tommyrohmann/Microgravity-Press-Washing-Machine/Code/ESP Pinout.jpg

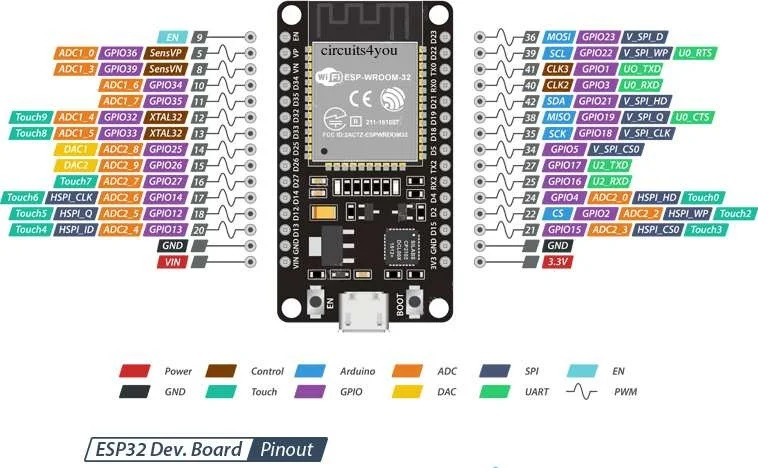
Code/ESP Pinout.jpg
