tommyrohmann/Microgravity-Press-Washing-Machine/Code/Dev/fb3f23a709487965b63c21f0c4c082e6.png

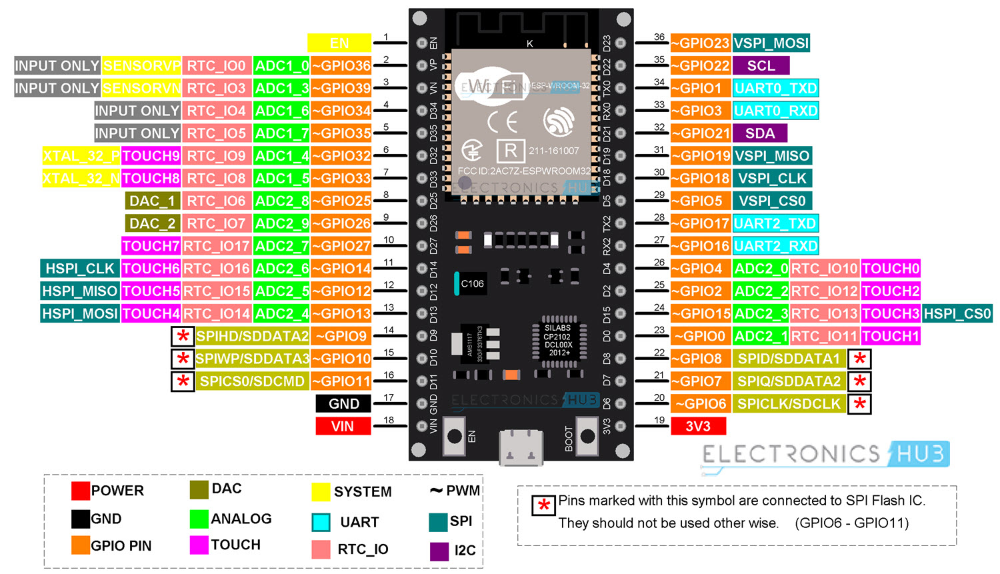
Code/Dev/fb3f23a709487965b63c21f0c4c082e6.png
