tommyrohmann/Microgravity-Press-Washing-Machine/ESP32 Pinout.pptx

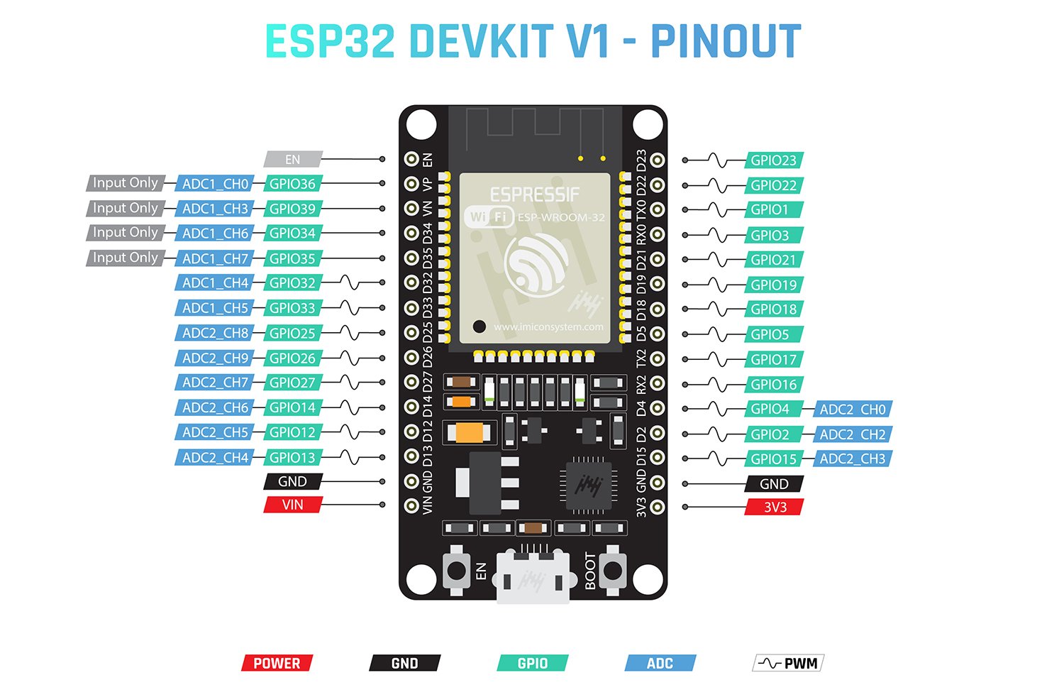
[picture p3: figure]
Esp32 Devkit V1 Pinout And Specification 58 Off/esp32 Analog Pinout
