tommyrohmann/Microgravity-Press-Washing-Machine/CAD Design Work/Electronics/Model Sources.docx

https://grabcad.com/library/raspberry-pi-4-model-b-1
