tommyrohmann/Microgravity-Press-Washing-Machine/Other/Showcase Files/06-12-24/Scope Of Design 2023.docx

Scope of Design for Microgravity Press Washing Machine 2023

Previous iterations of the Microgravity Press Washing Machine have all been to prove various aspects of the design without accounting for select criteria that were not determined to be critical to the working principle or concept.

The current iteration of this design is designed to fulfill all initial criteria for the Microgravity Washing Machine problem while successfully carrying out the full wash cycle in a controlled, automated, and repeatable manner.

Though the prototype built in this stage of development will not have certain hardware functions identified to be advantageous to the design, the core function of the washing machine will be fully realized, and will serve as a fundamental base-line for this project. This baseline will inform which hardware improvements must be made to the design to further improve on the concept in later versions.

In summation, this prototype will serve as a baseline for the fundamental functions of the design, and allow for ease of experimentation and pertinent data collection. This design will be made to be iterated on in various directions depending on the results of the given experiments.
