tommyrohmann/Microgravity-Press-Washing-Machine/Documentation Files.docx

Washing machine documentation:

Definitions

- Dead volume etc

Working Principles

- Wash process
- Fluid separation and avoiding free surface effects
- Compression force vs fluid pressure

PV=nRT

P_1 V_1 =P_2 V_2

V=C-S

P_1 (C_1 -S)=P_2 (C_2 -S)

P_1 C_1 -P_1 S=P_2 C_2 -P_2 S

P_2 S-P_1 S=P_2 C_2 -P_1 C_1

S=(P_2 C_2 -P_1 C_1)/(P_2 -P_1)

Procedure:

Pre-wash leak check: pull vacuum on chamber, wait preset time, if vacuum maintained continue, if not throw error.

At beginning piston position, internal volume is known. Measure pressure (ambient)

Compress piston by known amount, leaving a known chamber volume. Measure pressure.

Calculate true volume.

Compress clothing item to maximum compression. Known piston location, yields compressed volume

If compressed volume is not large compared to true volume, compression not sufficient and throw error.

Compressed volume-true volume=dead volume

Add known machine dead volume in pipes.

For the target cleanliness (say deep clean is 95%, standard 80%, economy 60%, roughing wash 40% etc.), find required water for given load size.

Run wash cycle with given water allowance

P_2

P_1

C_2

C_1

V_T =Unknown volume of clothing itme

VT: True Volume,
VC: Compressed Volume
VD: Dead Volume,
VH: Heap Volume

The floating piston washing machine washes clothing by means of slow speed fluid displacement and compression. Moving fluids allows for control over how different fluids are moved through the machine to support the wash process. During a wash process, the clothing item has water introduced, is agitated, and then has water removed to accomplish the goal of cleaning soiled clothing.

Displacement and compression are accomplished by the wash pump, which pumps water to either side of the wash piston. When compressing the clothing item, water is pumped into the reservoir under high pressure, which compresses the clothing item.

P&ID Diagram

Electrical diagram

Control Loop

The washing machine follows wash instructions as a simple state machine. An individual step of the wash process includes instructions as to output values that control which valves should be open, or which pump should be running, and a specified sensor and value which corresponds with the end of the current step. Once the end condition of a given step in the wash cycle, the next set of instructions is read and carried out until the wash cycle is complete.

For various clothing items and desired cleanliness, multiple wash cycles and variations of a given wash cycle could be desired by the user. To accommodate this, the automation of the washing machine is accomplished by reading an instruction file, which is human readable and editable in excel or software capable of reading .xsml files.

When the washing machine reads and executes the wash process, it is accomplished in a set of steps

Load selected human wash instruction file as pandas data frame

Select first line of instructions

Preprocessing of the selected wash step and interpret instructions

Package instruction set and send to microcontroller

Telemetry loop

When end state is detected, select next set of wash instructions to be interpreted

Sample wash process:

List of end effectors

Valves

3-way valve air vent/vacuum

Downstream 3-way wash pump reversing valve

Upstream 3-way wash pump reversing valve

Wash chamber valve

Clean/inlet valve

Soiled/outlet valve

Reservoir-space vale

Compensations-pace Valve

Wash pump

Vacuum pump

Detergent pump

Not included

Water heater

Hatch lock solenoid

Retention tank valve

Sensors

Wash chamber pressure transducer

Reservoir pressure transducer

Estop

Not included

Flow meter

Piston positional sensor

Interseal leak transducer

UI control screen

Manual mode – run everything by pressing toggle buttons on raspberry pi

Wash cycle select

settings

Run process

Telemetry screen

Pause process

Stop process

Wash Process Functions

Determination of dead volume

Water budget

Target cleanliness
