tommyrohmann/Microgravity-Press-Washing-Machine/NASA Meeting 05-19-2023/Project Update Slideshow.pptx

## Microgravity Washing Machine Project Update

## Personal Background

2019-2020 NASA HUNCH Design Competition Semi-Finalist from Glenelg High School
Currently studying for B.E. Naval Architecture with USCG Unlimited Engine License at SUNY Maritime College, going into senior year

## Progress Since NASA HUNCH 2019-2020

1st Prototype: More to demonstrate design features groupmates did not believe would work. Initially getting
2nd Prototype: Prototype designed to test design efficacy disregarding project constraints
Prototype Design Testing: Determine

## What Has Changed Since Starting the Project?

Project Requirements
- 1000 mL of water allowance for washing 1 clothing
- Detergents for space became a possibility
Washing Machine Design
- Compression found to be instrumental to agitation
- Orientation of washing machine components

## Design Process for Prototype

Multiple parts of the design can be built independently from other design aspects, these include:
1. Frame and structural assembly
2. Drive system for the pistons
3. Electronic control system
4. System piping

## Design Frame and Structure

From loading requirements:
1. Given EXPRESS Locker dimensions, design frame maximizing space in vertical direction of piston travel
2. Use frame dimensions to determine piston travel and get maximized dimensions for wash chamber

## What is Needed for This Project to Move Forward

- Time
- Consultation on Design Features and Prototype Creation
