tommyrohmann/Microgravity-Press-Washing-Machine/Other/Sort/iLogic.docx

ILogic

04 AUTODESK INVENTOR ilogic Tutorial ( Variables ) (youtube.com) (https://www.youtube.com/watch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)

Tutorial Inventor - 151 iLogic for Assemblies (youtube.com) (https://www.youtube.com/watch?v=YDInUcrTcwk&ab_channel=ConstantinStancescu)

Inventor Animations

Inventor 2014 Help: Studio - Animations (autodesk.com) (https://help.autodesk.com/view/INVNTOR/2014/ENU/?guid=GUID-D4E8F0DD-F622-43EA-BD6F-A0DBB6025F49)

Modal Stress Analysis

Inventor 2014 Help: Part Modal and Stress Analysis (autodesk.com) (https://help.autodesk.com/view/INVNTOR/2014/ENU/?guid=GUID-ADEAAB90-A0B9-4663-A066-2C124827DB8D)

Sheet Metal

Inventor 101: Sheet Metal Basics | Autodesk Virtual Academy (youtube.com) (https://www.youtube.com/watch?v=wMrZ-nHitSo&ab_channel=KETIVTechnologies)

Tube and Pipe

Using Tube & Pipe in Inventor Professional 2021 | Autodesk Virtual Academy (youtube.com) (https://www.youtube.com/watch?v=IEURRpiXw0A&ab_channel=KETIVTechnologies)
