tommyrohmann/Microgravity-Press-Washing-Machine/Other/Sort/Temp.docx

https://ntrs.nasa.gov/api/citations/20220006013/downloads/Clothes%20Cleaning%20for%20Space%20Research%20ICES%202022%20-%20Final.pdf

Tide Infinity was also designed to use 15 liters of water per load or less to wash roughly 4.5-5.0 kg (10-11 lbs.) of clothing twice a week for a crew of 4.
