tommyrohmann/Microgravity-Press-Washing-Machine/Wash Cycle Papers/Drying Cycle Capabilities.docx

# Drying Cycle Capabilities

Tommy Rohmann 2026

Flash Drying

For each clothing item, there is a maximum amount of water that can be removed by compression. From this point the clothing item can be taken out to dry.

Alternatively, a drying cycle could be utilized to remove more water. This can be done utilizing the existing vacuum pump used to evacuate air.

The piston can be retracted, drawing in a small amount of air to prevent water from coalescing into droplets. A vacuum can be drawn using the vacuum pump. At this lower pressure, the boiling point of the water is decreased. Under vacuum, the temperature of saturated steam can be as low as 54 degrees F. More realistically, a maintained vacuum of 28 hg can be maintained, making the boiling point of water between 70 F and 100 F. Although using a heating element would use a significant amount of power

Vacuum can again be drawn on the wash chamber

If the water is heated
