tommyrohmann/Microgravity-Press-Washing-Machine/Pinout.xlsx

D/A/PWM/internal | I/O | Pin Assignment | Instruction Label | Use | Notes
pwm | O | 32 | oVA | Air/Vacuum Selector V/v | 3-Way
pwm | O | 33 | oVR1 | Wash Pump Reversal V/v #1 | 3-Way
pwm | O | 25 | oVR2 | Wash Pump Reversal V/v #2 | 3-Way
pwm | O | 26 | oVWC | Wash Chamber V/v | 2-Way
pwm | O | 27 | oVCW | Clean wtr In V/v | 2-Way
pwm | O | 14 | oVSW | Soil wtr out V/v | 2-Way
pwm | O | 12 | oVRT | Reservoir Tk V/v | 2-Way
pwm | O | 13 | oVCT | Compression Tk V/v | 2-Way
D | O | 21 | oPW | Wash Pump
D | O | 22 | oPV | Vacuum Pump
D | O | 19 | oPD | Detergent Pump
D | O | 23 | oVB | V/V Adj Bus Relay | Normally Open, Unused in Wash Instructions, controlled by microcontroller
D | I | 35 | iES | E-Stop detect
- | - | 34 | - | Sensor unused
A | I | 39 | iPT1 | Wash Chamber Press Transducer | VN input only pin
A | I | 36 | iPT2 | Tank Press Transducer | VP input only pin
internal | - | - | iT | Time
internal | - | - | idT | Change in Time | Internally Found
internal | - | - | iTS | Start Time of Instruction Execution
