tommyrohmann/Microgravity-Press-Washing-Machine/System Design and Documentation/Electronic Control Systems/mgpws_working_code/Dev Aid Files/MachineConfig/Config Layout.xlsx

Sheet: Software_Config
Constants | Global Base Folder File Path | NA
 | Data Storage Location | NA
 | Wash Process Instructions Location | NA
 | PreProcess Instructions Location | NA | Set of Instruction checks done every time a wash is initiated
Variables | Machine_Run_Hours | 0
 | Machine_Idle_Hours | 0
 | Wash_Counter | 0
 | Default_Wash_Cycle_Name | Default_Wash

Sheet: Sensor_Value_Return_Format
Index | Sensor_Name | Variable_Name | Var_Type | Units | Sensor State
1 | Wash_Phase_Status | WPS | int | NA
2 | Reservoir Pressure | P_Res | float | PSI
3 | Wash Chamber Pressure | P_Wash | float | PSI
4 | Load Cell 1 | LC_Wash_1 | int | lbf
5 | Load Cell 2 | LC_Wash_2 | int | lbf
6 | Load Cell 3 | LC_Res_1 | int | lbf
7 | Load Cell 4 | LC_Res_2 | int | lbf
8 | Net Force Wash Piston | NF_W | int | lbf | Derived - Absolute value of Net Force
9 | Net Force Reservoir Piston | NF_R | int | lbf | Derived- Absolute value of Net Force
10 | Delta Force Wash Piston | DR_W | int | lbf | Derived- Absolute value of Delta Force
11 | Delta Force Reservoir Piston | DF_R | int | lbf | Derived- Absolute value of Delta Force
12 | Valve Actuator Current Sensor | CS_VV | float | amps
13 | Washing Machine Current Sensor | CS_WS | float | amps
14 | Wash Rotary Encoder | RE_Wash | int | in
15 | Reservoir Rotary Encoder | RE_Res | int | in
16 | Reservoir Full Retract Limit Switch | LS_RFR | int | bool | Digital High, Depresses Switch Opens Circuit
17 | Piston Travel Conflict Limit Switch | LS_PTC | int | bool | Digital High, Depresses Switch Opens Circuit
18 | Wash Full Extend Limit Switch | LS_WFE | int | bool | Digital High, Depresses Switch Opens Circuit
19 | Emergency Stop | E_Stop | int | bool | Digital Low, Depressed Switch Control Closes Circuit
20 | Wash Chamber Limit Switch | Wash_Chamber_LmSw | int | bool | Digital High, Depresses Switch Opens Circuit
21 | Wash Phase Elapsed Time | ET | int | ms | T=0 at Start of Sub-Phase
22 | Total Elapsed Time | TET | int | ms | T=0 at Start of Process

Sheet: RPI_Phys_Conn_Config
Function | Connection Type
Touch Screen | Ribbon Cable
Serial Bus 1 TX | USB
Serial Bus 1 RX | USB
Stop Signal Send | W
Reset Signal | W | High, Low Resets
Power | PWR
Ground | GND

Sheet: Wash_Instruct_File_Format
Function | Collumn_Index | Actuator_Name | Variable_Name | Data_Type | Data_Mode
Metadata/Display | 1 | Wash State Name | WSN | str | [Name of Wash State in Cycle]
Metadata/Display | 2 | Sub State Name | SSN | str | [Substate of Wash State]
ESP Instructions | 3 | Washwater Inlet Valve | VA_WWI | int | [OPEN/CLOSED]
ESP Instructions | 4 | Washwater Outlet Valve | VA_WWO | int | [OPEN/CLOSED]
ESP Instructions | 5 | Cross-over Valve | VA_XO | int | [OPEN/CLOSED]
ESP Instructions | 6 | Air Valve | VA_A | int | [OPEN/CLOSED]
ESP Instructions | 7 | Valve Bus | VB | int | [ON/OFF]
ESP Instructions | 8 | Wash Piston Drive Motor | DM_Wash | arr | ([FWD/REV/OFF],[Speed])
ESP Instructions | 9 | Reservoir Piston Drive Motor | DM_Res | arr | ([FWD/REV/OFF],[Speed])
ESP Instructions | 10 | DetergentDosingPump | P_DD | int | [ON/OFF]
ESP Instructions | 11 | Next State Trigger | NST1 | arr | (([Sensor Index],[<,>],[Value]),…)
ESP Instructions | 12 | Next State Trigger | NST2 | arr | (([Sensor Index],[<,>],[Value]),…)
ESP Instructions | 13 | State Specific Safety Trigger | S3T | arr | (([Sensor Index],[<,>],[Value]),…)
