tommyrohmann/Microgravity-Press-Washing-Machine/Code/Dev/Software Layout Explainer.docx

## Config Directory

Functional Files required for washing machine operation

### BootData

This section saves data to be transferred between boots. These include:

- Washing Machine Idle Time
- Washing Machine Run Time
- Current Wash Process Number
- Wash Process Default Path
- Wash Modifier Path

### SensorList

### InstructOutputList

List of instruction format to be entered to

Wash Instructions and packaging Pipeline

1) Wash Instructions
  a. Human readable and easily editable in excel
2) Instructions Package
  a. Converts human readable wash instructions to succinct data packages to be sent to microcontroller.
  b. Display aids (Such as wash state name) that are not used by microcontroller is stripped from message
  c. Instruction type added to beginning of data package
  d. Instruction Variables referenced from wash modifier and set for package
  e. Output Labels converted to Package Labels
  f. Labels and Instructions formatted to be sent
    i. “;” item delimiter
    ii. “:” key/definition delimiter
    iii. “,” list item delimiter
