tommyrohmann/Microgravity-Press-Washing-Machine/Other/Showcase Files/FEM.docx

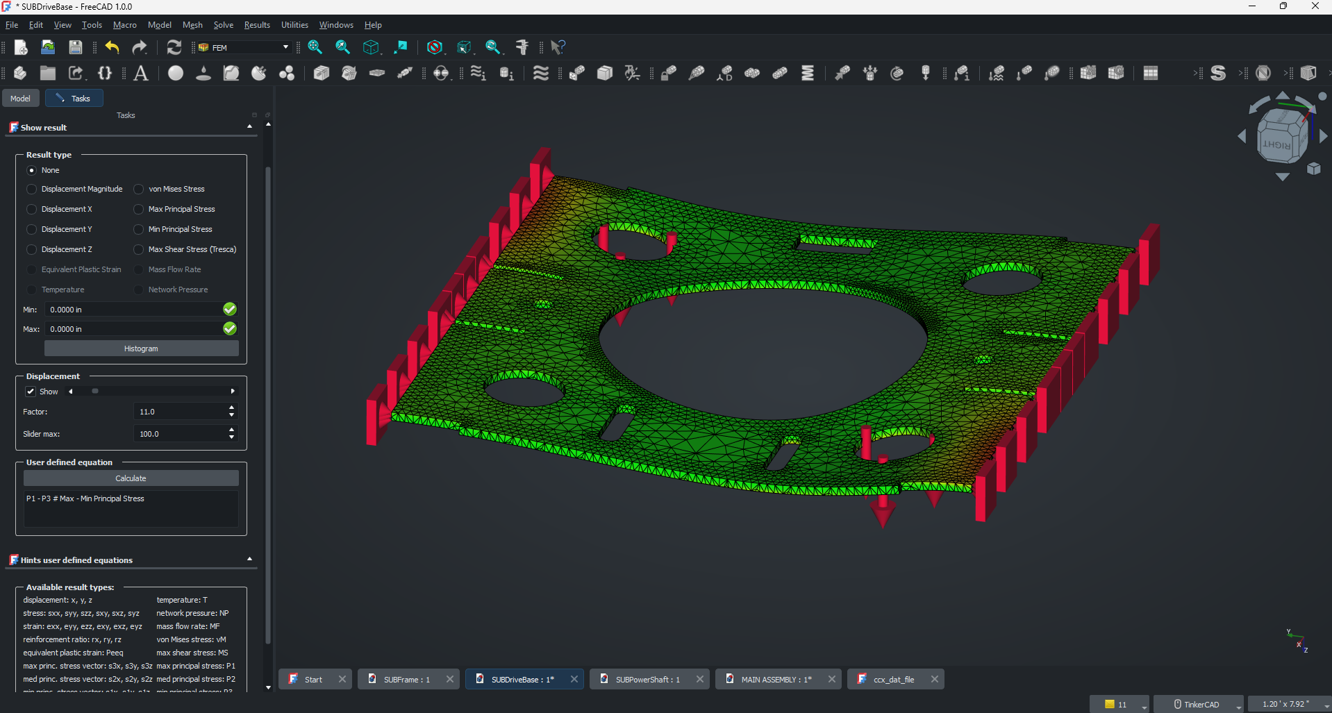
[picture p15: figure]
