tommyrohmann/Microgravity-Press-Washing-Machine/Other/Resources and External Links/Wash Method Research.docx

Preliminary Research, subject matter uncovered though the use of ChatGPT to expedite research process, and for the most part, this documentation is copied from these inquiries on the website.

There are several methods employed to wash clothing, ranging from mechanical agitation to various chemical and disinfection processes. These methods can be found in both household washing machines and industrial laundry services. Here are some examples:

1. **Mechanical Agitation:**

- **Agitator Washing Machines:** These machines use a central agitator to create mechanical agitation by rotating and moving clothes around in a mix of water and detergent. This method helps to dislodge dirt and stains from fabrics.

- **Impeller Washing Machines:** Similar to agitator machines, these use a rotating impeller at the bottom of the drum to create turbulence and move clothes around.

2. **Tumble Action:**

- **Front-Load Washing Machines:** These machines have a drum that rotates on a horizontal axis. The tumbling action of the drum helps to clean clothes more gently compared to agitator-based machines.

3. **High-Efficiency (HE) Washing:**

- **Low Water Usage:** HE washing machines use less water and are designed to be more efficient in cleaning clothes. They rely on increased mechanical action and specialized detergents to remove stains.

4. **Steam Cleaning:**

- **Steam Washers:** These machines use high-temperature steam to clean and sanitize clothes. The steam helps to loosen dirt, stains, and odors from fabrics.

5. **Ultrasonic Cleaning:**

- **Ultrasonic Washing Machines:** Ultrasonic waves create high-frequency vibrations in the water, generating tiny bubbles that implode and release energy. This energy helps dislodge dirt and stains from clothing fibers.

6. **Ozone Disinfection:**

- **Ozone Laundry Systems:** Ozone (O3) is used as a powerful disinfectant and stain remover. It's added to the wash cycle, and its oxidative properties help break down organic matter and kill bacteria, viruses, and other pathogens.

7. **Enzyme-based Cleaning:**

- **Enzymatic Detergents:** Enzymes in these detergents break down protein, starch, and fat-based stains, making them effective for removing food, blood, and grass stains.

8. **Biological Laundry Detergents:**

- **Biological Detergents:** These contain enzymes produced by microorganisms to break down stains. They can be effective at lower temperatures, saving energy.

9. **Bleach and Oxidation:**

- **Chlorine Bleach:** Used to whiten and disinfect clothes. It's effective against mold, mildew, and certain stains, but can be harsh on fabrics.

- **Hydrogen Peroxide:** A milder alternative to chlorine bleach, it can brighten colors and remove stains.

10. **pH Adjustment:**

- **Alkaline Washes:** Some industrial processes use high pH solutions to help remove oily and greasy stains.

11. **Solvent-based Cleaning:**

- **Dry Cleaning:** Uses solvents like perchloroethylene to remove stains without using water. Common for delicate fabrics.

12. **Ionization and Electrolysis:**

- **Electrolyzed Water:** Electrolysis is used to create cleaning solutions with positively and negatively charged particles, which can help break down dirt and stains.

These methods can vary in effectiveness, environmental impact, and suitability for different types of fabrics and stains. Industrial washing machines and laundry services often employ a combination of these methods to achieve thorough and efficient cleaning results.
