tommyrohmann/Microgravity-Press-Washing-Machine/Code/DC Wire Gage Chart.pdf

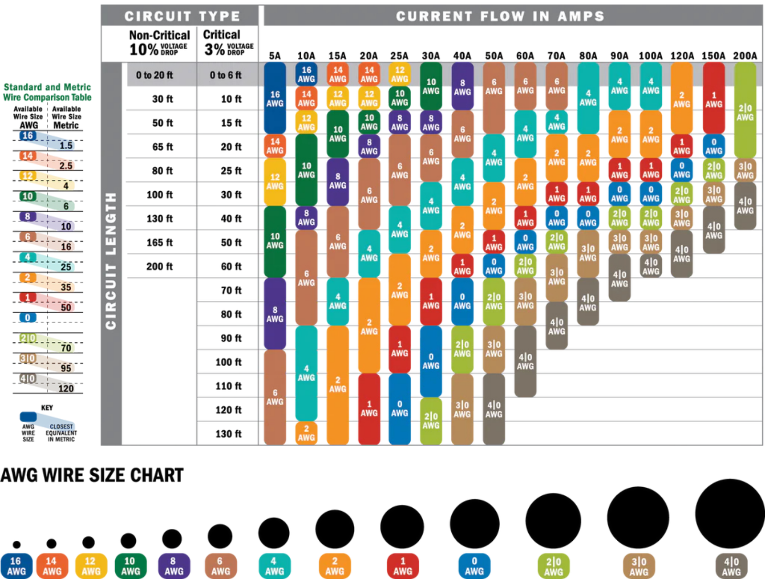
[picture p18: page 1]
