tommyrohmann/Microgravity-Press-Washing-Machine/Chain Drive - OLD/V2/V2 Overview.docx

# Microgravity Press Washing Machine

The previous version was complicated, had many failure points, and had to be heavy due to high structural loads

- Piston Shaft Volume Problem
- Piston Travel Equation
- High weight due to

Good Parts

- Flexible Load Characteristics and Sizes
- Fluid Separation during process

To greatly reduce components, weight, and complexity, the drive system can be removed. In its place, wash water will be the working medium to generate the compression forces required for the wash process. The piston is now free floating since force no longer needs to be transmitted from an outside source.

## Leak Mitigation

Pressurizing water does add inherent risks to this system. A failure can result in the contents being released into the spacecraft environment directly. Large volumes associated with an unattended wash process could potentially damage other equipment if not found in a timely manner.

In actuality, while high pressure could increase risk of spraying from a leak, high displacement of volume poses a greater risk to

Procedural mitigation – pre-process testing

Before every wash process is run, the various chambers can be charged with an air at an elevated pressure. If the wash chamber holds pressure, then there is no leak. Water charged into the upper chamber must pass through both the piston, and hatch seal before escaping in this test

Water Leak-off fail system

If water leaks off, a secondary set of seals must be breached before water can escape to the environment. By putting a leak-off port after the primary seals, water leaking by will flow through the leak-off port, where it can be detected. This can trigger an alarm and stop to the process before
