tommyrohmann/Microgravity-Press-Washing-Machine/BOM/Bill of Materials 5-18-2025.pdf

Total Cost 2244.5
or units of mass or length$/kg
Purchase or Fabrication? Electronic? System | Part of Assmbly | Part Name | # Parts Req Link | Price/Pkg Parts/Pkg Pkgs to OrderCost of PartsNotes | Date Updated
$ | E | P | ActuatedBallValve | Servos for Ball Valves | 4 https://www.amazon.com/gp/product/B07NQJ1VZ2/ref=ppx_yo_dt_b_search_asin_title?ie=UTF8&th=1 16.99 | 4 | 1 | 16.99 Torque of 14 Nm | 5/18/2025
$ | P | ActuatedBallValve | Servo Horns | 4 https://www.amazon.com/gp/product/B07TJ8M238/ref=ppx_yo_dt_b_search_asin_title?ie=UTF8&psc=1 8.69 | 2 | 2 | 17.38 | 12/6/2024
$ | P | ActuatedBallValve | Servo Horn Screws | 4 https://www.amazon.com/gp/product/B012TE12CY/ref=ppx_yo_dt_b_search_asin_title?ie=UTF8&psc=1 5.99 | 60 | 1 | 5.99 | 12/16/2024
P | ActuatedBallValve | Servo Extension Cord Lead Wire Cable Connectors | 4 https://www.amazon.com/gp/product/B08HWMRKRZ/ref=ppx_yo_dt_b_asin_title_o00_s00?ie=UTF8&psc=1 12.99 | 30 | 1 | 12.99 | 12/16/2024
$ | P | ActuatedBallValve | 1/4" Pex Push Ball Valve | 4 https://www.amazon.com/dp/B019U87UQ4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 8.85 | 10 | 1 | 8.85 Turning Resistance X Nm | 12/6/2024
3DP | P | ActuatedBallValve | Valve Actuator Ball Valve Mounts | 4 NA | 0 | 1 | 4 | 0 3D Printed with PLA | 12/6/2024
$ | E | P | Pressure TransducerP/V Transducer, 1/8" NPT | 2 https://www.amazon.com/gp/product/B0CFJ7QNT4/ref=ppx_yo_dt_b_search_asin_title?ie=UTF8&psc=1 22.99 | 1 | 2 | 45.98 | 12/6/2024
$ | P | Piping | 1/4" Pex Push Tee Fitting | 2 https://www.amazon.com/Malida-Connect-Reverse-Osmosis-System/dp/B00YYKB9K2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 6.99 | 10 | 1 | 6.99 All Blue numbers altered slightly due to qty changes 5/17/2025
$ | P | Piping | 1/4" OD PEX Pipe | 1 https://www.amazon.com/gp/product/B08FCQKH2F/ref=sw_img_1?smid=A240VLH05F6IET&th=1 9.99 | 300 | 1 | 9.99 | 5/17/2025
$ | P | Piping | 1/4" Pex Push Elbow 90 | 1 https://www.amazon.com/gp/product/B01NBO4Q9F/ref=ewc_pr_img_2?smid=A1BU77VE99X2YG&psc=1 6.99 | 10 | 1 | 6.99 | 12/17/2024
$ | P | Piping | 1/4" PEX to 1/4" Male NPT | 3 https://www.amazon.com/YZM-Connector-fittings-Purifiers-accessories/dp/B01MRWDTZ2 6.99 | 5 | 1 | 6.99 | 2/6/2025
$ | P | Piping | 1/4" FNPT Coupling | 3 https://www.amazon.com/gp/product/B0C9C55H6K/ref=ewc_pr_img_4?smid=A1XIBCJEAGERRU&psc=1 7.99 | 5 | 1 | 7.99 | 12/6/2024
$ | P | Piping | 1/4" PEX to 1/2" Male NPT | 4 https://www.amazon.com/Malida-Connect-Fitting-Reverse-Osmosis/dp/B01M2XEJZA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 7.49 | 10 | 1 | 7.49 | 5/17/2025
$ | P | Piping | 1/4 Inch OD PVC Clear Vinyl Tubing | 2 https://www.amazon.com/dp/B08SPBSCHX?ref=ppx_yo2ov_dt_b_fed_asin_title 7.79 | 20 | 1 | 7.79 | 5/17/2025
$ | P | Piping | 1/4" MNPT to 1/4" Barb Fitting | 2 https://www.amazon.com/gp/product/B087QBPHC6/ref=sw_img_1?smid=A13YYJYWLZVHOX&psc=1 7.99 | 5 | 1 | 7.99 | 5/17/2025
$ | P | Piping | Check Valve | 1 https://www.amazon.com/ESHIONG-Straight-Reverse-Fittings%EF%BC%881-Purifiers%EF%BC%89/dp/B088DDX593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 10.99 | 6 | 1 | 10.99 | 12/17/2024
$ | P | Piping | Pressure Relief Valve | 0 NA | 0 | 1 | 0 | 0 Not Included In Current Design 12/16/2024
$ | P | Pressure Transducer1/4" PEX to 1/8" FNPT | 2 https://www.amazon.com/Female-Connect-Fittings-CEKER-Pneumatic/dp/B07VLLRWY5 9.99 | 5 | 1 | 9.99 | 12/16/2024
$ | E | P | Detergent Dosing | Peristaltic Dosing Pump | 1 https://www.amazon.com/gp/product/B07GWJ78FN/ref=ppx_yo_dt_b_search_asin_title?ie=UTF8&psc=1 9.89 | 1 | 1 | 9.89 | 12/17/2024
$ | P | Detergent Dosing | 1/8 Inch Barb × 1/4 Inch NPT Barb Fitting | 1 https://www.amazon.com/gp/product/B0CLYC9GGB/ref=ppx_yo_dt_b_asin_title_o01_s00?ie=UTF8&th=1 8.99 | 6 | 1 | 8.99 | 12/17/2024
P | Detergent Dosing | Peristaltic Tubing 3mm | 1 https://www.amazon.com/gp/product/B0799FKWQ9/ref=ppx_yo_dt_b_search_asin_title?ie=UTF8&th=1 13.99 | 3 | 1 | 13.99 | 12/16/2024
$ | P | Detergent Dosing | Zip Ties | 1 https://www.amazon.com/gp/product/B08TBM621K/ref=sw_img_1?smid=A31038Z1OTUQXB&psc=1 15.99 | 1 | 1 | 15.99 | 5/17/2025
$ | E | P | Detergent Dosing | 5/32" Barb Fitting Check Valve | 2 https://www.amazon.com/gp/product/B08JG653K3/ref=ppx_yo_dt_b_asin_title_o08_s00?ie=UTF8&th=1 8.99 | 5 | 1 | 8.99 | 12/16/2024
$ | WC | Wash Chamber | 4" SCH 40 PVC Pipe Clear | 1 https://www.amazon.com/gp/product/B07VD4RYXT/ref=ppx_yo_dt_b_search_asin_title?ie=UTF8&th=1 38.6 | 1 | 1 | 38.6 | 12/17/2024
$ | WC | Wash Chamber | Wash Chamber Conduit | 1 https://www.amazon.com/cart/smart-wagon?newItems=24150dec-9475-4f45-8ed1-eff11e066025,1&ref_=sw_refresh 67.99 | 1 | 1 | 67.99 | 1/27/2025
$ | WC | Wash Chamber | Castle Spacer | 1 NA | 0 | 1 | 1 | 0 Segment of Pipe Used Instead12/20/2024
$ | WC | Wash Chamber | Conduit Static Seal O-Ring | 2 https://www.mcmaster.com/9452K407/ 7.69 | 4 | 1 | 7.69 | 3/30/2025
$ | WC | Access Hatch | Access Hatch Plastic Stock | 1 - | 0 | 1 | 1 | 0 | 12/20/2024
$ | WC | Access Hatch | Access Hatch Lower O-Ring | 1 https://www.mcmaster.com/9452K209/ 10.58 | 10 | 1 | 10.58 | 5/17/2025
$ | WC | Access Hatch | Access Hatch Lower O-Ring | 1 https://www.mcmaster.com/9452K99/ 23.53 | 10 | 1 | 23.53 | 2/8/2025
$ | WC | Access Hatch | Mortice Latch 35mm | 1 https://www.amazon.com/dp/B0BM8X97NS?ref=ppx_yo2ov_dt_b_fed_asin_title&th=1 8.35 | 1 | 1 | 8.35 | 2/8/2025
$ | WC | Wash Piston | 1' Polyethylene Round Stock 4" Diameter | 1 https://www.amazon.com/gp/product/B07Y5KY2GT/ref=ppx_yo_dt_b_asin_title_o09_s00?ie=UTF8&psc=1 70.98 | 1 | 1 | 70.98 Used for Lid,,Reservior, and Wash Pistons 5/17/2025
$ | WC | Wash Piston | Wash Piston Dynamic Seals | 2 https://www.mcmaster.com/9505K121/ 13.76 | 1 | 2 | 27.52 | 5/17/2025
$ | WC | Wash Piston | Wash Piston Rod | 11.6 https://www.amazon.com/dp/B0B6FK69N1?ref=ppx_yo2ov_dt_b_fed_asin_title&th=1 27.5 | 12 | 1 | 27.5 | 0.875 5/17/2025
$ | WC | Wash Piston | Wash Piston Stay Pin | 4 https://www.amazon.com/PRECISION-METALS-87143-12-Rod/dp/B0006NAUO2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 5.99 | 12 | 1 | 5.99 .375" Rod, tapped at ends 2/11/2025
$ | WC | Wash Piston | Wash Piston Rod Static Seals | 2 https://www.mcmaster.com/9452K27/ 5.98 | 100 | 1 | 5.98 .875 OD | 5/17/2025
$ | WC | Reservior Piston | Reservior Piston Dynamic Seals | 2 https://www.mcmaster.com/9505K121/ 13.76 | 1 | 2 | 27.52 | 2/11/2025
$ | WC | Reservior Piston | Reservior Piston Rod Dynamic Seals | 2 https://www.mcmaster.com/9505K22/ 5.01 | 1 | 2 | 10.02 .875" ID | 4/12/2025
$ | WC | Reservior Piston | Reservior Piston Shafts | 4 https://www.amazon.com/gp/product/B0DM9Q9PYW?smid=AR88GRBHPCMHU&psc=1 8.73 | 4 | 1 | 8.73 | 5/17/2025
$ | WC | Reservior Piston | Reservior Piston Springs | 4 | 1 | 4 | 0 Experimentation Needed to see what spring constant is needed 5/18/2025
$ | WC | Reservior Piston | 1/2" Shaft Collar | 8 https://www.amazon.com/Yeebyee-Collars-Machinery-Industrial-Silver-1/dp/B0BYJWLKT7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 10.99 | 8 | 1 | 10.99 | 4/12/2025
$ | DA | Drive Nut | Set Screw Set M3-M8 | 1 https://www.amazon.com/dp/B0B2N57KB4?ref=ppx_yo2ov_dt_b_fed_asin_title&th=1 7.99 | 1 | 1 | 7.99 Used for other purposes | 5/17/2025
$ | DA | Drive Nut | Drive Nut 1" Brass Machine Stock | 4 https://www.amazon.com/C360-Brass-Square-Solid-Stock/dp/B08XWC3WBH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 23.99 | 2 | 2 | 47.98 | 5/17/2025
$ | DA | Drive Nut | Grease Fittings | 25 https://www.amazon.com/dp/B07MC8SZQL?ref=ppx_yo2ov_dt_b_fed_asin_title 8.99 | 4 | 7 | 62.93 | 5/17/2025
$ | E | DA | 8mm | Drive Motor | 2 https://www.amazon.com/gp/product/B0DKX73BXJ/ref=ppx_yo_dt_b_search_asin_title?ie=UTF8&th=1 56.3 | 1 | 2 | 112.6 | 5/17/2025
$ | E | DA | 8mm | Motor Controller | 1 https://www.amazon.com/dp/B0D11B8727?ref=ppx_yo2ov_dt_b_fed_asin_title&th=1 24.99 | 2 | 1 | 24.99 | 5/17/2025
$ | DA | 8mm | 8mm Shaft Coupling | 2 https://www.amazon.com/gp/product/B07P5YZKY5/ref=ppx_yo_dt_b_asin_title_o00_s00?ie=UTF8&th=1 8.99 | 2 | 1 | 8.99 | 5/17/2025
$ | DA | 8mm | 8mm Flanged Journal Bearings | 4 https://www.amazon.com/gp/product/B085D8TB8Z/ref=ewc_pr_img_2?smid=A1THAZDOWP300U&th=1 9.99 | 10 | 1 | 9.99 | 12/20/2024
$ | DA | 8mm | 11 Tooth Sprocket, 8mm Bore, for #25 Chain | 2 https://www.amazon.com/gp/product/B0CD1RN4ND/ref=sw_img_1?smid=A30WUG2ZDGM0XM&psc=1 12.29 | 2 | 1 | 12.29 | 1/4/2025
$ | DA | 8mm | 8mm Drive Shaft | 2 https://www.amazon.com/gp/product/B082ZMGJ9B/ref=sw_img_1?smid=A1THAZDOWP300U&psc=1 8.19 | 2 | 1 | 8.19 | 12/20/2024
$ | DA | #25 Chain, 1/4" Pitch | 8 https://www.amazon.com/gp/product/B07NPS78VG/ref=ppx_yo_dt_b_asin_title_o00_s01?ie=UTF8&psc=1 16.91 | 10 | 1 | 16.91 8 ft estimated needed | 12/20/2024
$ | DA | 1/2" | 1/2" Flanged Journal Bearings | 20 https://www.amazon.com/gp/product/B07YDK97WZ/ref=ppx_yo_dt_b_asin_title_o00_s00?ie=UTF8&th=1 12.88 | 10 | 2 | 25.76 | 12/20/2024
$ | DA | 1/2" | 25 Tooth Sprocket, 1/2" Bore, for #25 Chain | 8 https://www.amazon.com/gp/product/B0C7162LBN/ref=ppx_yo_dt_b_asin_title_o01_s00?ie=UTF8&th=1 9.99 | 2 | 4 | 39.96 4 to be machined so they can hold a bearing for idlers 5/18/2025
$ | DA | 1/2" | 1/2" ID Slim Bearings for Idlers | 8 https://www.amazon.com/gp/product/B0BMW3QD9Z/ref=ewc_pr_img_2?smid=A35BFBRDRD3RNK&th=1 12.49 | 10 | 1 | 12.49 To be inserted into Idlers and held in place with detents 1/4/2025
3DP | DA | 1/2" | 1/2" Shaft Spacer | 0 - | 0 | 1 | 0 | 0 | 1/4/2025
$ | DA | 6mm | #25 Tensioner Sprocket, 6mm Bore | 2 https://www.amazon.com/uxcell-Roller-Sprocket-Tensioner-Bearing/dp/B0CCW53KTM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 17.59 | 2 | 1 | 17.59 | 12/20/2024
$ | DA | 6mm | 6mm Shaft | 2 https://www.amazon.com/uxcell-200mm-Stainless-Steel-Solid/dp/B082ZNXYMG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 6.69 | 2 | 1 | 6.69 | 12/20/2024
$ | DA | 6mm | Adjustment Screw For Tensioner | 4 Missing | 0 | 1 | 4 | 0 | 5/18/2025
Fab | DA | 6mm | #25 Tensioner Bracket | 2 NA | 0 | 1 | 2 | 0 | 5/18/2025
3DP | DA | 6mm | 6mm Shaft Spacer | 4 NA | 0 | 1 | 4 | 0 | 12/20/2024
$ | DA | FOut | ACME Threaded Rod 1/2" - 10 (3 ft) | 2 https://www.mcmaster.com/98935A823/ 13.63 | 1 | 2 | 27.26 | 1/4/2025
$ | E | DA | FOut | HX711 Load Cell Amplifier | 4 https://www.amazon.com/gp/product/B07SGPX7ZH/ref=ppx_yo_dt_b_asin_title_o09_s00?ie=UTF8&psc=1 8.29 | 6 | 1 | 8.29 | 12/20/2024
$ | E | DA | FOut | 1000 kg Load Cell | 4 https://www.amazon.com/gp/product/B07VD6QWZL/ref=ppx_yo_dt_b_search_asin_title?ie=UTF8&psc=1 60.97 | 1 | 4 | 243.88 | 12/20/2024
$ | DA | FOut | Load Cell Mounting Screws | 32 https://www.amazon.com/dp/B08MZMK2JW?ref=ppx_yo2ov_dt_b_fed_asin_title&th=1 9.69 | 50 | 1 | 9.69 | 5/17/2025
$ | DA | FOut | M5 Mounting Nuts for Load Cell | 32 https://www.amazon.com/dp/B0D1X2YBLJ?ref=ppx_yo2ov_dt_b_fed_asin_title&th=1 6.99 | 100 | 1 | 6.99 | 5/17/2025
$ | DA | FOut | 1/2" Thrust Bearing | 8 https://www.amazon.com/uxcell-Bearings-Washers-19000rpm-Limiting/dp/B07VXSLNY5 9.99 | 5 | 2 | 19.98 | 12/20/2024
$ | DA | FOut | 1/2" ACME Nut | 8 https://www.mcmaster.com/94815A107/ 3.3 | 1 | 8 | 26.4 | 2/11/2025
$ | E | DA | Sensing | Limit Switches | 1 https://www.amazon.com/gp/product/B09NKYG5YQ/ref=ppx_yo_dt_b_asin_title_o09_s00?ie=UTF8&psc=1 7.99 | 10 | 1 | 7.99 Used for Safety System and 5/17/2025
3DP | DA | Sensing | Limit Switch Mount | 4 N/A | 0 | 4 | 1 | 0 | 5/17/2025
3DP | DA | Sensing | Optical Rotary Encoder Bracket | 2 N/A | 0 | 2 | 1 | 0 | 5/17/2025
$ | DA | Sensing | 8mm to 6mm Flex Coupling for Optical Encoder | 2 https://www.amazon.com/gp/product/B07YDD626R/ref=ewc_pr_img_1?smid=A4EE8R8C5DE8H&psc=1 8.39 | 2 | 1 | 8.39 | 1/4/2025
$ | E | DA | Sensing | Optical Rotary Encoder | 2 https://www.amazon.com/gp/product/B00Y9KDDCY/ref=ppx_yo_dt_b_asin_title_o02_s01?ie=UTF8&th=1 18.99 | 1 | 2 | 37.98 | 5/18/2025
$ | DA | Drive Frame Base | M3 Bearing Holding Screws | 100 https://www.amazon.com/dp/B0C1SF53HW?ref=ppx_yo2ov_dt_b_fed_asin_title&th=1 5.59 | 100 | 1 | 5.59 | 5/17/2025
$ | F | Drive Frame Base | 1/4" - 20 All Threaded Rod | 16 https://www.amazon.com/dp/B0CWG7NSJP?ref=ppx_yo2ov_dt_b_fed_asin_title&th=1 9.99 | 4 | 4 | 39.96 | 5/17/2025
$ | F | Drive Frame Base | 1/4" - 20 Nuts | 16 https://www.amazon.com/Bates-Stainless-Steel-Hardware-Metal/dp/B0CJ9FFH2Y/134-0072472-6555177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 6.85 | 50 | 1 | 6.85 | 5/17/2025
$ | F | Drive Frame Base | 1/4" ID Rod Spacer | 8 https://www.amazon.com/dp/B0CQ9NWZC7?ref=ppx_yo2ov_dt_b_fed_asin_title&th=1 31.18 | 10 | 1 | 31.18 | 5/17/2025
$ | F | Shear Frame | M3.5 Chain Link for Wire Rope | 1 https://www.amazon.com/dp/B0B4N2FXHF?ref=ppx_yo2ov_dt_b_fed_asin_title 6.99 | 8 | 1 | 6.99 | 5/18/2025
$ | F | Shear Frame | M5 Turnbuckle | 4 https://www.amazon.com/dp/B094MQJT3B?ref=ppx_yo2ov_dt_b_fed_asin_title&th=1&psc=1 8.49 | 2 | 2 | 16.98 | 5/17/2025
$ | F | Shear Frame | Wire Rope Fixtures | 1 https://www.amazon.com/dp/B08BFSYNY4?ref=ppx_yo2ov_dt_b_fed_asin_title 13.99 | 1 | 1 | 13.99 | 5/17/2025
$ | F | Shear Frame | Structural Wire Rope | 1 https://www.amazon.com/dp/B0C2KMQ3C2?ref=ppx_yo2ov_dt_b_fed_asin_title&th=1 26.99 | 100 | 1 | 26.99 | 5/17/2025
$ | F | Electrical Mounting | 24"x36" Aluminum Sheet .020" | 1 https://www.amazon.com/dp/B00291F0XA?ref=ppx_yo2ov_dt_b_fed_asin_title&th=1 28.9 | 1 | 1 | 28.9 | 5/17/2025
$ | F | Frame Plate | 1/8" .125" Hot Rolled Steel Sheet Plate 12"X 24" | 1 https://www.amazon.com/dp/B0BQC8QDQL?ref=ppx_yo2ov_dt_b_fed_asin_title 40 | 1 | 1 | 40 | 5/17/2025
$ | F | Frame Plate | A36 Mild Steel, 1/4" x 12" x 24" Hot Rolled Steel | 5 https://www.amazon.com/dp/B08JD7JN39?ref_=ppx_hzod_title_dt_b_fed_asin_title_0_1 22 | 1 | 5 | 110 | 5/17/2025
$ | E | EC | Ammeter INA219 I2C Interface Bidirectional DC Current/Power Monitoring Sensor Module 1 https://www.amazon.com/dp/B08R9MGSWV?psc=1&smid=A2Z10KY0342329&ref_=chk_typ_imgToDp 12.99 | 5 | 1 | 12.99 Not Used In Current Design 5/18/2025
$ | E | EC | E-Stop | 1 https://www.amazon.com/APIELE-Warranty-Momentary-Mushroom-Mouting/dp/B07PKQJZDY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 9.99 | 1 | 1 | 9.99 | 5/18/2025
$ | E | EC | Crimped Wire Connectors | 1 https://www.amazon.com/gp/product/B07V35375X/ref=ppx_yo_dt_b_asin_title_o02_s00?ie=UTF8&th=1 16.99 | 1 | 1 | 16.99 | 5/17/2025
$ | E | EC | WAGO Connectors | 1 https://www.amazon.com/gp/product/B0957T1S9C/ref=ppx_yo_dt_b_search_asin_title?ie=UTF8&psc=1 36.95 | 1 | 1 | 36.95 | 5/18/2025
$ | E | EC | Screw Terminal Block Connector Kit | 1 https://www.amazon.com/dp/B0D29QD1WB?ref=ppx_yo2ov_dt_b_fed_asin_title&th=1 13.99 | 1 | 1 | 13.99 | 5/17/2025
$ | E | EC | Screw Terminal Block Connector 8x | 1 https://www.amazon.com/dp/B0BLHGK43D?ref=ppx_yo2ov_dt_b_fed_asin_title&th=1 7.99 | 1 | 1 | 7.99 | 5/17/2025
$ | E | EC | Screw Terminal Block Connector 12x | 1 https://www.amazon.com/dp/B0BLHDTLLH?ref=ppx_yo2ov_dt_b_fed_asin_title&th=1 9.99 | 1 | 1 | 9.99 | 5/17/2025

$ | E | EC | PCB Male Header Pin Strip | 1 https://www.amazon.com/dp/B07PKKY8BX?ref=ppx_yo2ov_dt_b_fed_asin_title 4.99 | 1 | 1 | 4.99 | 5/17/2025
$ | EC | Standoff Kit | 1 https://www.amazon.com/dp/B0BP6P37QY?ref=ppx_yo2ov_dt_b_fed_asin_title 18.98 | 1 | 1 | 18.98 | 5/18/2025
$ | E | EC | Protoboards | 1 https://www.amazon.com/dp/B072Z7Y19F?ref=ppx_yo2ov_dt_b_fed_asin_title 9.99 | 1 | 1 | 9.99 | 5/17/2025
$ | EC | Self Tapping Mounting Screws | 1 https://www.amazon.com/dp/B07ZH9GJWP?ref=ppx_yo2ov_dt_b_fed_asin_title 9.29 | 1 | 1 | 9.29 | 5/18/2025
$ | E | EC | Arduino Nano | 1 https://www.amazon.com/dp/B0D5LYFRQP?ref=ppx_yo2ov_dt_b_fed_asin_title 15.99 | 1 | 1 | 15.99 | 5/17/2025
$ | E | EC | Motor Control | Reverse Rotation Preventer Diode for Motor | 4 https://www.amazon.com/dp/B079KCWPWQ?ref=ppx_yo2ov_dt_b_fed_asin_title&th=1 6.99 | 20 | 1 | 6.99 | 5/17/2025
$ | E | EC | Motor Control | 3.3V 8 Channel Relay | 1 https://www.amazon.com/gp/product/B0BQDMXC4R/ref=ppx_yo_dt_b_asin_title_o02_s00?ie=UTF8&th=1 18 | 1 | 1 | 18 For Motor Control and E-Stop5/18/2025
$ | E | EC | E Hardware | Step Down Buck Converter | 1 Amazon.com: Acxico 2 pcs 3.3V 5V 6V 9V 12V 24V Mini AC DC to DC Buck Step Down Adjustable Volt Converter : Electronics 8.99 | 1 | 1 | 8.99 | 5/18/2025
$ | E | EC | E Hardware | 24V-3.3V Step Down Buck Converter | 1 https://www.amazon.com/dp/B0D39RQD5G?ref=ppx_yo2ov_dt_b_fed_asin_title&th=1 15.59 | 1 | 1 | 15.59 possible to not be needed 5/17/2025
$ | E | EC | Fuse Block Recepticle | 1 https://www.amazon.com/dp/B079GG3MCN?ref=ppx_yo2ov_dt_b_fed_asin_title&th=1 12.99 | 1 | 1 | 12.99 | 5/17/2025
$ | E | EC | Automotive Fuse Assortment | 1 https://www.amazon.com/dp/B0B18NVT5Z?ref=ppx_yo2ov_dt_b_fed_asin_title 10.99 | 1 | 1 | 10.99 | 5/17/2025
$ | E | EC | ESP32 Breakout Board | 1 https://www.amazon.com/dp/B0BYS6THLF?ref=ppx_yo2ov_dt_b_fed_asin_title 11.99 | 1 | 1 | 11.99 | 5/17/2025
$ | E | EC | UI/Microcontroller | Raspberry Pi 4 Model B | 1 https://www.amazon.com/Raspberry-Model-2019-Quad-Bluetooth/dp/B07TC2BK1X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 70.5 | 1 | 1 | 70.5 | 5/18/2025
$ | E | EC | UI/Microcontroller | Raspberry Pi Heat Sink and Fan | 1 https://www.amazon.com/gp/product/B07PCMTZHF/ref=ppx_yo_dt_b_asin_title_o02_s00?ie=UTF8&psc=1 8.98 | 1 | 1 | 8.98 | 12/17/2024
$ | E | EC | UI/Microcontroller | Touch Screen Display | 1 https://www.amazon.com/OSOYOO-Capacitive-Display-Interface-Raspberry/dp/B0B8R1V19B 33.92 | 1 | 1 | 33.92 4.3 inch IPS LCD Capacitive Touch Screen, DSI Cable Included, 800×480 DSI 12/16/2024
$ | E | EC | UI/Microcontroller | ESP32 Dev Board | 1 https://www.amazon.com/gp/product/B08D5ZD528/ref=ppx_yo_dt_b_asin_title_o06_s03?ie=UTF8&th=1 15.99 | 3 | 1 | 15.99 | 12/17/2024
$ | E | EC | Electrical Mounting | Din Rail Mounts | NA | 0 | 1 | 0 | 0 https://www.printables.com/model/191154-din-rail-mount/files 5/17/2025
$ | E | EC | Electrical Mounting | DIN Rail Slotted Aluminum RoHS 8" Inches Long 35mm Wide 7.5mm High 1 https://www.amazon.com/gp/product/B07NVWD67L/ref=ppx_yo_dt_b_asin_title_o09_s00?ie=UTF8&psc=1 16.99 | 10 | 1 | 16.99 | 5/17/2025
$ | EC | Electrical Mounting | Self Tapping Mounting Screws for Din Rails | 1 https://www.amazon.com/dp/B0BKPTQFFC?ref=ppx_yo2ov_dt_b_fed_asin_title&th=1 5.99 | 1 | 1 | 5.99 | 5/18/2025
$ | E | EC | Electrical Mounting | Screw Terminal DIN Rail Mount | 1 https://www.amazon.com/gp/product/B07BF87FJ5/ref=ppx_yo_dt_b_asin_title_o05_s00?ie=UTF8&psc=1 22.99 | 1 | 1 | 22.99 | 12/17/2024
$ | E | EC | 22 AWG Solid Core Wire | 1 https://www.amazon.com/gp/product/B07TX6BX47/ref=ppx_yo_dt_b_search_asin_title?ie=UTF8&psc=1 15.19 | 1 | 1 | 15.19 | 12/17/2024
$ | E | EC | 22 AWG Stranded Wire | 1 https://www.amazon.com/gp/product/B09TK155BW/ref=ppx_yo_dt_b_asin_title_o05_s01?ie=UTF8&th=1 9.49 | 1 | 1 | 9.49 | 12/17/2024
$ | E | EC | Power Supply | AC Phase Power Cable | 1 https://www.amazon.com/C2G-03130-Universal-Power-Cord/dp/B0000510ZO 3.99 | 1 | 1 | 3.99 AC Power not needed for ISS, but powered by home grid need to make 24V DC 1/6/2025
$ | E | EC | Power Supply | AC Power switch with fuze and plug | 1 https://www.amazon.com/3Dman-Rocker-Switch-Socket-Module/dp/B07RRY5MYZ?th=1 7.99 | 1 | 1 | 7.99 | 1/6/2025
$ | E | EC | Power Supply | 5V, 12V, 24V DC Power Supply | 1 https://www.amazon.com/Arcity-Switching-Adjustable-Machine-Cocktail/dp/B07RT54H9V 23.99 | 1 | 1 | 23.99 | 1/6/2025
$ | C | 3D Printing Fillament (PLA) | 1 https://www.amazon.com/gp/product/B0BM739JRF/ref=ppx_yo_dt_b_asin_title_o05_s00?ie=UTF8&psc=1 13.99 | 1 | 1 | 13.99 | 5/18/2025
$ | C | Solder | 1 | 0 | 1 | 1 | 0 | 5/18/2025
