tommyrohmann/Microgravity-Press-Washing-Machine/Parts List.xlsx

Pressure Gauge | 2 | https://www.amazon.com/CARBO-Instruments-Pressure-Stainless-Connection/dp/B08QDSHXKY/132-0596219-1913055
Pressure Relief Valve
Water Pump |  | https://www.amazon.com/dp/B01KKN0SGM?ref=ppx_yo2ov_dt_b_fed_asin_title
Vacuum Pump
Detergent Pump
Power Supply 12V 10A | 1 | https://www.amazon.com/dp/B0DNXQ1LHN?ref=ppx_yo2ov_dt_b_fed_asin_title&th=1
E-Stop | 1
Raspberry Pi
esp32
Screen
Moisture Sensor
