tommyrohmann/Microgravity-Press-Washing-Machine/CAD Design Work/3D Print Files/IdlerSprocketSpacer.stl

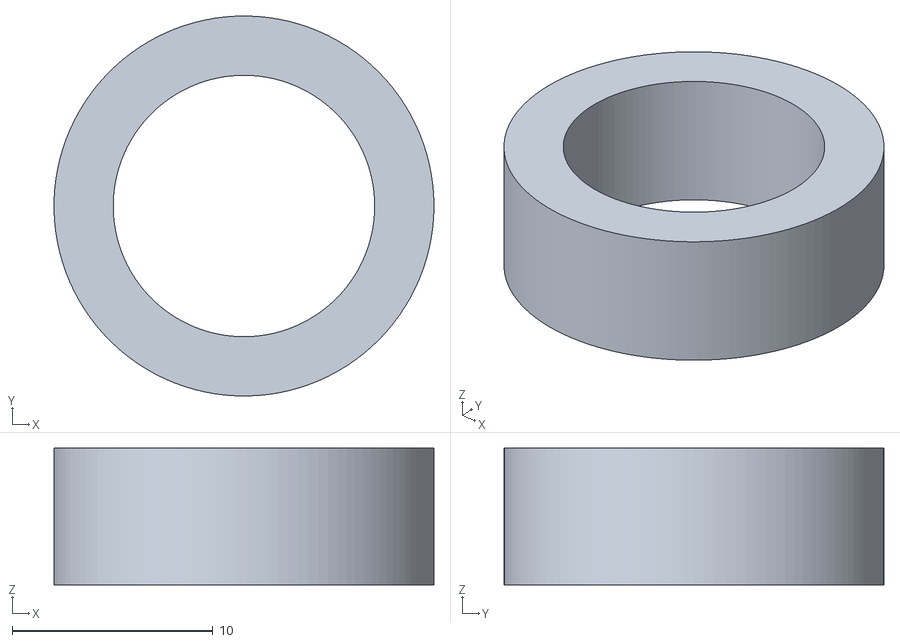
[picture p25: CAD file, 2025-04-04]
CAD Design Work/3D Print Files/IdlerSprocketSpacer.stl
18.9 x 18.9 x 6.81
