tommyrohmann/Microgravity-Press-Washing-Machine/CAD Design Work/FEM Test Objects/SUBLoadCellBase-Body007.step

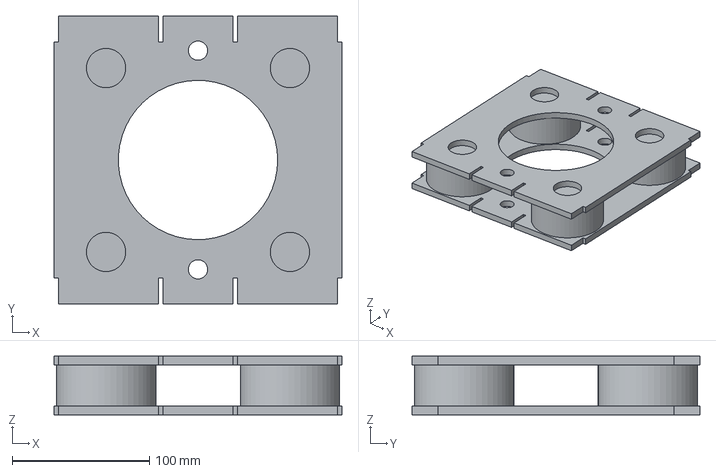
[picture p26: CAD file, 2026-04-21]
CAD Design Work/FEM Test Objects/SUBLoadCellBase-Body007.step
209.6 x 209.5 x 42.9 mm
