tommyrohmann/Microgravity-Press-Washing-Machine/CAD Design Work/Imports/Ball Valve Conversion/BallValveAdapterFixed.FCStd

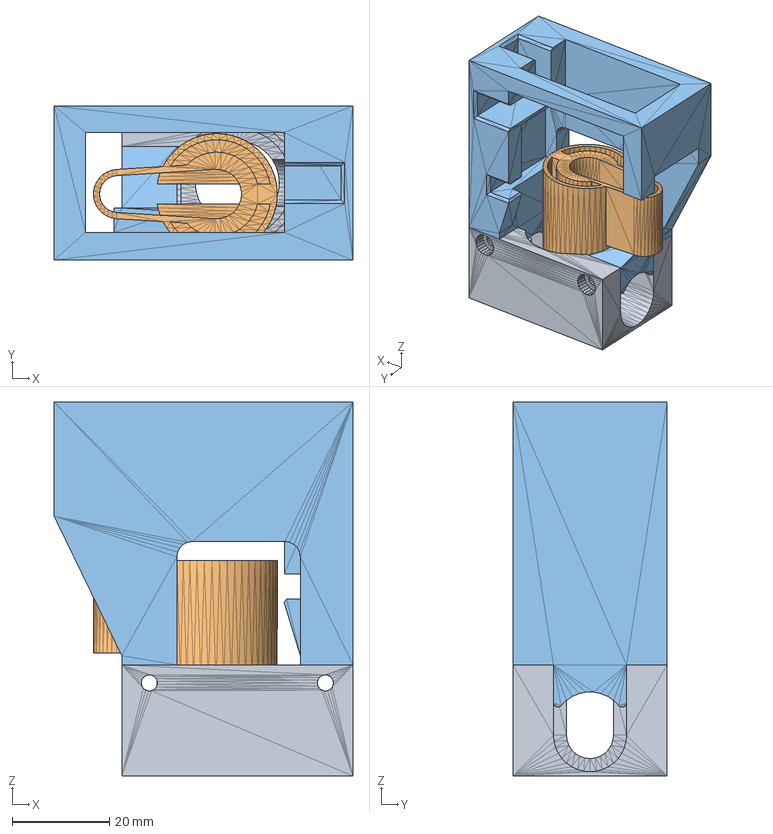
[picture p27: CAD file, 2025-05-27]
CAD Design Work/Imports/Ball Valve Conversion/BallValveAdapterFixed.FCStd
61.5 x 31.7 x 77.0 mm
Bottom
Adapter
Top
