tommyrohmann/Microgravity-Press-Washing-Machine/CAD Design Work/SUBLoadCellBase.FCStd

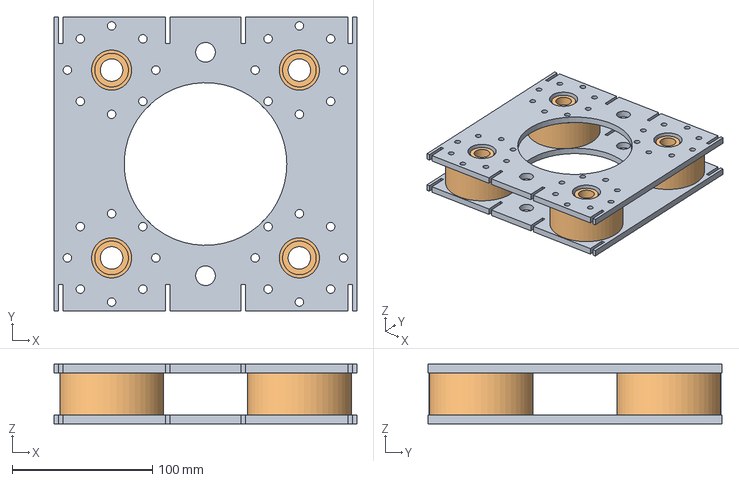
[picture p28: CAD file, 2026-04-21]
CAD Design Work/SUBLoadCellBase.FCStd
215.9 x 209.6 x 42.7 mm
LoadCell x 4
