tommyrohmann/Microgravity-Press-Washing-Machine/CAD/Temp/3 Way vv actuator.step

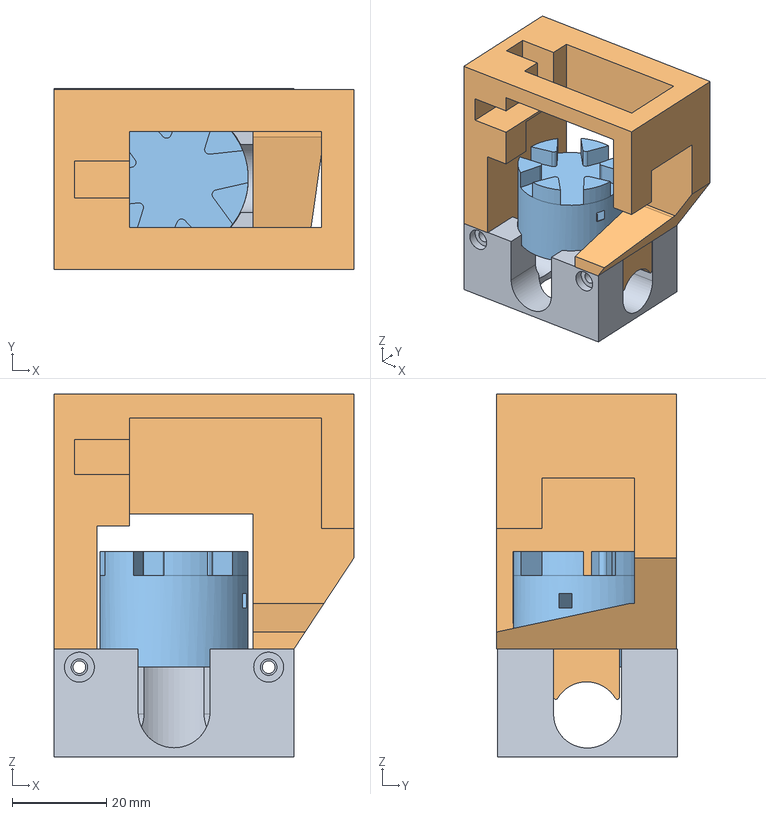
[picture p29: CAD file, 2026-09-12]
CAD/Temp/3 Way vv actuator.step
63.5 x 38.3 x 77.0 mm
Valve Mount
Servo Mount
Adapter
