tommyrohmann/Microgravity-Press-Washing-Machine/Sub-System Design and Documentation/3 Wash Chamber Assembly/Wash Chamber Conduit/Washing Chamber Conduit Manufacture Files/KK_Wash Chamber End Bottom Cast Mold.3mf

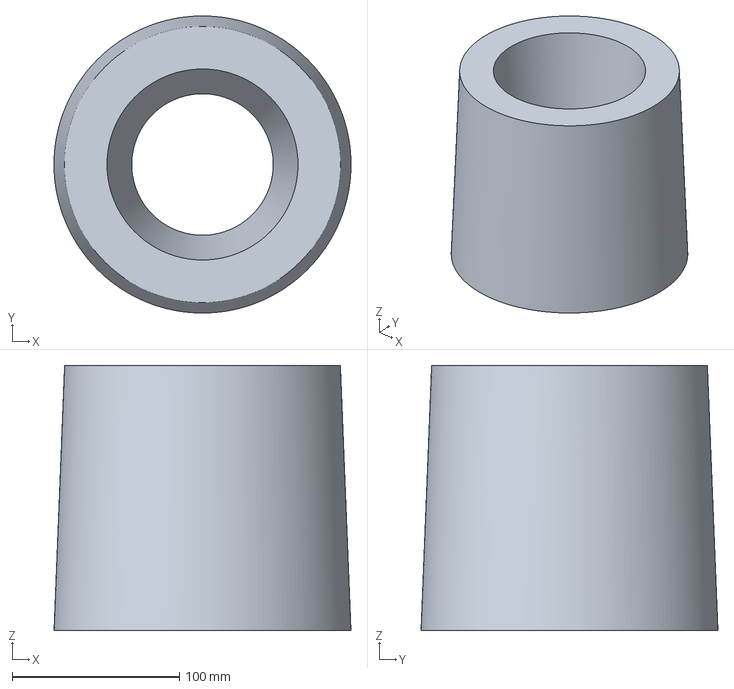
[picture p30: CAD file, 2023-09-06]
Sub-System Design and Documentation/3 Wash Chamber Assembly/Wash Chamber Conduit/Washing Chamber Conduit Manufacture Files/KK_Wash Chamber End Bottom Cast Mold.3mf
177.8 x 177.8 x 158.7 mm
