tommyrohmann/Microgravity-Press-Washing-Machine/System Design and Documentation/CAD Design Work/Washing Machine CAD.FCStd

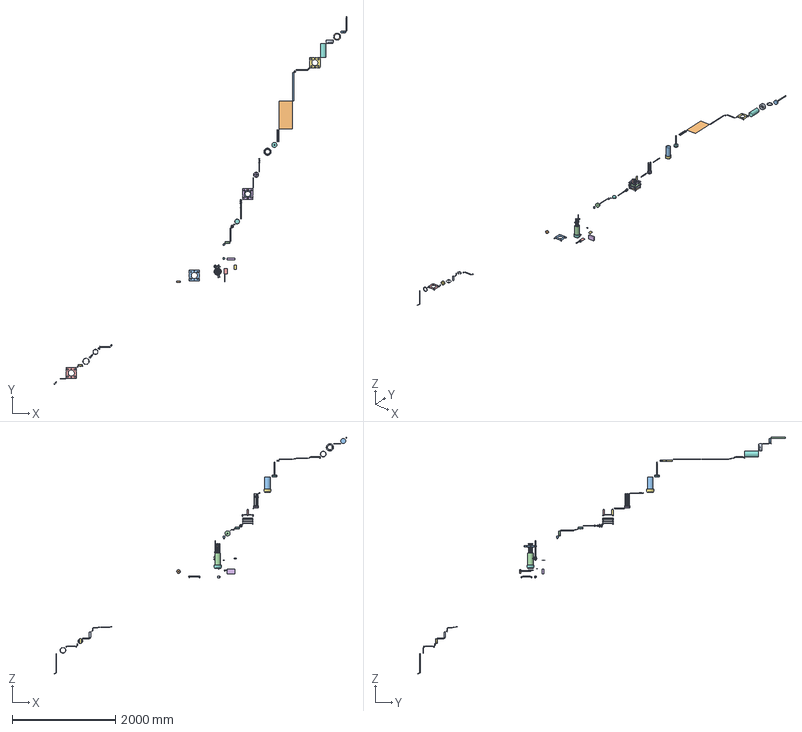
[picture p31: CAD file, 2025-04-14]
System Design and Documentation/CAD Design Work/Washing Machine CAD.FCStd
5665.0 x 7115.5 x 4574.6 mm
ACMEHexNut
ACMEScrew
CastleSpacer
ChainBase
Compression Spring
ConduitHatch
ConduitStaticSeal
DriveMotor
DriveSprocket
DriveTrainBaseSpacer
DynamicPistonSeal
DynamicPistonSeal001
DynamicRodSeal
DynamicRodSeal001
FrameBottomBeam
HalfInchFlangedJournalBearing
LoadCell
LoadCellBase
WashChamber
ConduitStaticSeal001
ConduitStaticSeal002
CastleSpacer001
WashChamberConduit
ServoSimplified
ReserviorPiston
DynamicPistonSeal003
DynamicPistonSeal004
DynamicRodSeal003
DynamicRodSeal004
DynamicPistonSeal006
DynamicPistonSeal007
DynamicRodSeal006
DynamicRodSeal007
Compression Spring001
ReserviorPistonRod
ShaftCollarReserviorPistonRod
ShaftCollarReserviorPistonRod001
Compression Spring002
ReserviorPistonRod001
ShaftCollarReserviorPistonRod002
ShaftCollarReserviorPistonRod003
Compression Spring003
ReserviorPistonRod002
ShaftCollarReserviorPistonRod004
ShaftCollarReserviorPistonRod005
Compression Spring004
ReserviorPistonRod003
ShaftCollarReserviorPistonRod006
ShaftCollarReserviorPistonRod007
5779K109_Push-to-Connect Tube Fitting for Air
5779K109_Push-to-Connect Tube Fitting for Air 001
5779K109_Push-to-Connect Tube Fitting for Air 002
5779K109_Push-to-Connect Tube Fitting for Air 003
5779K109_Push-to-Connect Tube Fitting for Air 004
FrameBottomBeam001
FrameBottomBeam002
WashPiston
DynamicPistonSeal009
DynamicPistonSeal010
DynamicPistonSeal012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
