tommyrohmann/Microgravity-Press-Washing-Machine/CAD Design Work/FEM Test Objects/SUBLoadCellBase-Load Cell Base.step

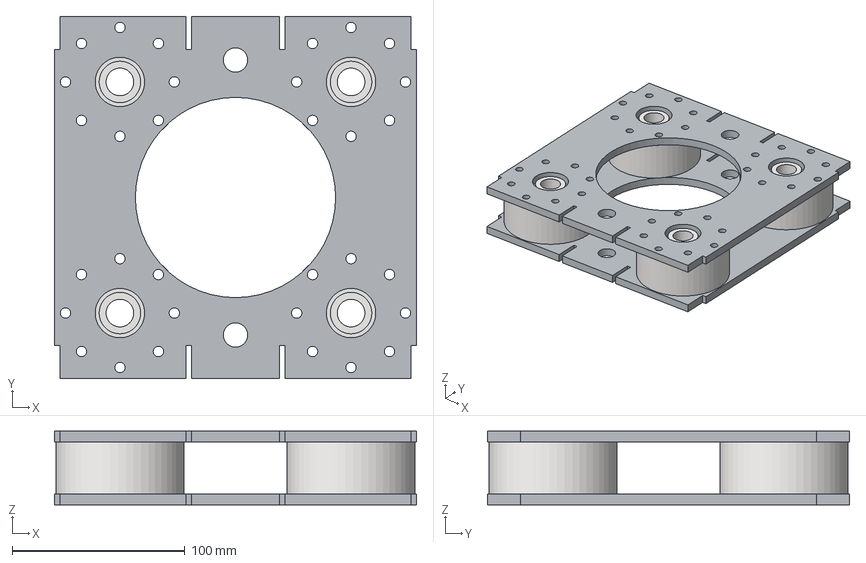
[picture p32: CAD file, 2026-04-21]
CAD Design Work/FEM Test Objects/SUBLoadCellBase-Load Cell Base.step
209.5 x 209.6 x 42.7 mm
LoadCell x 4
