tommyrohmann/Microgravity-Press-Washing-Machine/CAD Design Work/Imports/Ball Valve Conversion/Ball Valve Actuator.step

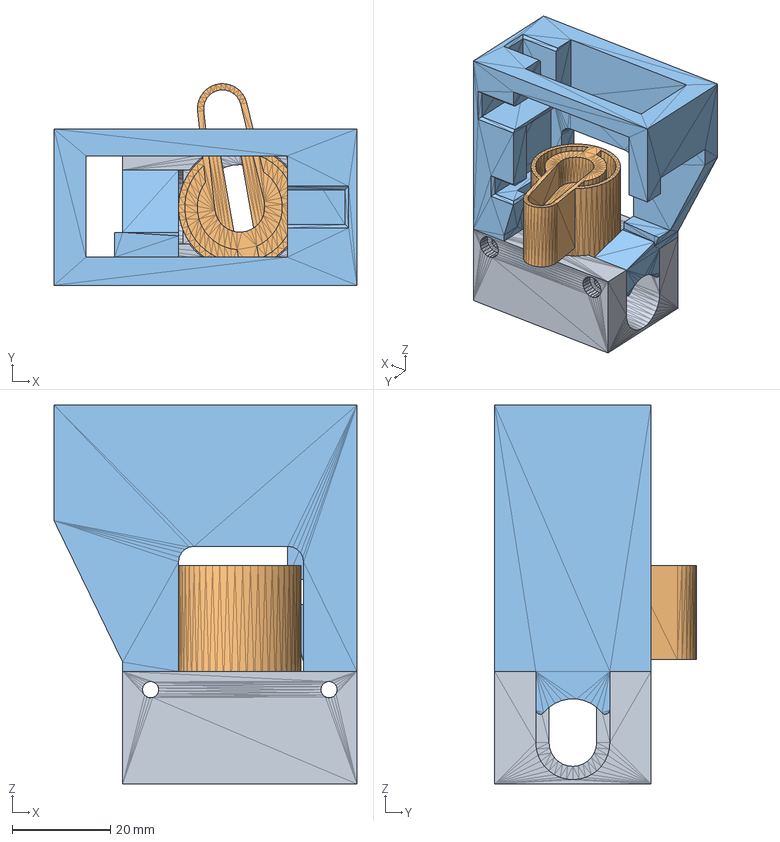
[picture p33: CAD file, 2025-05-27]
CAD Design Work/Imports/Ball Valve Conversion/Ball Valve Actuator.step
61.5 x 41.0 x 77.0 mm
Scale
Scale001
Scale002
