tommyrohmann/Microgravity-Press-Washing-Machine/CAD Design Work/SUBPowerShaft.FCStd

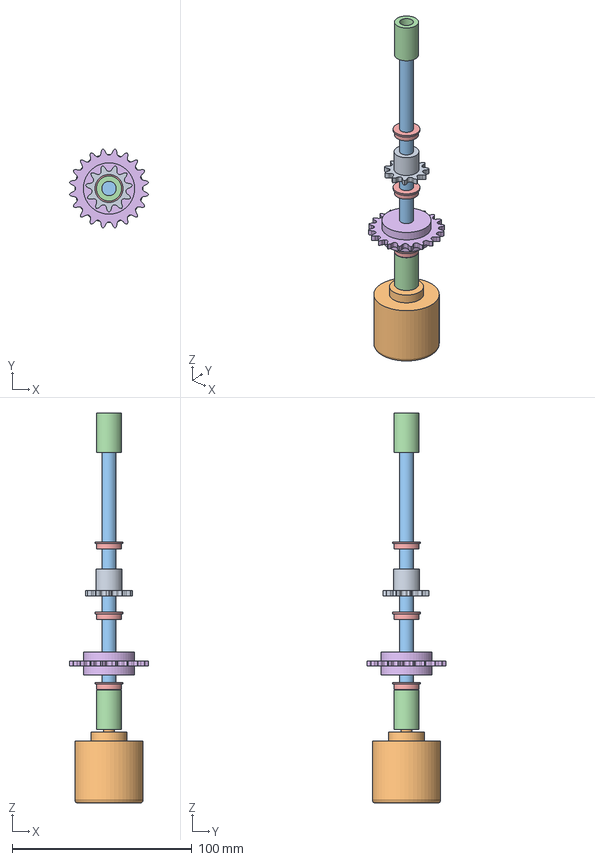
[picture p34: CAD file, 2026-04-21]
CAD Design Work/SUBPowerShaft.FCStd
44.1 x 44.1 x 217.2 mm
Encoder1
