tommyrohmann/Microgravity-Press-Washing-Machine/CAD/Temp/APlaceHolders-Din Rail Mount Base Part.step

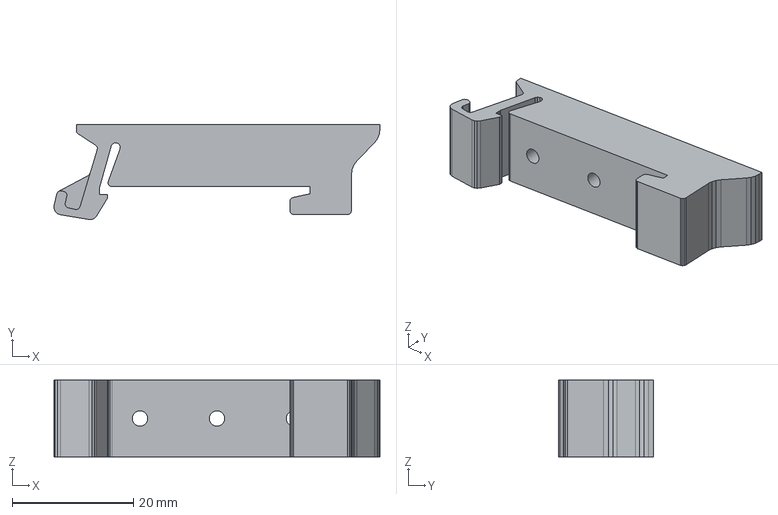
[picture p35: CAD file, 2026-09-12]
CAD/Temp/APlaceHolders-Din Rail Mount Base Part.step
53.8 x 15.7 x 12.7 mm
