tommyrohmann/Microgravity-Press-Washing-Machine/CAD/Wash Piston.FCStd

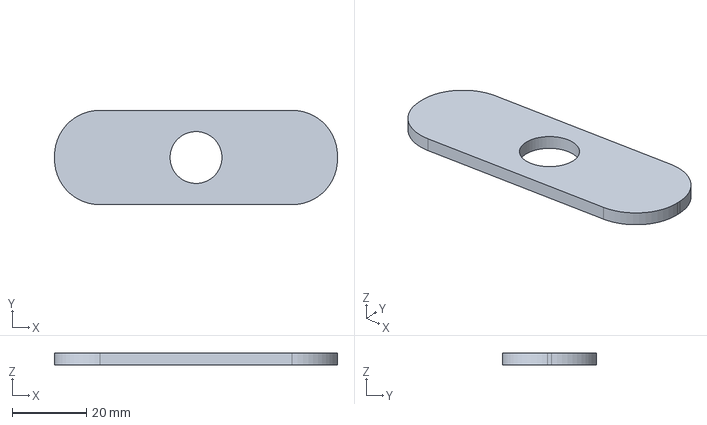
[picture p36: CAD file, 2026-09-12]
CAD/Wash Piston.FCStd
76.2 x 25.4 x 3.17 mm
