tommyrohmann/Microgravity-Press-Washing-Machine/Sub-System Design and Documentation/Piping Systems/Actuated Ball Valves/Servo Actuated Ball Valve Shell Mount.stl

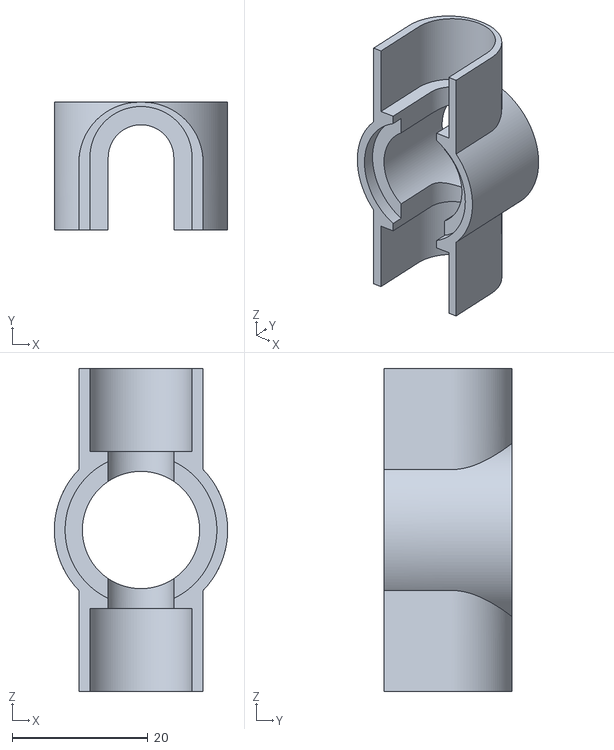
[picture p37: CAD file, 2023-02-27]
Sub-System Design and Documentation/Piping Systems/Actuated Ball Valves/Servo Actuated Ball Valve Shell Mount.stl
25.5 x 18.8 x 47.6
