tommyrohmann/Microgravity-Press-Washing-Machine/CAD Design Work/FEM Test Objects/FEM Study.FCStd

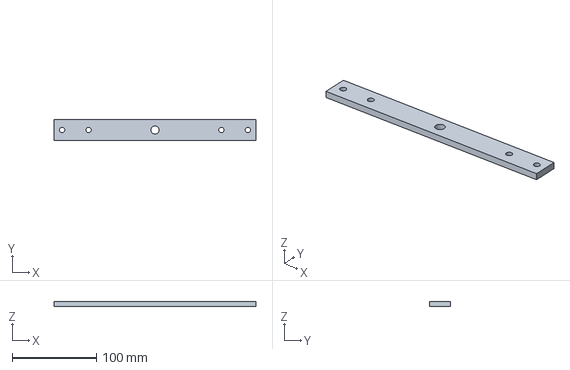
[picture p38: CAD file, 2026-02-04]
CAD Design Work/FEM Test Objects/FEM Study.FCStd
240.0 x 25.4 x 6.35 mm
