tommyrohmann/Microgravity-Press-Washing-Machine/CAD/Frame.FCStd

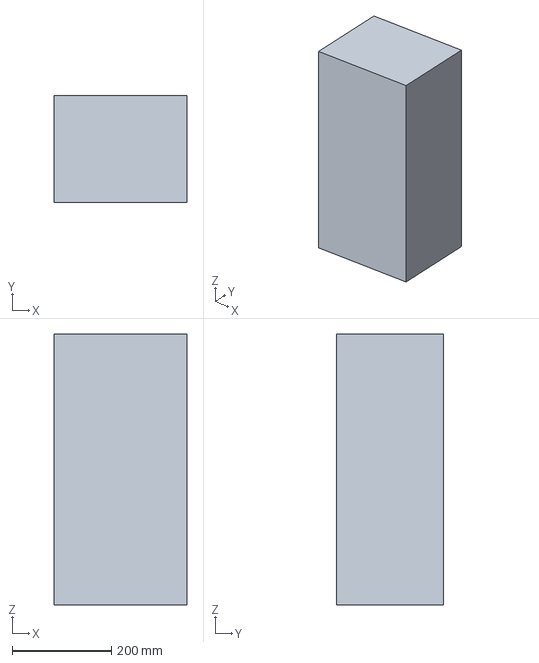
[picture p39: CAD file, 2026-09-12]
CAD/Frame.FCStd
266.7 x 215.9 x 544.8 mm
