tommyrohmann/Microgravity-Press-Washing-Machine/Sub-System Design and Documentation/Piping Systems/Actuated Ball Valves/Load Cell Test Mount to Find Required Torque Application.stl

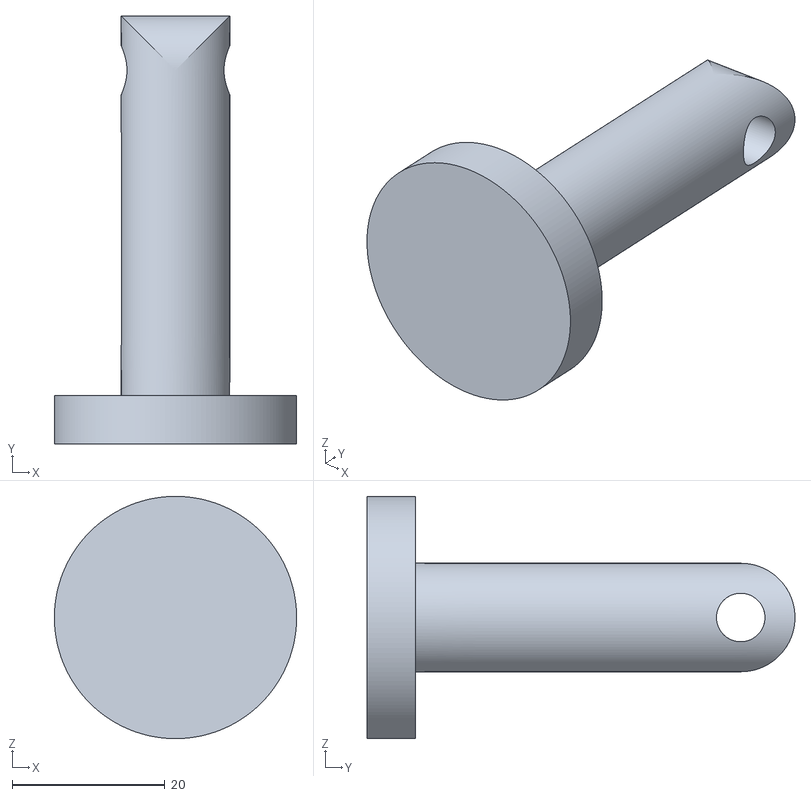
[picture p40: CAD file, 2023-02-20]
Sub-System Design and Documentation/Piping Systems/Actuated Ball Valves/Load Cell Test Mount to Find Required Torque Application.stl
31.8 x 56.1 x 31.8
