tommyrohmann/Microgravity-Press-Washing-Machine/CAD/SUBWashChamber.FCStd

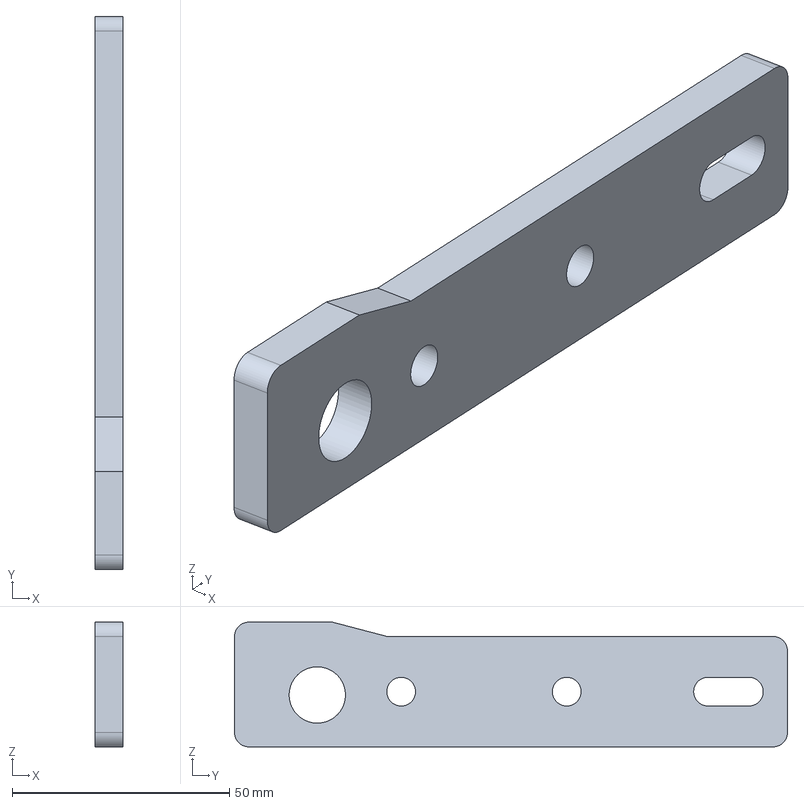
[picture p41: CAD file, 2026-09-12]
CAD/SUBWashChamber.FCStd
6.35 x 127.3 x 28.7 mm
