tommyrohmann/Microgravity-Press-Washing-Machine/Sub-System Design and Documentation/Piping Systems/Actuated Ball Valves/Torque Test Valve Lever.stl

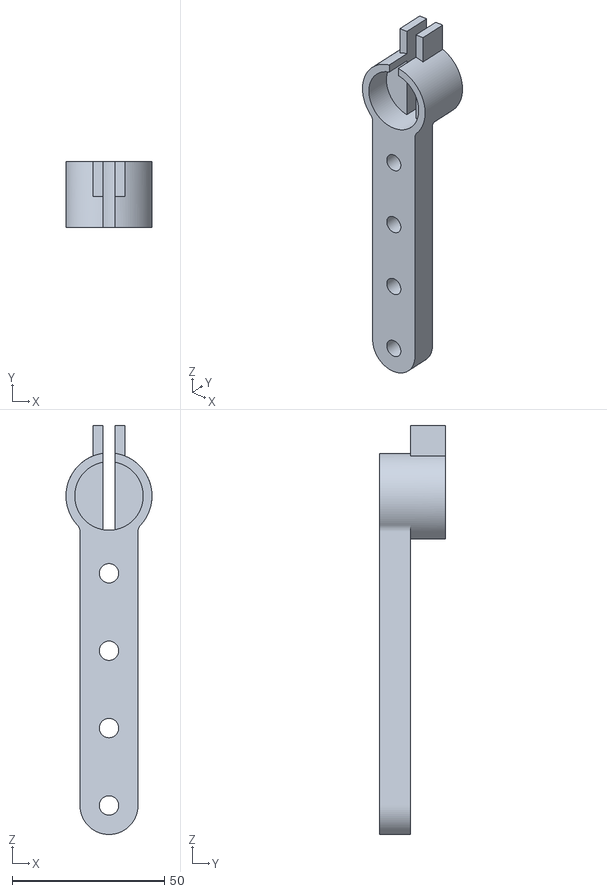
[picture p42: CAD file, 2023-02-20]
Sub-System Design and Documentation/Piping Systems/Actuated Ball Valves/Torque Test Valve Lever.stl
28.2 x 21.6 x 134.2
