tommyrohmann/Microgravity-Press-Washing-Machine/CAD/Lid.FCStd

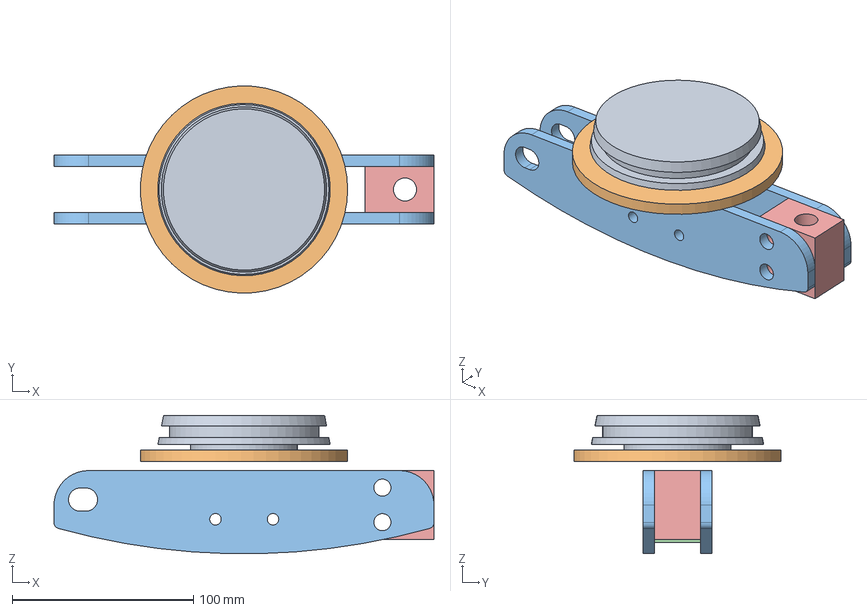
[picture p43: CAD file, 2026-09-12]
CAD/Lid.FCStd
209.6 x 114.2 x 76.2 mm
Plug
Backing
Hatch Beams x 2
Plug Holder
Hand Wheel Holder
