tommyrohmann/Microgravity-Press-Washing-Machine/Sub-System Design and Documentation/Piping Systems/Actuated Ball Valves/Servo Actuated Ball Valve Shell Torque Test Mount.stl

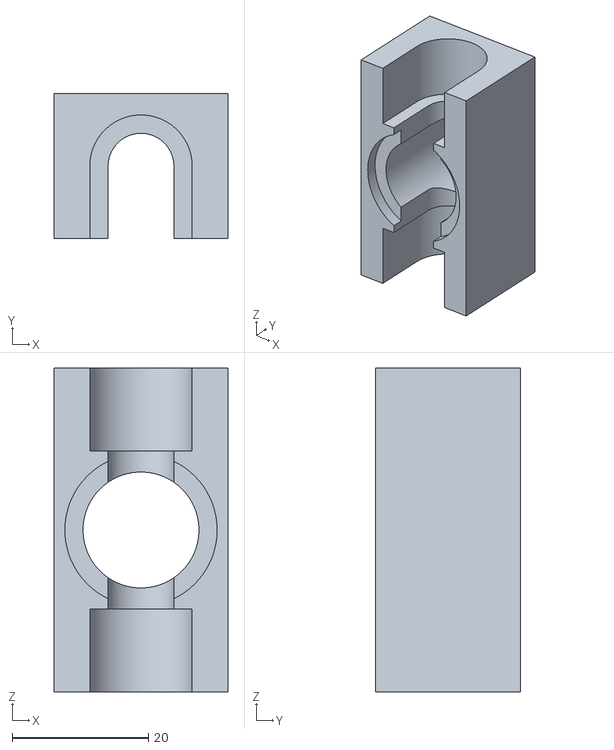
[picture p44: CAD file, 2023-02-20]
Sub-System Design and Documentation/Piping Systems/Actuated Ball Valves/Servo Actuated Ball Valve Shell Torque Test Mount.stl
25.5 x 21.3 x 47.6
