tommyrohmann/Microgravity-Press-Washing-Machine/CAD Design Work/FEM Test Objects/SUBLoadCellBase-Body004.step

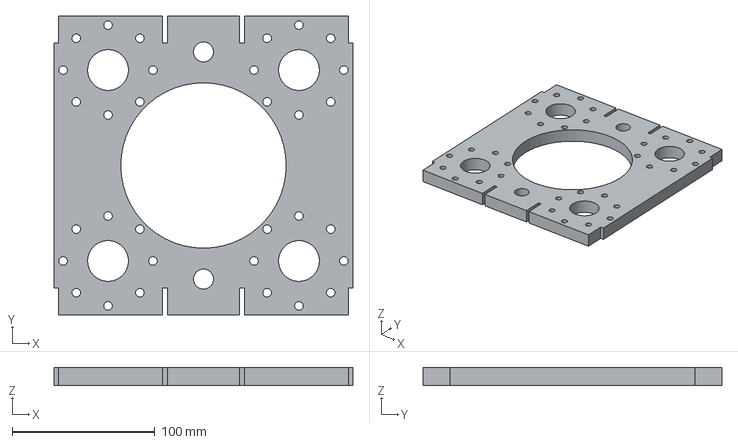
[picture p45: CAD file, 2026-02-04]
CAD Design Work/FEM Test Objects/SUBLoadCellBase-Body004.step
209.5 x 209.5 x 12.7 mm
