tommyrohmann/Microgravity-Press-Washing-Machine/CAD Design Work/Test.FCStd

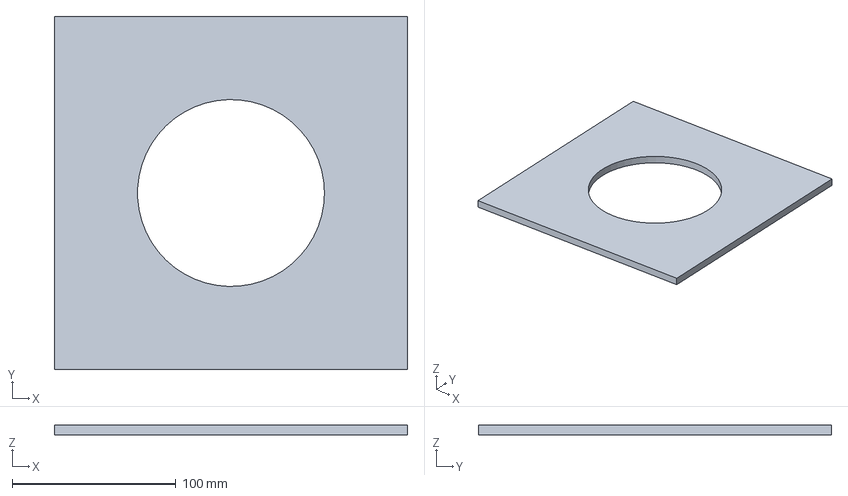
[picture p46: CAD file, 2026-02-04]
CAD Design Work/Test.FCStd
215.9 x 215.9 x 6.35 mm
