tommyrohmann/Microgravity-Press-Washing-Machine/CAD/SUB Access Hatch.FCStd

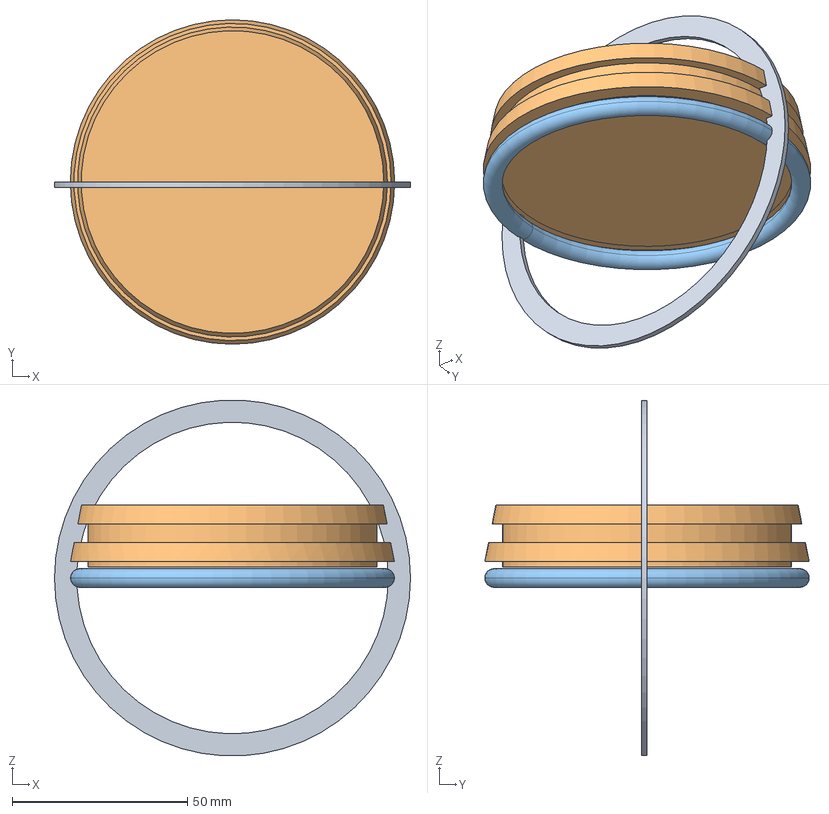
[picture p47: CAD file, 2026-09-12]
CAD/SUB Access Hatch.FCStd
101.6 x 92.6 x 101.4 mm
9452K99_Oil-Resistant Buna-N O-Ring
