tommyrohmann/Microgravity-Press-Washing-Machine/CAD Design Work/SUBChainTensioner.FCStd

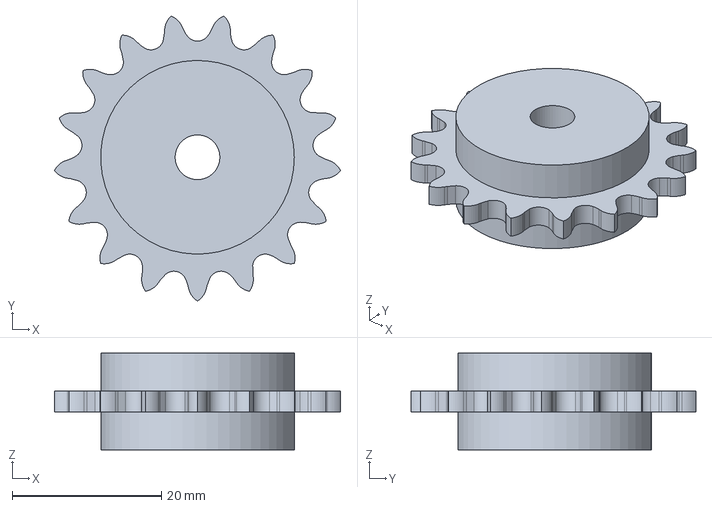
[picture p48: CAD file, 2026-01-04]
CAD Design Work/SUBChainTensioner.FCStd
38.4 x 38.2 x 13.0 mm
