tommyrohmann/Microgravity-Press-Washing-Machine/CAD/Interface Components.FCStd

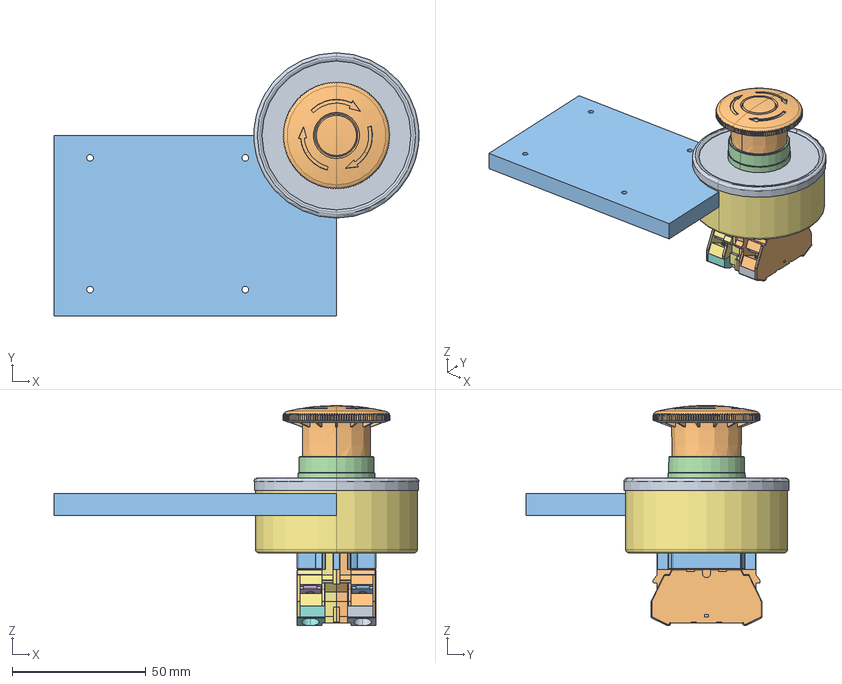
[picture p50: CAD file, 2026-09-12]
CAD/Interface Components.FCStd
136.3 x 98.4 x 82.2 mm
9804T633_Dual Scale Pressure Gauge with ABS Plastic Case
9804T633_Dual Scale Pressure Gauge with ABS Plastic Case001
9804T633_Dual Scale Pressure Gauge with ABS Plastic Case002
9804T633_Dual Scale Pressure Gauge with ABS Plastic Case003
9804T633_Dual Scale Pressure Gauge with ABS Plastic Case004
9804T633_Dual Scale Pressure Gauge with ABS Plastic Case005
9804T633_Dual Scale Pressure Gauge with ABS Plastic Case006
9804T633_Dual Scale Pressure Gauge with ABS Plastic Case007
9804T633_Dual Scale Pressure Gauge with ABS Plastic Case008
7480T122_22 mm Emergency Stop Panel-Mount Switch
7480T122_22 mm Emergency Stop Panel-Mount Switch001
7480T122_22 mm Emergency Stop Panel-Mount Switch002
7480T122_22 mm Emergency Stop Panel-Mount Switch003
7480T122_22 mm Emergency Stop Panel-Mount Switch004
7480T122_22 mm Emergency Stop Panel-Mount Switch005
7480T122_22 mm Emergency Stop Panel-Mount Switch006
7480T122_22 mm Emergency Stop Panel-Mount Switch007
7480T122_22 mm Emergency Stop Panel-Mount Switch008
7480T122_22 mm Emergency Stop Panel-Mount Switch009
7480T122_22 mm Emergency Stop Panel-Mount Switch010
7480T122_22 mm Emergency Stop Panel-Mount Switch011
7480T122_22 mm Emergency Stop Panel-Mount Switch012
7480T122_22 mm Emergency Stop Panel-Mount Switch013
7480T122_22 mm Emergency Stop Panel-Mount Switch014
7480T122_22 mm Emergency Stop Panel-Mount Switch015
7480T122_22 mm Emergency Stop Panel-Mount Switch016
