tommyrohmann/Microgravity-Press-Washing-Machine/CAD Design Work/AuxiliaryElectronicComponents.FCStd

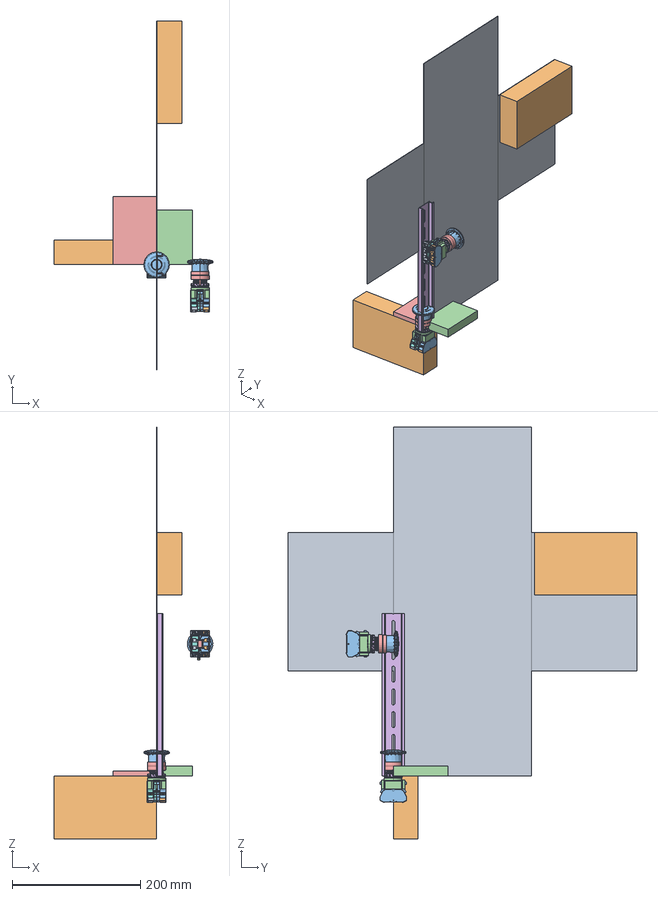
[picture p51: CAD file, 2025-07-30]
CAD Design Work/AuxiliaryElectronicComponents.FCStd
247.9 x 544.8 x 642.9 mm
PowerSupplyFootprint x 2
7480T122_22 mm Emergency Stop Panel-Mount Switch x 2
7480T122_22 mm Emergency Stop Panel-Mount Switch001 x 2
7480T122_22 mm Emergency Stop Panel-Mount Switch002 x 2
7480T122_22 mm Emergency Stop Panel-Mount Switch003 x 2
7480T122_22 mm Emergency Stop Panel-Mount Switch004 x 2
7480T122_22 mm Emergency Stop Panel-Mount Switch005 x 2
7480T122_22 mm Emergency Stop Panel-Mount Switch006 x 2
7480T122_22 mm Emergency Stop Panel-Mount Switch007 x 2
7480T122_22 mm Emergency Stop Panel-Mount Switch008 x 2
7480T122_22 mm Emergency Stop Panel-Mount Switch009 x 2
7480T122_22 mm Emergency Stop Panel-Mount Switch010 x 2
7480T122_22 mm Emergency Stop Panel-Mount Switch011 x 2
7480T122_22 mm Emergency Stop Panel-Mount Switch012 x 2
7480T122_22 mm Emergency Stop Panel-Mount Switch013 x 2
7480T122_22 mm Emergency Stop Panel-Mount Switch014 x 2
7480T122_22 mm Emergency Stop Panel-Mount Switch015 x 2
7480T122_22 mm Emergency Stop Panel-Mount Switch016 x 2
RaspberryPiFootprint
LCDScreenFootprint
