tommyrohmann/Microgravity-Press-Washing-Machine/CAD/Reservoir Piston.FCStd

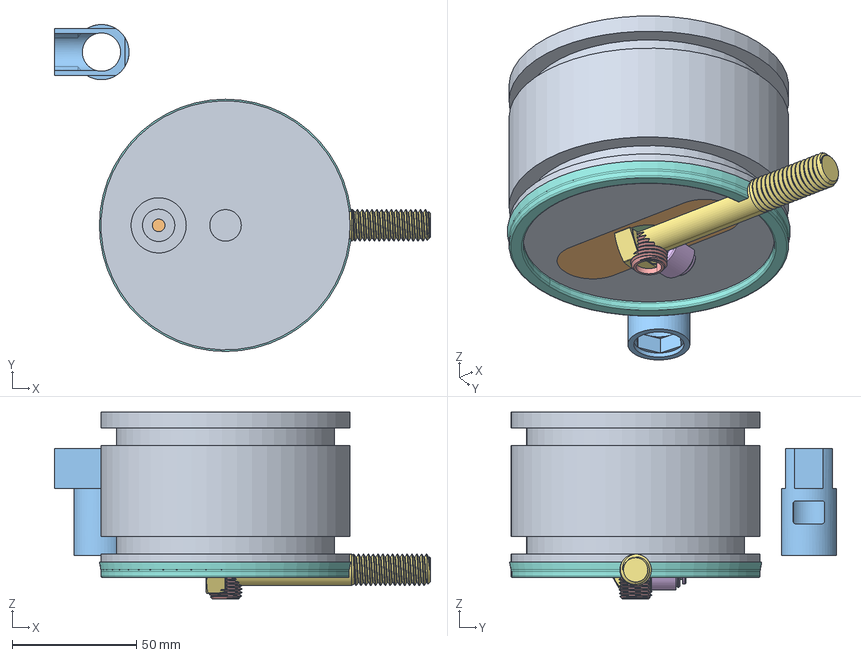
[picture p52: CAD file, 2026-09-12]
CAD/Reservoir Piston.FCStd
151.4 x 131.7 x 75.2 mm
ReservoirPistonHead
ServiceHandle
ThruConnectSupport
Service Handle Retainer Clip
NPTtoPushConnect
ElbowPushConnect
3inHexBolt1/2in
9505K121_O-Ring-Loaded U-Cup Seal
9505K121_O-Ring-Loaded U-Cup Seal001
