tommyrohmann/Microgravity-Press-Washing-Machine/CAD Design Work/SUBTensionerShaft.FCStd

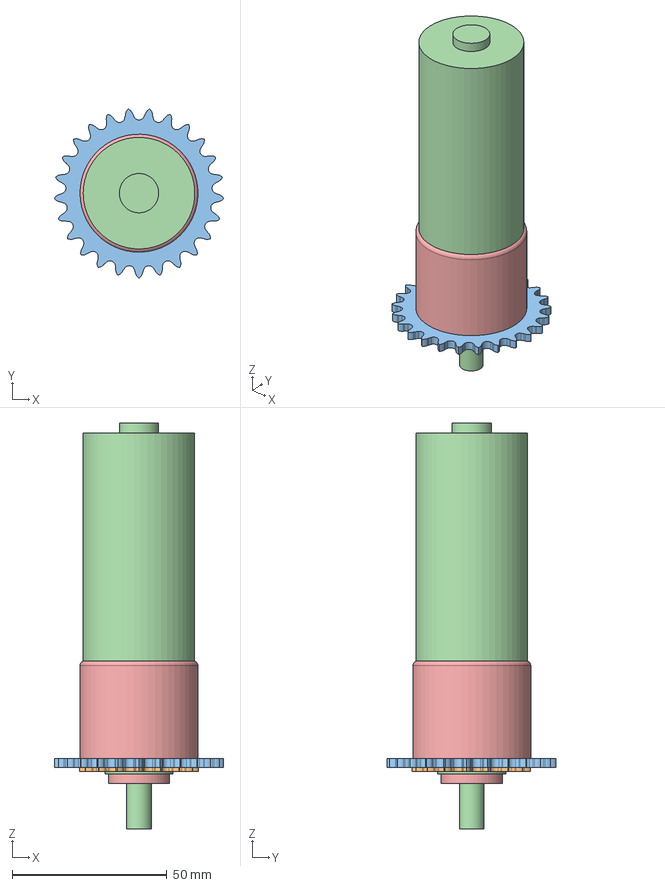
[picture p53: CAD file, 2025-06-06]
CAD Design Work/SUBTensionerShaft.FCStd
54.7 x 54.6 x 131.1 mm
DriveMotor1
Encoder1
