tommyrohmann/Microgravity-Press-Washing-Machine/CAD Design Work/PipeFittings.FCStd

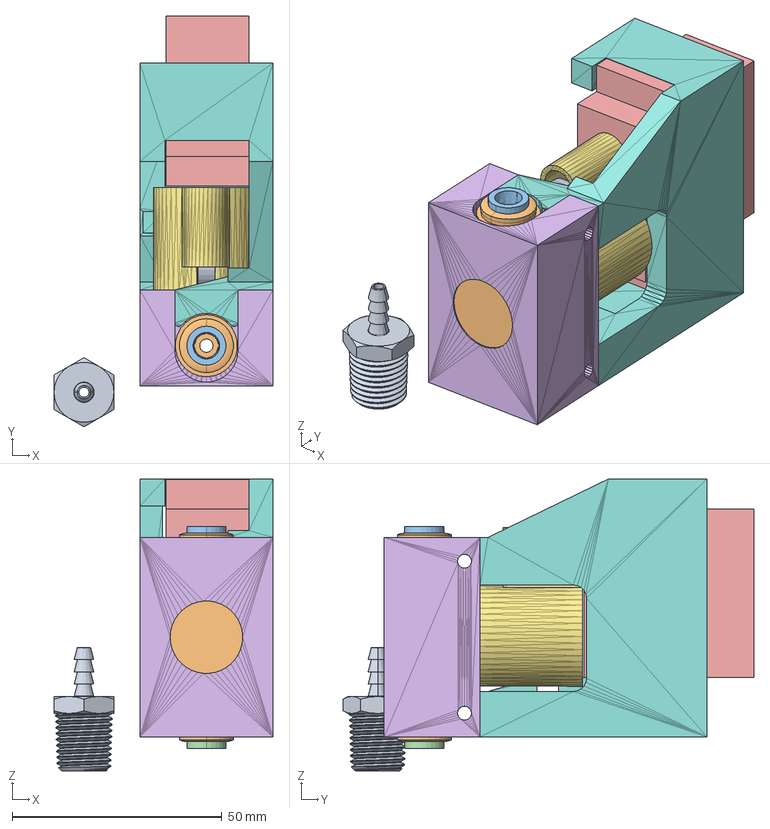
[picture p54: CAD file, 2025-06-03]
CAD Design Work/PipeFittings.FCStd
52.2 x 97.9 x 69.6 mm
4503K23_Polypropylene On Off Valve for Drinking Water
4503K23_Polypropylene On Off Valve for Drinking Water001
4503K23_Polypropylene On Off Valve for Drinking Water002
4503K23_Polypropylene On Off Valve for Drinking Water003
ServoSimplified
Bottom
Adapter
Top
5346K62_Brass Barbed Hose Fitting for Air and Water
