tommyrohmann/Microgravity-Press-Washing-Machine/(list of files, cad)

Other CAD files:
CAD/Main Assembly.FCStd
System Design and Documentation/CAD Design Work/DriveAssembly.FCStd
CAD Design Work/SUBWashChamberLatchAssembly.FCStd
CAD Design Work/Imports/Ball Valve Conversion/PipeFittings.step
CAD Design Work/SUB Top Plate.FCStd
CAD Design Work/FEM Test Objects/FEM Wash Arm.step
CAD Design Work/Imports/OLDEXPORT.FCStd
CAD Design Work/Load Cell Plate FEA.FCStd
CAD Design Work/FEM Test Objects/a.FCStd
CAD Design Work/SUBMachineTopPlate.FCStd
CAD Design Work/MASTER.FCStd
CAD/PipeFittings.FCStd
CAD Design Work/DRAWINGS.FCStd
CAD Design Work/Imports/3861N14_Absolute Pressure Transmitter.STEP
CAD Design Work/Imports/4503K23_Polypropylene On Off Valve for Drinking Water.STEP
CAD Design Work/Imports/5346K62_Brass Barbed Hose Fitting for Air and Water.STEP
CAD Design Work/Imports/Imported and Processed/1095K41_Zinc-Plated Steel Grease Fitting.STEP
CAD Design Work/Imports/Imported and Processed/8961K17_Aluminum DIN 3 Rail.STEP
CAD Design Work/Imports/Imported and Processed/92605A110_Stainless Steel Flat-Tip Set Screw.STEP
CAD Design Work/Imports/Imported and Processed/94815A107_Carbon Steel Acme Hex Nut.STEP
CAD Design Work/Imports/Imported and Processed/9657K96_Compression Spring.STEP
CAD/Temp/3 Way vv actuator.FCStd
Chain Drive - OLD/CAD Design Work/APlaceHolders.FCStd
Chain Drive - OLD/CAD Design Work/DRAWINGS.FCStd
Chain Drive - OLD/CAD Design Work/FEM Test Objects/FEM Wash Arm.step
Chain Drive - OLD/CAD Design Work/FEM Test Objects/a.FCStd
Chain Drive - OLD/CAD Design Work/Imports/3861N14_Absolute Pressure Transmitter.STEP
Chain Drive - OLD/CAD Design Work/Imports/4503K23_Polypropylene On Off Valve for Drinking Water.STEP
Chain Drive - OLD/CAD Design Work/Imports/5346K62_Brass Barbed Hose Fitting for Air and Water.STEP
Chain Drive - OLD/CAD Design Work/Imports/7480T122_22 mm Emergency Stop Panel-Mount Switch.STEP
Chain Drive - OLD/CAD Design Work/Imports/Ball Valve Conversion/PipeFittings.step
Chain Drive - OLD/CAD Design Work/Imports/Imported and Processed/1095K41_Zinc-Plated Steel Grease Fitting.STEP
Chain Drive - OLD/CAD Design Work/Imports/Imported and Processed/8961K17_Aluminum DIN 3 Rail.STEP
Chain Drive - OLD/CAD Design Work/Imports/Imported and Processed/92605A110_Stainless Steel Flat-Tip Set Screw.STEP
Chain Drive - OLD/CAD Design Work/Imports/Imported and Processed/94815A107_Carbon Steel Acme Hex Nut.STEP
Chain Drive - OLD/CAD Design Work/Imports/Imported and Processed/9657K96_Compression Spring.STEP
Chain Drive - OLD/CAD Design Work/Imports/Imported and Processed/98935A823_Carbon Steel Acme Lead Screw.STEP
Chain Drive - OLD/CAD Design Work/Imports/OLDEXPORT.FCStd
Chain Drive - OLD/CAD Design Work/Load Cell Plate FEA.FCStd
Chain Drive - OLD/CAD Design Work/MAIN ASSEMBLY.FCStd
Chain Drive - OLD/CAD Design Work/MASTER.FCStd
Chain Drive - OLD/CAD Design Work/Old/DriveComponentsSave.FCStd
Chain Drive - OLD/CAD Design Work/Old/FreeCADTake1/DriveAssembly.FCStd
Chain Drive - OLD/CAD Design Work/Old/Inventor Design Project/8mmFlangedJournalBearing.ipt
Chain Drive - OLD/CAD Design Work/Old/Inventor Design Project/ACMEHexNut.ipt
Chain Drive - OLD/CAD Design Work/Old/Inventor Design Project/ACMEScrew.ipt
Chain Drive - OLD/CAD Design Work/Old/Inventor Design Project/ACMEThrustNut.ipt
Chain Drive - OLD/CAD Design Work/Old/Inventor Design Project/Actuated Ball Valves/BallValveMount.ipt
Chain Drive - OLD/CAD Design Work/Old/Inventor Design Project/Actuated Ball Valves/BallValveMount.stl
Chain Drive - OLD/CAD Design Work/Old/Inventor Design Project/Actuated Ball Valves/OldVersions/Assembled Valve Actuator.0004.iam
Chain Drive - OLD/CAD Design Work/Old/Inventor Design Project/Actuated Ball Valves/OldVersions/Ball Valve Mount 4.0001.ipt
Chain Drive - OLD/CAD Design Work/Old/Inventor Design Project/Actuated Ball Valves/OldVersions/Ball Valve Mount.0007.ipt
Chain Drive - OLD/CAD Design Work/Old/Inventor Design Project/Actuated Ball Valves/OldVersions/BallValveMount.0002.ipt
Chain Drive - OLD/CAD Design Work/Old/Inventor Design Project/Actuated Ball Valves/OldVersions/Handle Servo Interface.0004.ipt
Chain Drive - OLD/CAD Design Work/Old/Inventor Design Project/Actuated Ball Valves/OldVersions/SUBBallValve.0003.iam
Chain Drive - OLD/CAD Design Work/Old/Inventor Design Project/Actuated Ball Valves/OldVersions/Servo Actuated Ball Valve Shell Mount.0002.ipt
Chain Drive - OLD/CAD Design Work/Old/Inventor Design Project/Actuated Ball Valves/OldVersions/Servo Actuated Ball Valves.0001.ipt
Chain Drive - OLD/CAD Design Work/Old/Inventor Design Project/Actuated Ball Valves/OldVersions/Servo Adapter 4.0003.ipt
Chain Drive - OLD/CAD Design Work/Old/Inventor Design Project/Actuated Ball Valves/OldVersions/Servo Mount V4.0001.ipt
Chain Drive - OLD/CAD Design Work/Old/Inventor Design Project/Actuated Ball Valves/OldVersions/Servo Mount V5.0004.ipt
Chain Drive - OLD/CAD Design Work/Old/Inventor Design Project/Actuated Ball Valves/OldVersions/Servo Mount and Screw Hole Test.0001.ipt
Chain Drive - OLD/CAD Design Work/Old/Inventor Design Project/Actuated Ball Valves/OldVersions/Servo Mount.0007.ipt
Chain Drive - OLD/CAD Design Work/Old/Inventor Design Project/Actuated Ball Valves/OldVersions/Servo Test Mount.0001.ipt
Chain Drive - OLD/CAD Design Work/Old/Inventor Design Project/Actuated Ball Valves/OldVersions/V4.0001.iam
Chain Drive - OLD/CAD Design Work/Old/Inventor Design Project/Actuated Ball Valves/SUBBallValve.iam
Chain Drive - OLD/CAD Design Work/Old/Inventor Design Project/Actuated Ball Valves/ServoAdapter.ipt
Chain Drive - OLD/CAD Design Work/Old/Inventor Design Project/Actuated Ball Valves/ServoAdapter.stl
Chain Drive - OLD/CAD Design Work/Old/Inventor Design Project/Actuated Ball Valves/ServoMount.ipt
Chain Drive - OLD/CAD Design Work/Old/Inventor Design Project/Actuated Ball Valves/ServoMount.stl
Chain Drive - OLD/CAD Design Work/Old/Inventor Design Project/Actuated Ball Valves/ServoSimplified.ipt
Chain Drive - OLD/CAD Design Work/Old/Inventor Design Project/Actuated Ball Valves/V2/Ball Valve Mount 2.ipt
Chain Drive - OLD/CAD Design Work/Old/Inventor Design Project/Actuated Ball Valves/V2/Ball Valve Mount 2.stl
Chain Drive - OLD/CAD Design Work/Old/Inventor Design Project/Actuated Ball Valves/V2/Handle Servo Interface 2.ipt
Chain Drive - OLD/CAD Design Work/Old/Inventor Design Project/Actuated Ball Valves/V2/Handle Servo Interface 2.stl
Chain Drive - OLD/CAD Design Work/Old/Inventor Design Project/Actuated Ball Valves/V2/OldVersions/Ball Valve Mount 2.0003.ipt
Chain Drive - OLD/CAD Design Work/Old/Inventor Design Project/Actuated Ball Valves/V2/OldVersions/Handle Servo Interface 2.0001.ipt
Chain Drive - OLD/CAD Design Work/Old/Inventor Design Project/Actuated Ball Valves/V3/Assembled Valve Actuator.iam
Chain Drive - OLD/CAD Design Work/Old/Inventor Design Project/Actuated Ball Valves/V3/Ball Valve Mount 3.ipt
Chain Drive - OLD/CAD Design Work/Old/Inventor Design Project/Actuated Ball Valves/V3/Ball Valve Mount.ipt
Chain Drive - OLD/CAD Design Work/Old/Inventor Design Project/Actuated Ball Valves/V3/Ball Valve Mount.stl
Chain Drive - OLD/CAD Design Work/Old/Inventor Design Project/Actuated Ball Valves/V3/Handle Servo Interface.ipt
Chain Drive - OLD/CAD Design Work/Old/Inventor Design Project/Actuated Ball Valves/V3/Handle Servo Interface.stl
Chain Drive - OLD/CAD Design Work/Old/Inventor Design Project/Actuated Ball Valves/V3/KK_Servo Mount.3mf
Chain Drive - OLD/CAD Design Work/Old/Inventor Design Project/Actuated Ball Valves/V3/Servo Mount.ipt
Chain Drive - OLD/CAD Design Work/Old/Inventor Design Project/Actuated Ball Valves/V3/Servo Mount.stl
Chain Drive - OLD/CAD Design Work/Old/Inventor Design Project/Actuated Ball Valves/V4/Ball Valve Mount 4.ipt
Chain Drive - OLD/CAD Design Work/Old/Inventor Design Project/Actuated Ball Valves/V4/Ball Valve Mount 4.stl
Chain Drive - OLD/CAD Design Work/Old/Inventor Design Project/Actuated Ball Valves/V4/Servo Adapter 4.ipt
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
