tommyrohmann/Microgravity-Press-Washing-Machine/Sub-System Design and Documentation/4 Structure and Drive Train Assembly/Research Documents.docx

Formulas

Material Properties

Fatigue properties and endurance limits of stainless steels – British Stainless Steel Association (bssa.org.uk) (https://bssa.org.uk/bssa_articles/fatigue-properties-and-endurance-limits-of-stainless-steels/)

austeniticchromium_nickelstainlesssteelsatambienttemperaturesmechanicalandphysicalproperties_2978_.pdf (nickelinstitute.org) (https://nickelinstitute.org/media/1636/austeniticchromium_nickelstainlesssteelsatambienttemperaturesmechanicalandphysicalproperties_2978_.pdf)

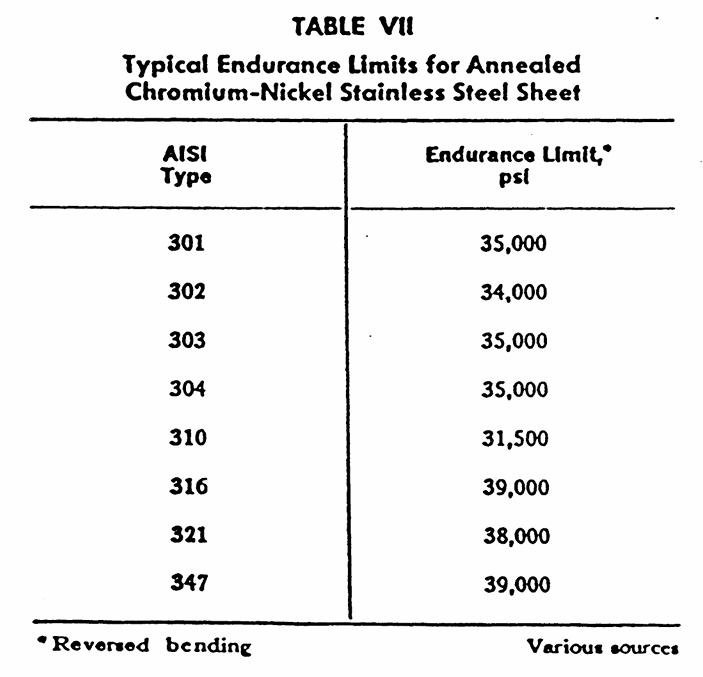
[picture p55: figure]

Drive Chain Efficiency

How Much Does A Dirty Bicycle Chain Slow You Down? (Drive Efficiency Test) - CYCLINGABOUT (https://www.cyclingabout.com/how-much-does-a-dirty-bicycle-chain-slow-you-down/)
