tommyrohmann/Microgravity-Press-Washing-Machine/Sub-System Design and Documentation/4 Structure and Drive Train Assembly/303 SS.pdf

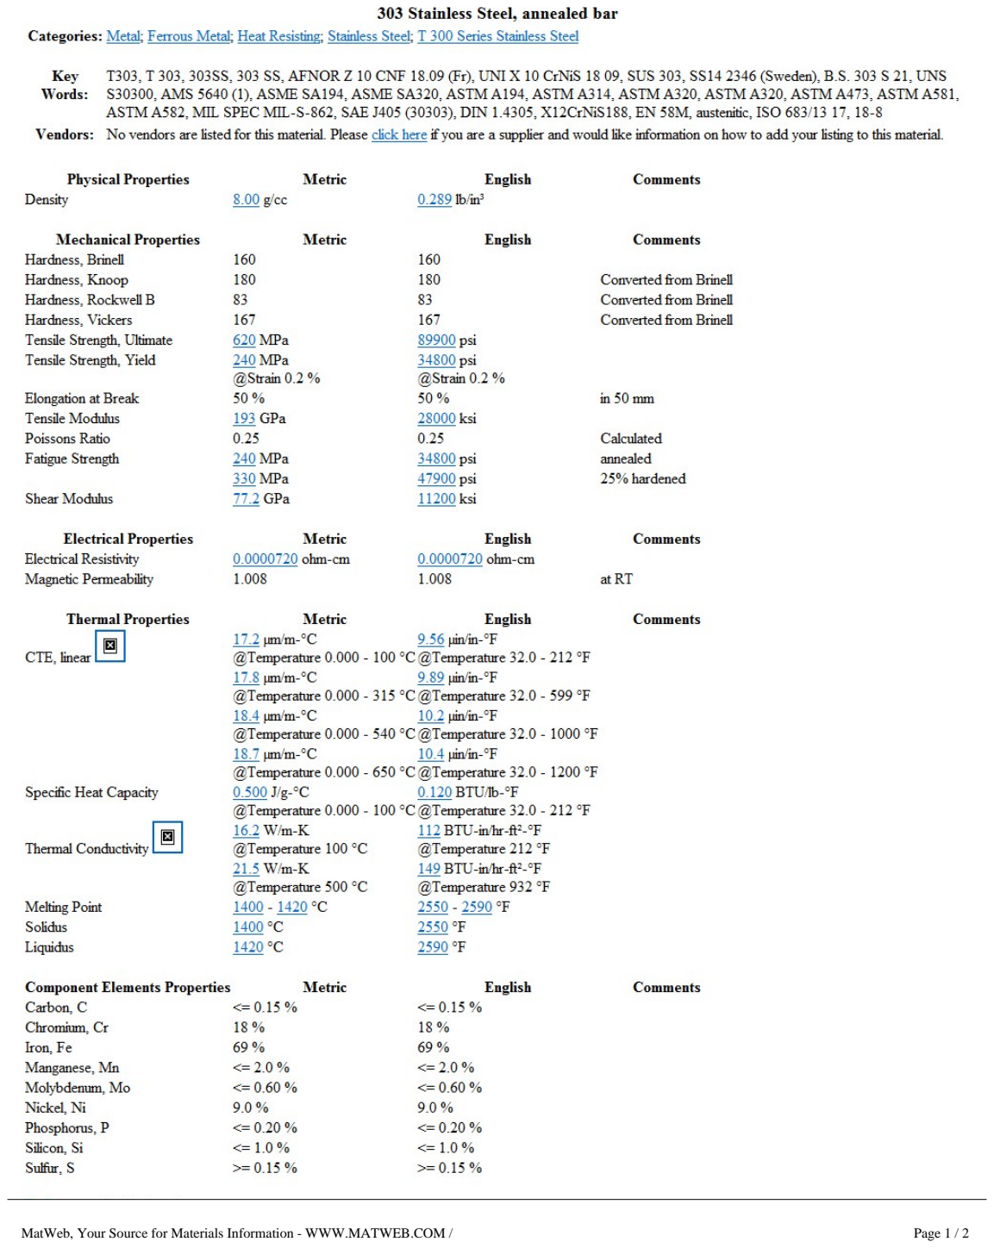
[picture p56: page 1]

MatWeb, Your Source for Materials Information - WWW.MATWEB.COM /

MatWeb, Your Source for Materials Information - WWW.MATWEB.COM /
