tommyrohmann/Microgravity-Press-Washing-Machine/Code/Wash_Instructions/Default_Cycle.xlsx

WSN | SSN | Action_Description | oVCW | oVSW | oVWC | oVA | oVPR1 | oVPR2 | oVRT | oVCT | oPW | oPV | oPD | S1 | S2 | E1 | E2 | S2R | S2V | E1T | E1R | E1V | E2T | E2R | E2V
Hydration |  | Fill Reservoir/Push out air/Compression | O | C | C | A | F | F | O | C | 1 | 0 | 0 | iPT1 | > |  | Compression Press > Max
 |  | Evacuate Air From Clothing | C | C | O | V | F | F | C | C | 0 | 1 | 0 |  |  |  | Wash Chamber Press < Min
 |  | Set Ret Tk Volume/Initial Compression | C | C | O | S | R | R | O | C | 1 | 0 | 0 | iTd | > | VTD | Time Delay > Preset
 | Admit Detergent | Admit Detergent | O | C | O | S | R | R | C | C | 0 | 0 | 1 |  |  |  | Time Delay > Preset
 | Press Up Tk | Tk to Chamber | C | C | O | S | R | R | C | O | 1 | 0 | 0 |  |  |  | Tk Pressure, Below Suct, loss of suct pressure
 |  | Press Up Tk | O | C | C | S | F | F | C | O | 1 | 0 | 0 |  |  |  | Tk Pressure > ~60
Agitation 1 |  | Tk to Chamber | C | C | O | S | R | R | C | O | 1 | 0 | 0 |  |  |  | Chamber Pressure > Max
 |  | Chamber to Tk | C | C | O | S | F | F | C | O | 1 | 0 | 0 |  |  |  | Tk Pressure >Max
Refresh Water 1 |  | Air to Chamber, Soiled Water to Outlet | C | O | C | A | R | R | C | O | 1 | 0 | 0 |  |  |  | Tk Pressure, Below Suct, loss of suct pressure
 |  | Take In New Water | O | C | C | A | F | F | C | O | 1 | 0 | 0
 |  | Evacuate Air From Clothing | C | C | O | V | F | F | C | O | 0 | 1 | 0
 |  | Tk to Chamber | C | C | O | S | R | R | C | O | 1 | 0 | 0 |  |  |  | Tk Pressure, Below Suct, loss of suct pressure
 |  | Press Up Tk | O | C | C | S | F | F | C | O | 1 | 0 | 0 |  |  |  | Tk Pressure > ~60
Agitation 2 |  | Tk to Chamber | C | C | O | S | R | R | C | O | 1 | 0 | 0 |  |  |  | Chamber Pressure > Max
 |  | Chamber to Tk | C | C | O | S | F | F | C | O | 1 | 0 | 0 |  |  |  | Tk Pressure >Max
Refresh Water 1 |  | Air to Chamber, Soiled Water to Outlet | C | O | C | A | R | R | C | O | 1 | 0 | 0 |  |  |  | Tk Pressure, Below Suct, loss of suct pressure
 |  | Take In New Water | O | C | C | A | F | F | C | O | 1 | 0 | 0
 |  | Evacuate Air From Clothing | C | C | O | V | F | F | C | O | 0 | 1 | 0
 |  | Tk to Chamber | C | C | O | S | R | R | C | O | 1 | 0 | 0 |  |  |  | Tk Pressure, Below Suct, loss of suct pressure
 |  | Press Up Tk | O | C | C | S | F | F | C | O | 1 | 0 | 0 |  |  |  | Tk Pressure > ~60
Agitation 2 |  | Tk to Chamber | C | C | O | S | R | R | C | O | 1 | 0 | 0 |  |  |  | Chamber Pressure > Max
 |  | Chamber to Tk | C | C | O | S | F | F | C | O | 1 | 0 | 0 |  |  |  | Tk Pressure >Max
Drying | Water Evacuation | Air to Chamber, Soiled Water to Outlet | C | O | C | A | R | R | C | O | 1 | 0 | 0 |  |  |  | Tk Pressure, Below Suct, loss of suct pressure
 |  | Discharge Retention Tk | C | O | C | A | R | R | O | C | 1 | 0 | 0
