tommyrohmann/Microgravity-Press-Washing-Machine/Code/Dev/Config/InstructOutputFormat.xlsx

Function | Actuator_Name | Variable_Name | Data_Type | Input Range | Corrosponding_Hardware_Response
Metadata/Display | Wash State Name | WSN | str | str | [Name of Wash State in Cycle]
Metadata/Display | Sub State Name | SSN | str | str | [Substate of Wash State]
ESP Instructions | Washwater Inlet Valve | VA_WWI | int | 0 or 1 | 0: Closed, 1: Open
ESP Instructions | Washwater Outlet Valve | VA_WWO | int | 0 or 1 | 0: Closed, 1: Open
ESP Instructions | Cross-over Valve | VA_XO | int | 0 or 1 | 0: Closed, 1: Open
ESP Instructions | Air Valve | VA_A | int | 0 or 1 | 0: Closed, 1: Open
ESP Instructions | Valve Bus | VB | int | 0 or 1 | [ON/OFF]
ESP Instructions | Wash Piston Drive Motor | DM_Wash | arr | [-1,0,1],[0-1000] | ([FWD/REV/OFF],[Speed])
ESP Instructions | Reservoir Piston Drive Motor | DM_Res | arr | [-1,0,1],[0-1000] | ([FWD/REV/OFF],[Speed])
ESP Instructions | DetergentDosingPump | P_DD | int | 0 or 1 | [ON/OFF]
ESP Instructions | Next State Trigger | NST1 | arr | [[int],[-1,0,1],[int]], … | (([Sensor Index],[<,>],[Value]),…)
ESP Instructions | Next State Trigger | NST2 | arr | [[int],[-1,0,1],[int]], … | (([Sensor Index],[<,>],[Value]),…)
ESP Instructions | State Specific Safety Trigger | S3T | arr | [[int],[-1,0,1],[int]], … | (([Sensor Index],[<,>],[Value]),…)
