tommyrohmann/Microgravity-Press-Washing-Machine/Code/Dev/ProcessFiles/WashInstructions/ProcessModifiers/SafetyStopConditions.xlsx

Condition | SensorName | CompareMode | SensorValue
ACCESS_HATCH_OPEN
WASH_NET_FORCE_CEILING | 8,1,800
RES_NET_FORCE_CEILING | 9,1,800
WASH_DELTA_FORCE_CEILING | 10,1,50
WASH_DELTA_FORCE_CEILING | 11,1,50
Current_Limit | 13,1,TBD
