tommyrohmann/Microgravity-Press-Washing-Machine/Code/Dev/ProcessFiles/WashInstructions/WashProcessCreationAids/Initiate_and_Abort_Config.xlsx

WSN | SSN | VA_WWI | VA_WWO | VA_XO | VA_A | VB | DM_Wash | DM_Res | P_DD | NST | S3T
 | Valve Safe State | 0 | 0 | 1 | 1 | 1 | 0,0 | 0,0 | 0 | (
