tommyrohmann/Microgravity-Press-Washing-Machine/Bending Guide Resources.xlsx

https://sendcutsend.com/guidelines/bending/
https://sendcutsend.com/bending-calculator/
https://sendcutsend.com/blog/guide-to-calculating-bend-allowance-and-bend-deduction/
