tommyrohmann/Microgravity-Press-Washing-Machine/Code/Tutorials Used.xlsx

UI in TTK Bootstrap | https://ttkbootstrap.readthedocs.io/en/latest/
Live Telemetry MatplotLib | https://www.youtube.com/watch?v=Ercd-Ip5PfQ&ab_channel=CoreySchafer
