tommyrohmann/Microgravity-Press-Washing-Machine/Code/Dev/ProcessFiles/WashInstructions/Default_Wash_Cycle.xlsx

WSN | SSN | VA_WWI | VA_WWO | VA_XO | VA_A | VB | DM_DIR_WASH | DM_SPD_WASH | DM_DIR_RES | DM_SPD_RES | P_DD | NST1_i | NST1_r | NST1_v | NST2_i | NST2_r | NST2_v
PREWASH | RESERVOIR PISTON RETRACT | 0 | 0 | 1 | 1 | 1 | 2 | 1000 | 0 | 1000 | 0 | 16 | 2 | Depressed
 | WASH PISTON RETRACT | NaN | NaN | NaN | NaN | NaN | 0 | NaN | 2 | NaN | NaN | 17 | 2 | Depressed
HYDRATION | PURGING AIR | 0 | NaN | 1 | 1 | NaN | 1 | NaN | 0 | NaN | NaN | 8 | 1 | Comp | 18 | 2 | Depressed
 | START DETERGENT DOSE | NaN | NaN | 0 | 0 | 0 | 0 | NaN | NaN | NaN | 1 | 21 | 1 | 500
 | END DETERGENT DOSE | NaN | NaN | NaN | NaN | NaN | NaN | NaN | NaN | NaN | 0 | 21 | 1 | 500
 | DRAWING WATER | 1 | NaN | 0 | 1 | 1 | 2 | NaN | NaN | NaN | NaN | 17 | 2 | Depressed
AGITATION | COMPRESSION 1 | 0 | NaN | 1 | 0 | NaN | 1 | NaN | NaN | NaN | NaN | 8 | 1 | Comp | 18 | 2 | Depressed
 | DECOMPRESSION 1 | NaN | NaN | NaN | NaN | NaN | 2 | NaN | NaN | NaN | NaN | 17 | 2 | Depressed
 | COMPRESSION 2 | NaN | NaN | NaN | NaN | NaN | 1 | NaN | NaN | NaN | NaN | 8 | 1 | Comp | 18 | 2 | Depressed
 | DECOMPRESSION 2 | NaN | NaN | NaN | NaN | NaN | 2 | NaN | NaN | NaN | NaN | 17 | 2 | Depressed
 | COMPRESSION 3 | NaN | NaN | NaN | NaN | NaN | 1 | NaN | NaN | NaN | NaN | 8 | 1 | Comp | 18 | 2 | Depressed
 | DECOMPRESSION 3 | NaN | NaN | NaN | NaN | NaN | 2 | NaN | NaN | NaN | NaN | 17 | 2 | Depressed
SOAPY WATER PURGE | PURGING SOAPY WATER | 0 | 1 | 0 | 0 | NaN | 1 | NaN | NaN | NaN | NaN | 8 | 1 | Comp | 18 | 2 | Depressed
 | DRAWING CLEAN WATER | 1 | 0 | NaN | 1 | NaN | 2 | NaN | NaN | NaN | NaN | 17 | 2 | Depressed
RINSE AGITATE | COMPRESSION 1 | 0 | NaN | 1 | 0 | NaN | 1 | NaN | NaN | NaN | NaN | 8 | 1 | Comp | 18 | 2 | Depressed
 | DECOMPRESSION 1 | NaN | NaN | NaN | NaN | NaN | 2 | NaN | NaN | NaN | NaN | 17 | 2 | Depressed
 | COMPRESSION 2 | NaN | NaN | NaN | NaN | NaN | 1 | NaN | NaN | NaN | NaN | 8 | 1 | Comp | 18 | 2 | Depressed
 | DECOMPRESSION 2 | NaN | NaN | NaN | NaN | NaN | 2 | NaN | NaN | NaN | NaN | 17 | 2 | Depressed
 | COMPRESSION 3 | NaN | NaN | NaN | NaN | NaN | 1 | NaN | NaN | NaN | NaN | 8 | 1 | Comp | 18 | 2 | Depressed
 | DECOMPRESSION 3 | NaN | NaN | NaN | NaN | NaN | 2 | NaN | NaN | NaN | NaN | 17 | 2 | Depressed
DRYING | PURGING WATER | 0 | 1 | 0 | 0 | NaN | 1 | NaN | NaN | NaN | NaN | 8 | 1 | Comp | 18 | 2 | Depressed
 | DECOMPRESSING | NaN | 0 | 1 | NaN | NaN | 2 | NaN | NaN | NaN | NaN | 21 | 1 | 2000
 | COMPRESSION DRY | NaN | 1 | 0 | NaN | NaN | 1 | NaN | NaN | NaN | NaN | 8 | 1 | Comp | 18 | 2 | Depressed
POSTWASH | RETRACTING RESERVOIR PISTON | NaN | 0 | 1 | 1 | NaN | 0 | NaN | 2 | NaN | NaN | 16 | 2 | Depressed
 | RETRACTING WASH PISTON | NaN | NaN | NaN | NaN | NaN | 2 | NaN | 0 | NaN | NaN | 17 | 2 | Depressed
