tommyrohmann/Microgravity-Press-Washing-Machine/Code/Dev/ProcessFiles/WashInstructions/ProcessRun/SafeState.xlsx

VA_WWI | VA_WWO | VA_XO | VA_A | VB | DM_DIR_WASH | DM_SPD_WASH | DM_DIR_RES | DM_SPD_RES | P_DD | NST1_i | NST1_r | NST1_v | NST2_i | NST2_r | NST2_v
0 | 0 | 0 | 0 | 1 | 0 | 0 | 0 | 0 | 0 | 0 | 0 | 0 | 0 | 0 | 0
