tommyrohmann/Microgravity-Press-Washing-Machine/Code/Dev/ProcessFiles/WashInstructions/ProcessModifiers/Default_Wash_Modifier.csv

Modifier | Value
Ag_Comp | 400
Max_Comp | 600
