tommyrohmann/Microgravity-Press-Washing-Machine/Code/Dev/ProcessFiles/WashInstructions/ProcessModifiers/HeavyCompression.xlsx

Modifier | Value
Ag_Comp | 400
Max_Comp | 600
