tommyrohmann/Microgravity-Press-Washing-Machine/Code/Dev/ProcessFiles/WashInstructions/WashProcessCreationAids/Sample_Wash_Cycles.xlsx

Sheet: BASIC_WASH
WSN | SSN | VA_WWI | VA_WWO | VA_XO | VA_A | VB | DM_DIR_WASH | DM_SPD_WASH | DM_DIR_RES | DM_SPD_RES | P_DD | NST1_i | NST1_r | NST1_v | NST2_i | NST2_r | NST2_v
PREWASH | RESERVOIR PISTON RETRACT | 0 | 0 | 1 | 1 | 1 | 2 | 1000 | 0 | 1000 | 0 | 16 | 2 | Depressed
 | WASH PISTON RETRACT | 0 | 0 | 1 | 1 | 1 | 0 | 1000 | 2 | 1000 | 0 | 17 | 2 | Depressed
HYDRATION | PURGING AIR | 0 | 0 | 1 | 1 | 1 | 1 | 1000 | 0 | 1000 | 0 | 8 | 1 | Comp | 18 | 2 | Depressed
 | DRAWING WATER | 1 | 0 | 0 | 1 | 1 | 2 | 1000 | 0 | 1000 | 0 | 17 | 2 | Depressed
AGITATION | COMPRESSION 1 | 0 | 0 | 1 | 0 | 1 | 1 | 1000 | 0 | 1000 | 0 | 8 | 1 | Comp | 18 | 2 | Depressed
 | DECOMPRESSION 1 | 0 | 0 | 1 | 0 | 1 | 2 | 1000 | 0 | 1000 | 0 | 17 | 2 | Depressed
 | COMPRESSION 2 | 0 | 0 | 1 | 0 | 1 | 1 | 1000 | 0 | 1000 | 0 | 8 | 1 | Comp | 18 | 2 | Depressed
 | DECOMPRESSION 2 | 0 | 0 | 1 | 0 | 1 | 2 | 1000 | 0 | 1000 | 0 | 17 | 2 | Depressed
 | COMPRESSION 3 | 0 | 0 | 1 | 0 | 1 | 1 | 1000 | 0 | 1000 | 0 | 8 | 1 | Comp | 18 | 2 | Depressed
 | DECOMPRESSION 3 | 0 | 0 | 1 | 0 | 1 | 2 | 1000 | 0 | 1000 | 0 | 17 | 2 | Depressed
DRYING | PURGING WATER | 0 | 1 | 0 | 0 | 1 | 1 | 1000 | 0 | 1000 | 0 | 8 | 1 | Comp | 18 | 2 | Depressed
 | DECOMPRESSING | 0 | 0 | 1 | 0 | 1 | 2 | 1000 | 0 | 1000 | 0 | 21 | 1 | 2000
 | COMPRESSION DRY | 0 | 1 | 0 | 0 | 1 | 1 | 1000 | 0 | 1000 | 0 | 8 | 1 | Comp | 18 | 2 | Depressed
POSTWASH | RETRACTING RESERVOIR PISTON | 0 | 0 | 1 | 1 | 1 | 0 | 1000 | 2 | 1000 | 0 | 16 | 2 | Depressed
 | RETRACTING WASH PISTON | 0 | 0 | 1 | 1 | 1 | 2 | 1000 | 0 | 1000 | 0 | 17 | 2 | Depressed

Sheet: WASH_WITH_DETERGENT
WSN | SSN | VA_WWI | VA_WWO | VA_XO | VA_A | VB | DM_DIR_WASH | DM_SPD_WASH | DM_DIR_RES | DM_SPD_RES | P_DD | NST1_i | NST1_r | NST1_v | NST2_i | NST2_r | NST2_v
PREWASH | RESERVOIR PISTON RETRACT | 0 | 0 | 1 | 1 | 1 | 2 | 1000 | 0 | 1000 | 0 | 16 | 2 | Depressed
 | WASH PISTON RETRACT | 0 | 0 | 1 | 1 | 1 | 0 | 1000 | 2 | 1000 | 0 | 17 | 2 | Depressed
HYDRATION | PURGING AIR | 0 | 0 | 1 | 1 | 1 | 1 | 1000 | 0 | 1000 | 0 | 8 | 1 | Comp | 18 | 2 | Depressed
 | START DETERGENT DOSE | 0 | 0 | 0 | 0 | 0 | 0 | 1000 | 0 | 1000 | 1 | 21 | 1 | 500
 | END DETERGENT DOSE | 0 | 0 | 0 | 0 | 0 | 0 | 1000 | 0 | 1000 | 0 | 21 | 1 | 500
 | DRAWING WATER | 1 | 0 | 0 | 1 | 1 | 2 | 1000 | 0 | 1000 | 0 | 17 | 2 | Depressed
AGITATION | COMPRESSION 1 | 0 | 0 | 1 | 0 | 1 | 1 | 1000 | 0 | 1000 | 0 | 8 | 1 | Comp | 18 | 2 | Depressed
 | DECOMPRESSION 1 | 0 | 0 | 1 | 0 | 1 | 2 | 1000 | 0 | 1000 | 0 | 17 | 2 | Depressed
 | COMPRESSION 2 | 0 | 0 | 1 | 0 | 1 | 1 | 1000 | 0 | 1000 | 0 | 8 | 1 | Comp | 18 | 2 | Depressed
 | DECOMPRESSION 2 | 0 | 0 | 1 | 0 | 1 | 2 | 1000 | 0 | 1000 | 0 | 17 | 2 | Depressed
 | COMPRESSION 3 | 0 | 0 | 1 | 0 | 1 | 1 | 1000 | 0 | 1000 | 0 | 8 | 1 | Comp | 18 | 2 | Depressed
 | DECOMPRESSION 3 | 0 | 0 | 1 | 0 | 1 | 2 | 1000 | 0 | 1000 | 0 | 17 | 2 | Depressed
SOAPY WATER PURGE | PURGING SOAPY WATER | 0 | 1 | 0 | 0 | 1 | 1 | 1000 | 0 | 1000 | 0 | 8 | 1 | Comp | 18 | 2 | Depressed
 | DRAWING CLEAN WATER | 1 | 0 | 0 | 1 | 1 | 2 | 1000 | 0 | 1000 | 0 | 17 | 2 | Depressed
RINSE AGITATE | COMPRESSION 1 | 0 | 0 | 1 | 0 | 1 | 1 | 1000 | 0 | 1000 | 0 | 8 | 1 | Comp | 18 | 2 | Depressed
 | DECOMPRESSION 1 | 0 | 0 | 1 | 0 | 1 | 2 | 1000 | 0 | 1000 | 0 | 17 | 2 | Depressed
 | COMPRESSION 2 | 0 | 0 | 1 | 0 | 1 | 1 | 1000 | 0 | 1000 | 0 | 8 | 1 | Comp | 18 | 2 | Depressed
 | DECOMPRESSION 2 | 0 | 0 | 1 | 0 | 1 | 2 | 1000 | 0 | 1000 | 0 | 17 | 2 | Depressed
 | COMPRESSION 3 | 0 | 0 | 1 | 0 | 1 | 1 | 1000 | 0 | 1000 | 0 | 8 | 1 | Comp | 18 | 2 | Depressed
 | DECOMPRESSION 3 | 0 | 0 | 1 | 0 | 1 | 2 | 1000 | 0 | 1000 | 0 | 17 | 2 | Depressed
DRYING | PURGING WATER | 0 | 1 | 0 | 0 | 1 | 1 | 1000 | 0 | 1000 | 0 | 8 | 1 | Comp | 18 | 2 | Depressed
 | DECOMPRESSING | 0 | 0 | 1 | 0 | 1 | 2 | 1000 | 0 | 1000 | 0 | 21 | 1 | 2000
 | COMPRESSION DRY | 0 | 1 | 0 | 0 | 1 | 1 | 1000 | 0 | 1000 | 0 | 8 | 1 | Comp | 18 | 2 | Depressed
POSTWASH | RETRACTING RESERVOIR PISTON | 0 | 0 | 1 | 1 | 1 | 0 | 1000 | 2 | 1000 | 0 | 16 | 2 | Depressed
 | RETRACTING WASH PISTON | 0 | 0 | 1 | 1 | 1 | 2 | 1000 | 0 | 1000 | 0 | 17 | 2 | Depressed

Sheet: SAFE_STATE
WSN | SSN | VA_WWI | VA_WWO | VA_XO | VA_A | VB | DM_Wash | DM_Res | P_DD | NST1 | NST2 | S3T
 | SAFE_TRANSIENT_STATE |  |  |  |  | 0 | 0,0 | 0,0 | 0 | 21,1,500 |  | 21,1,6000

Sheet: INITIALIZATION
WSN | SSN | VA_WWI | VA_WWO | VA_XO | VA_A | VB | DM_Wash | DM_Res | P_DD | NST1 | NST2 | S3T
INITIALIZATION | INITIALIZATION | 0 | 0 | 0 | 0 | 0 | 0,0 | 0,0 | 0 | 21,1,500 |  | 21,1,6000
HYDRATION_PHASE |  | 0 | 0 | 0 | 0 | 0 | 0,0 | 0,0 | 0 | 21,1,500 |  | 21,1,6000
 | CONFIGURE_VALVES | 0 | 0 | 0 | 0 | 1 | 0,0 | 0,0 | 0
 |  | 1 | 0 | 0 | 1 | 1 | 0,0 | 0,0 | 0

Sheet: COMMON_STOPS
 |  | E-STOP CONDITIONS
NAME | INSTRUCTIONS | NAME | VALUES
TIMEOUT | 21,1,500 | WASH_NET_FORCE_CEILING | 8,1,800
WASH_NET_FORCE_STOP | 8,1,600 | RES_NET_FORCE_CEILING | 9,1,800
RES_NET_FORCE_STOP | 9,1,600 | WASH_DELTA_FORCE_CEILING | 10,1,50
LMT_SW_WASH_EXT |  | WASH_DELTA_FORCE_CEILING | 11,1,50
LMT_SW_RES_RET |  | POWER_DRAW_CEILING | 13,1,TBD
LMT_SW_ |  | ACCESS_HATCH_OPEN | 20,2,0
