tommyrohmann/Microgravity-Press-Washing-Machine/PressureCalibration.xlsx

True Measurement | IPT1 | IPT2
0 | 355 | 379
1 | 843 | 786
2 | 1072 | 1114
3 | 1741 | 1673
4 | 2121
