tommyrohmann/Microgravity-Press-Washing-Machine/Chain Drive - OLD/CAD Design Work/Old/Inventor Design Project/Actuated Ball Valves/Torque Test/Valve Torque Test Results.docx

Maximum force experienced across the valve before movement in wet and dry condition were largely the same.

Force: .5 lbf

Moment Arm: 4 inches

Moment = 2 in*lbf

“= 0.226 N-m

“=2.304 kg*cm
