tommyrohmann/Microgravity-Press-Washing-Machine/Sub-System Design and Documentation/1 Piston Assembly/Piston Seals.pdf

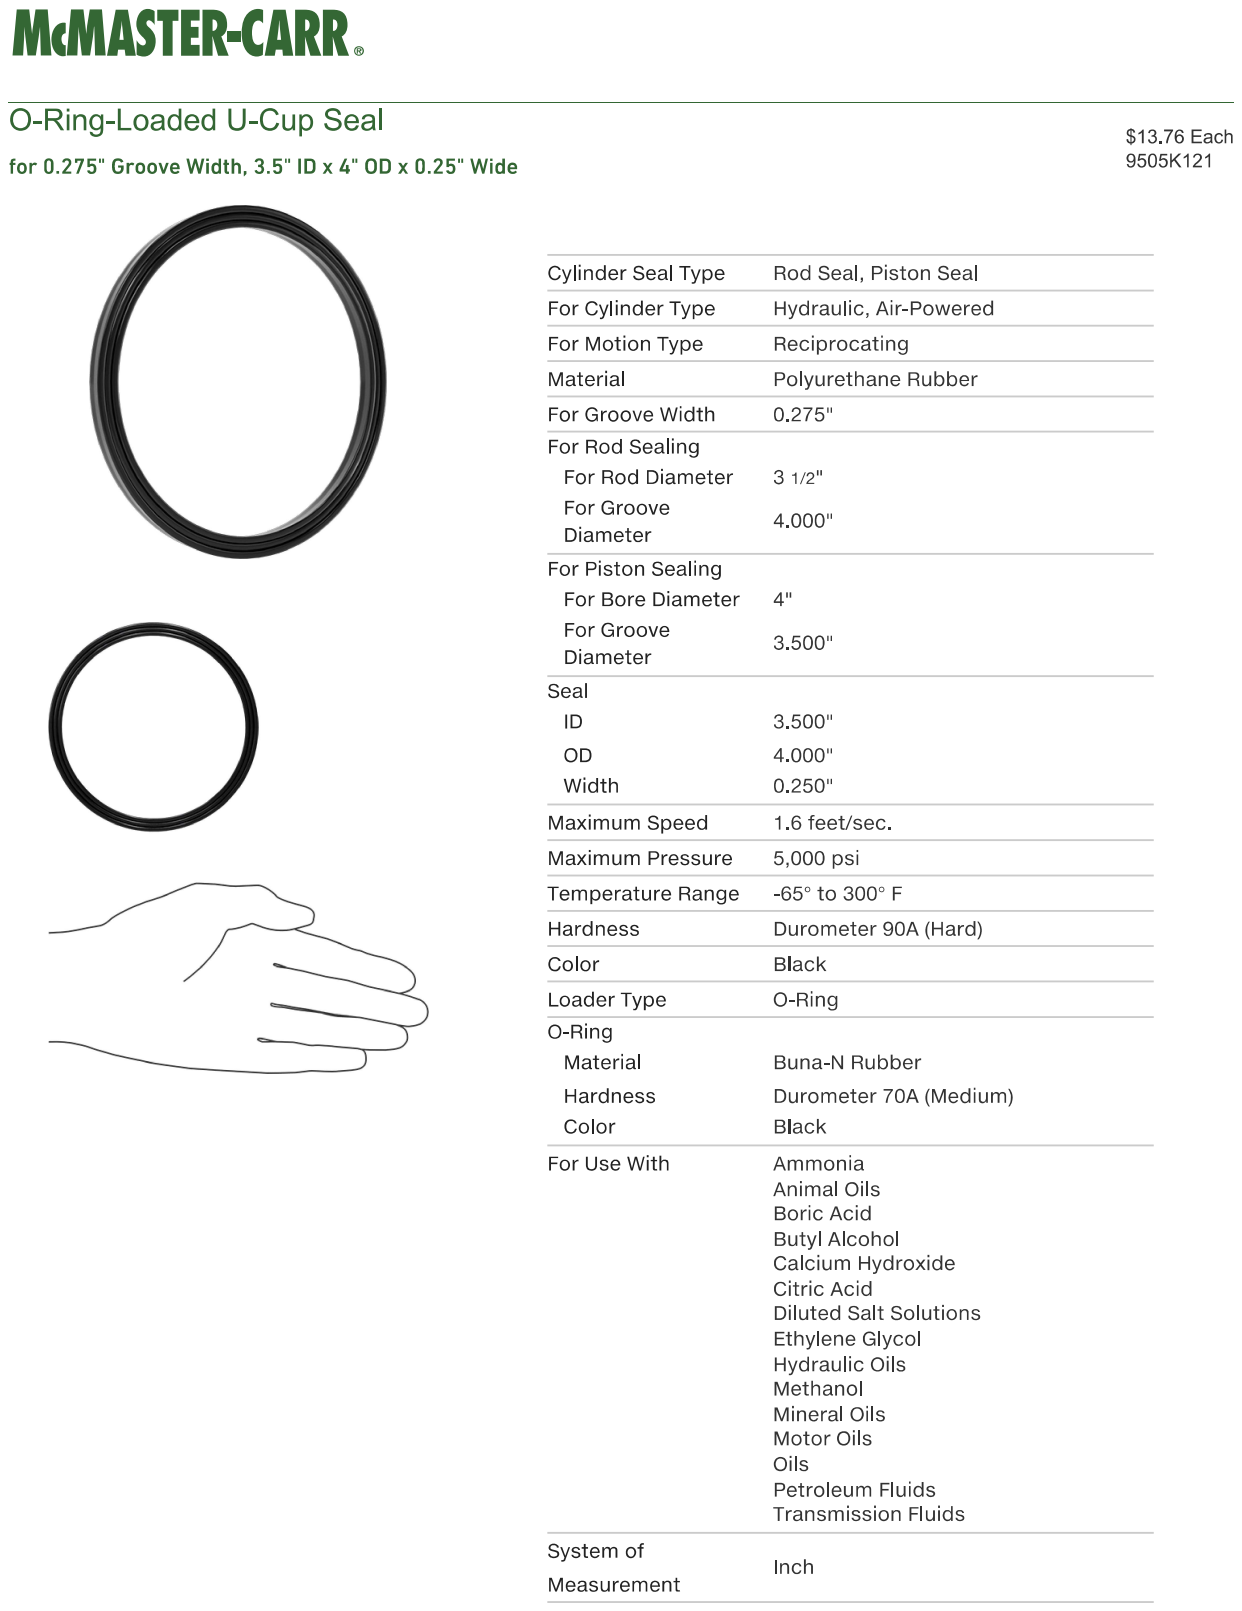
[picture p65: page 1]

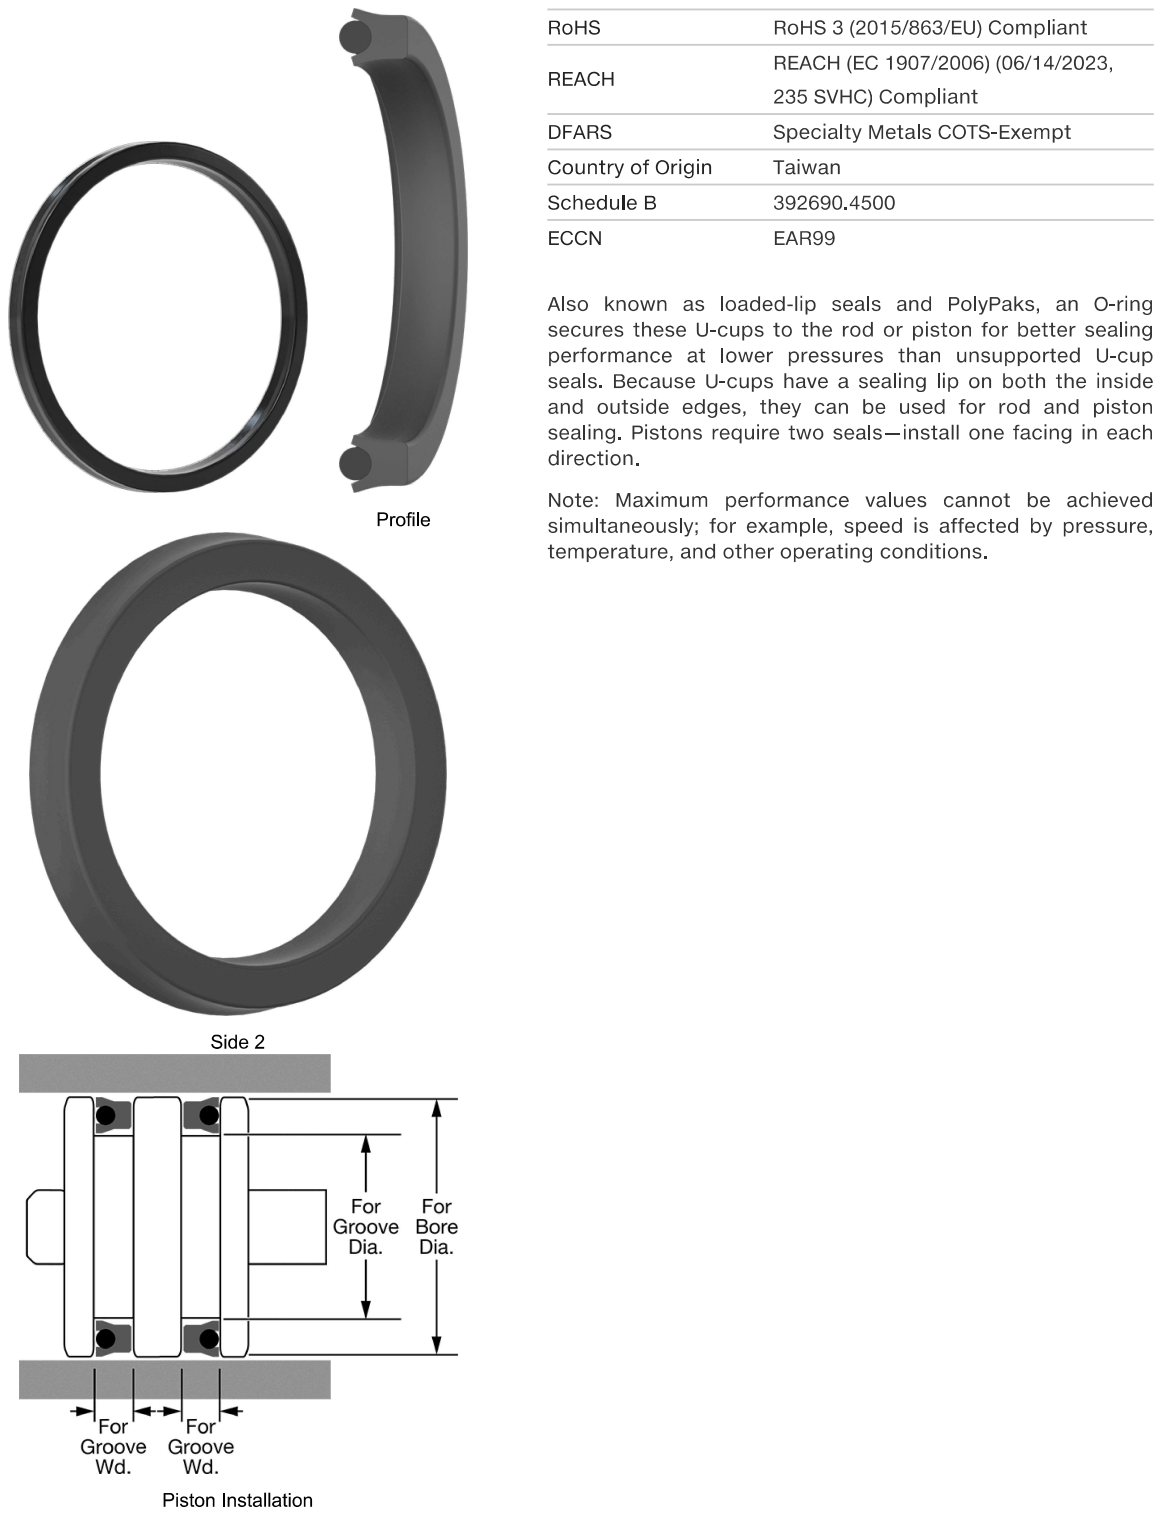
[picture p66: page 2]

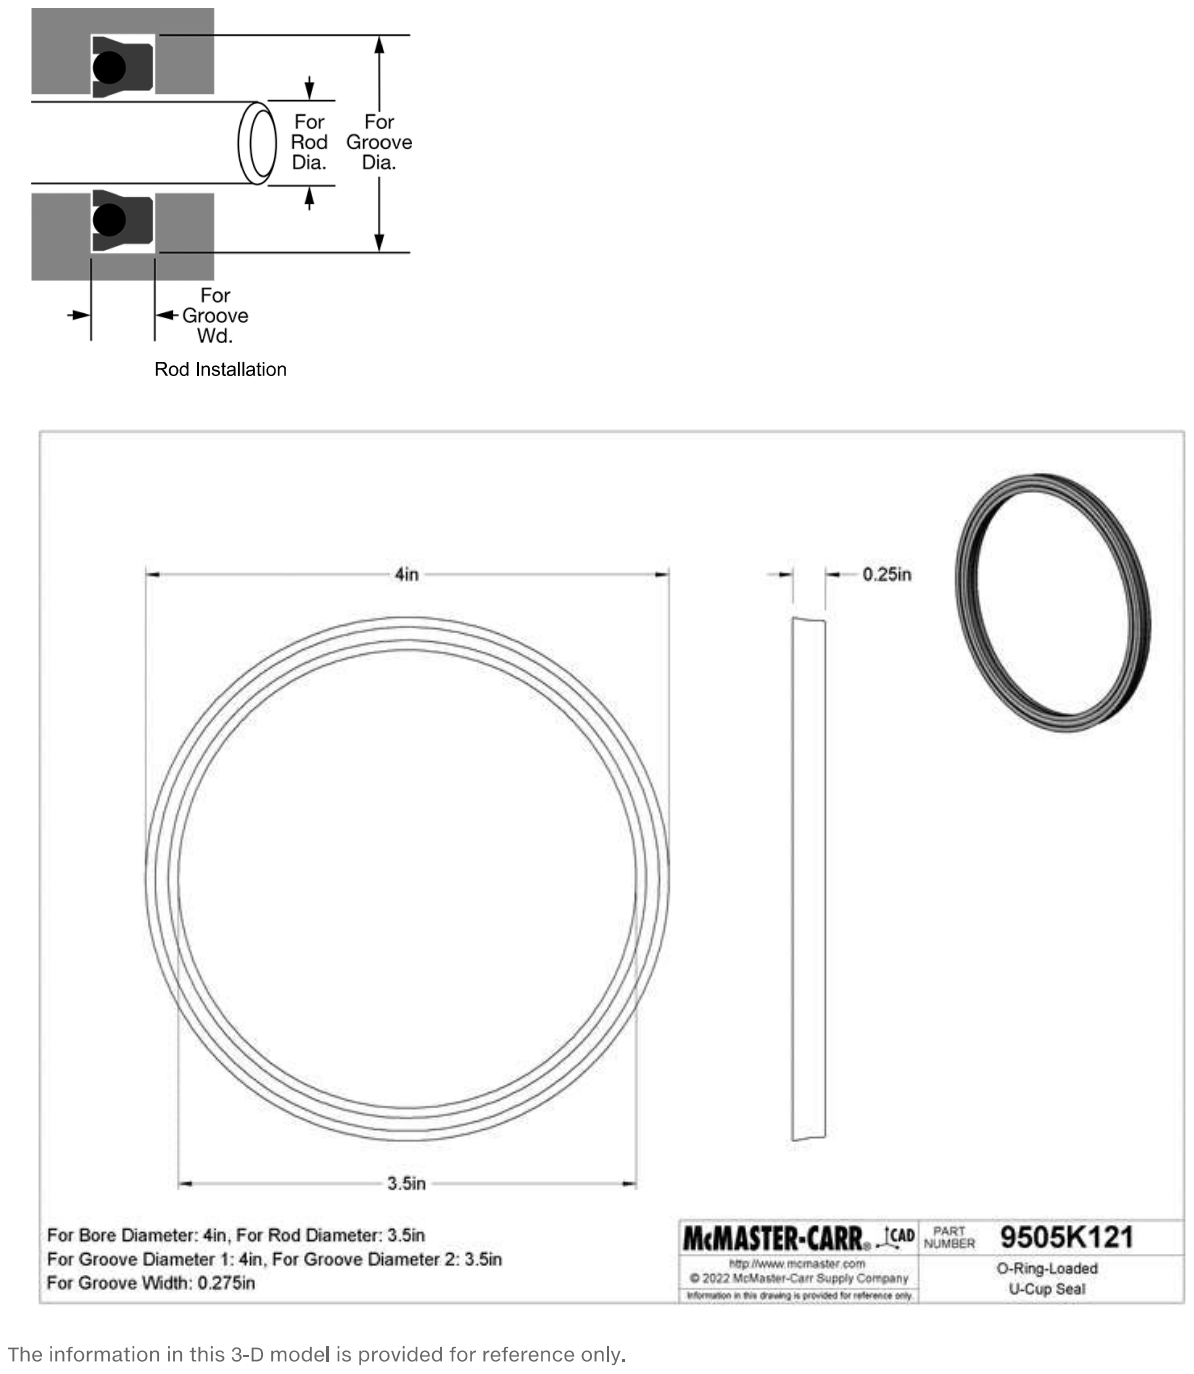
[picture p67: page 3]
