tommyrohmann/Microgravity-Press-Washing-Machine/Sub-System Design and Documentation/2 Chamber Top Piston Assembly/Shaft Seal.pdf

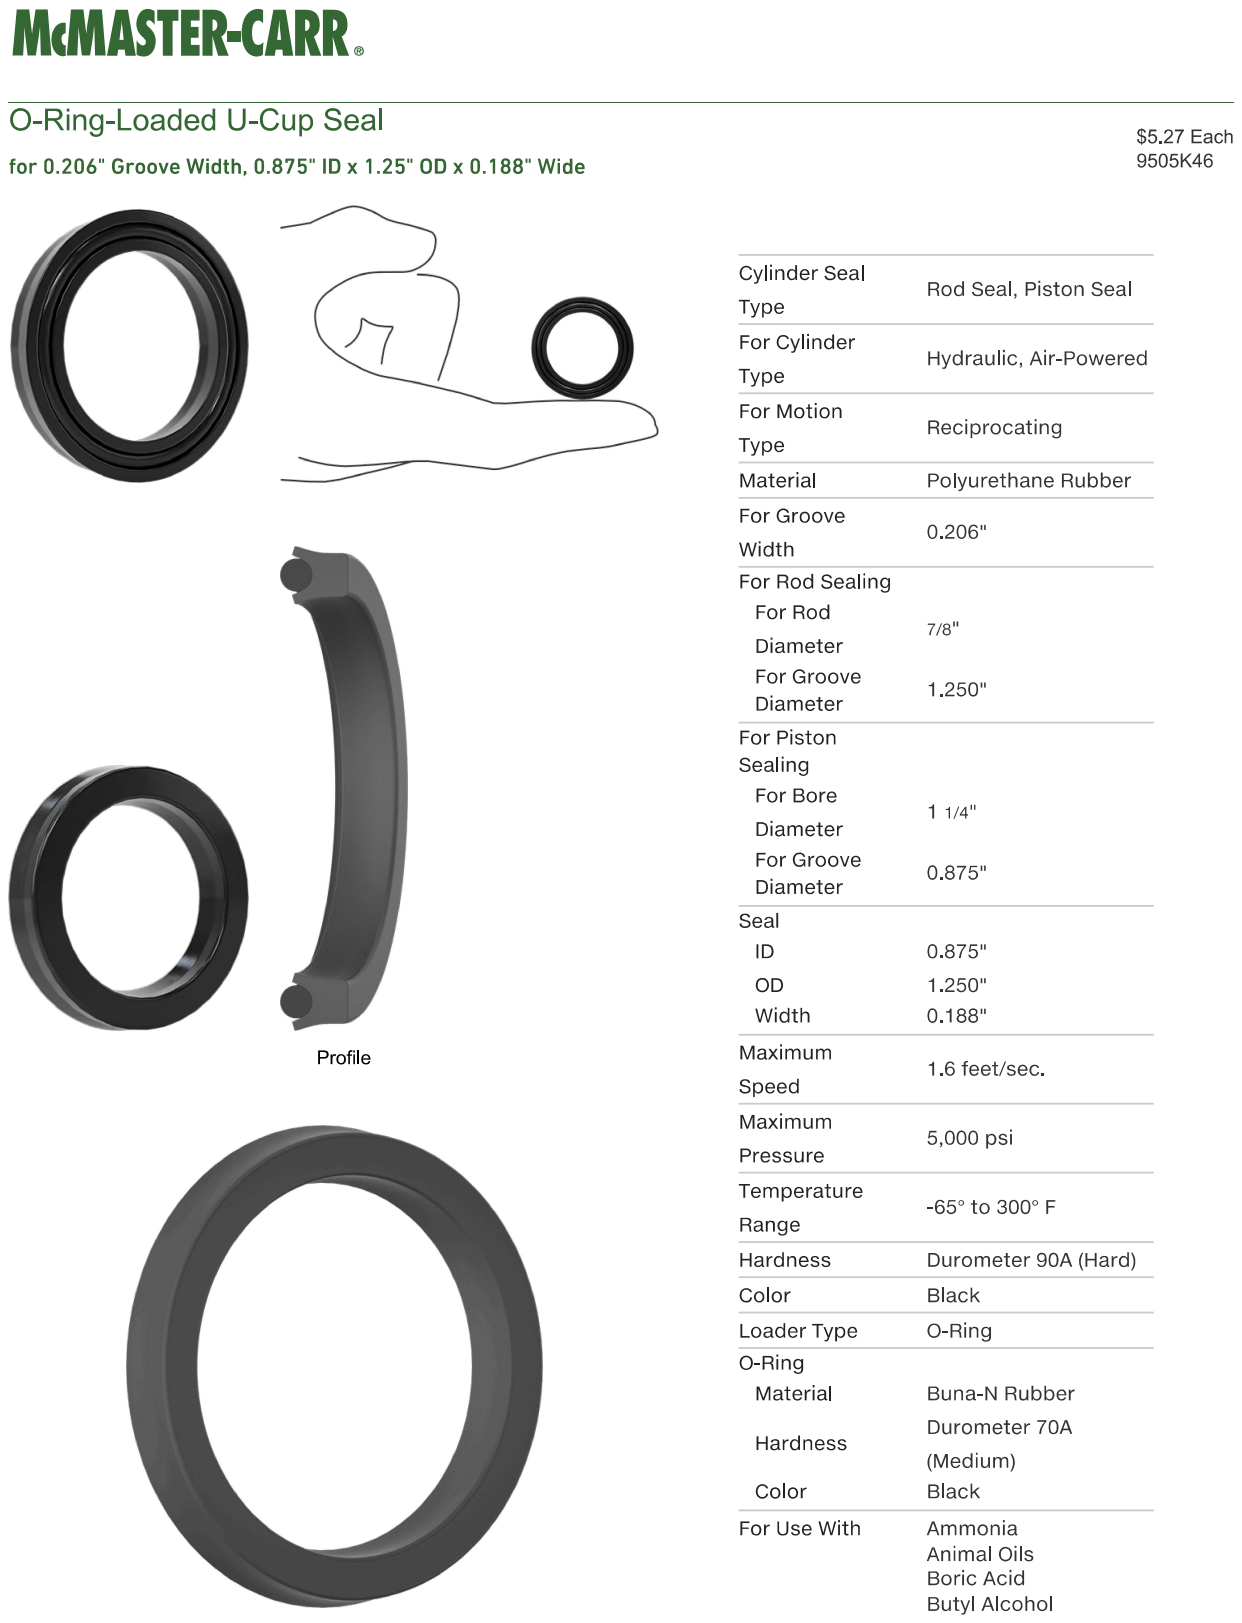
[picture p68: page 1]

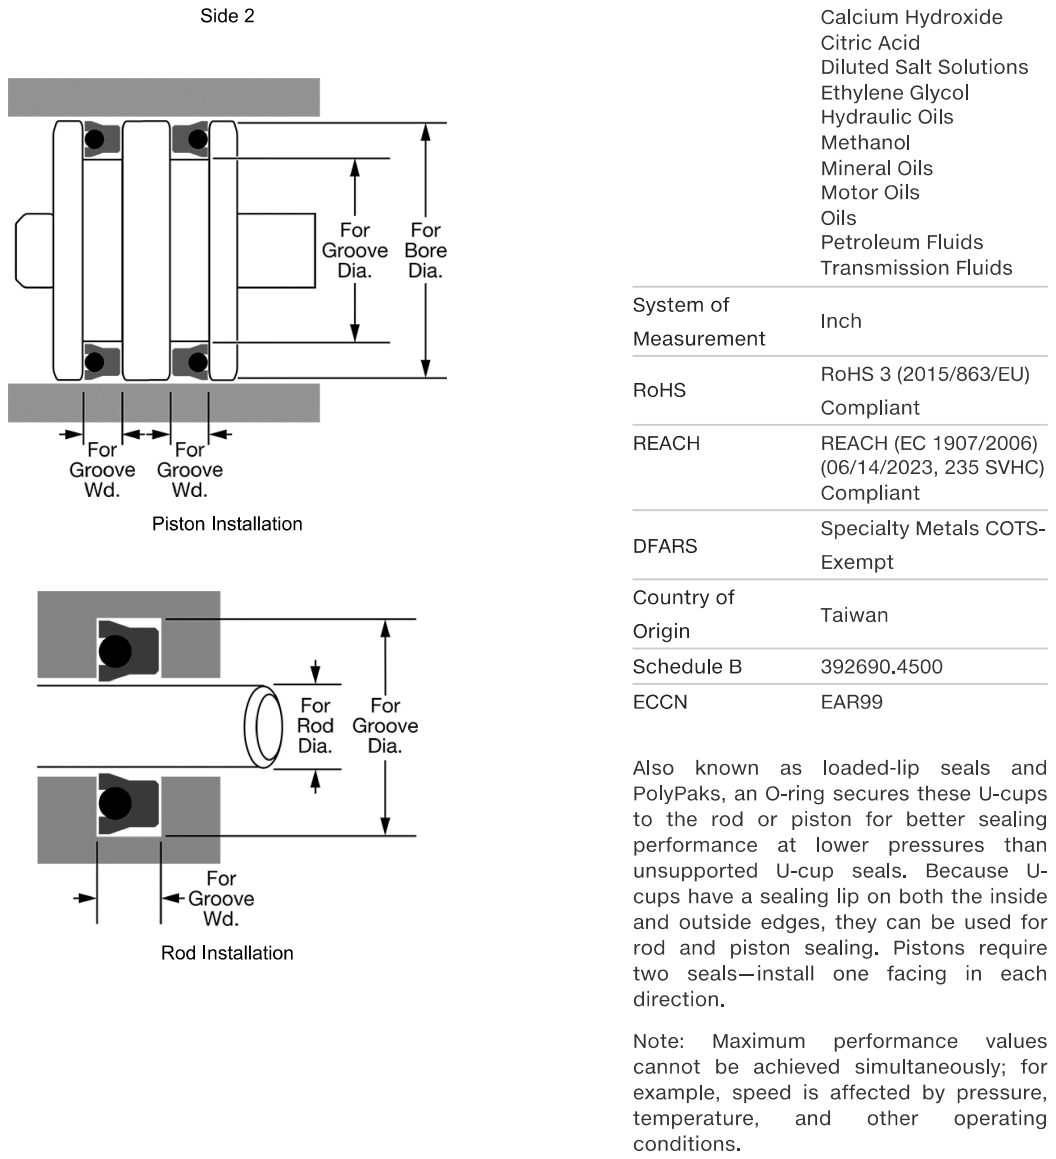
[picture p69: page 2]

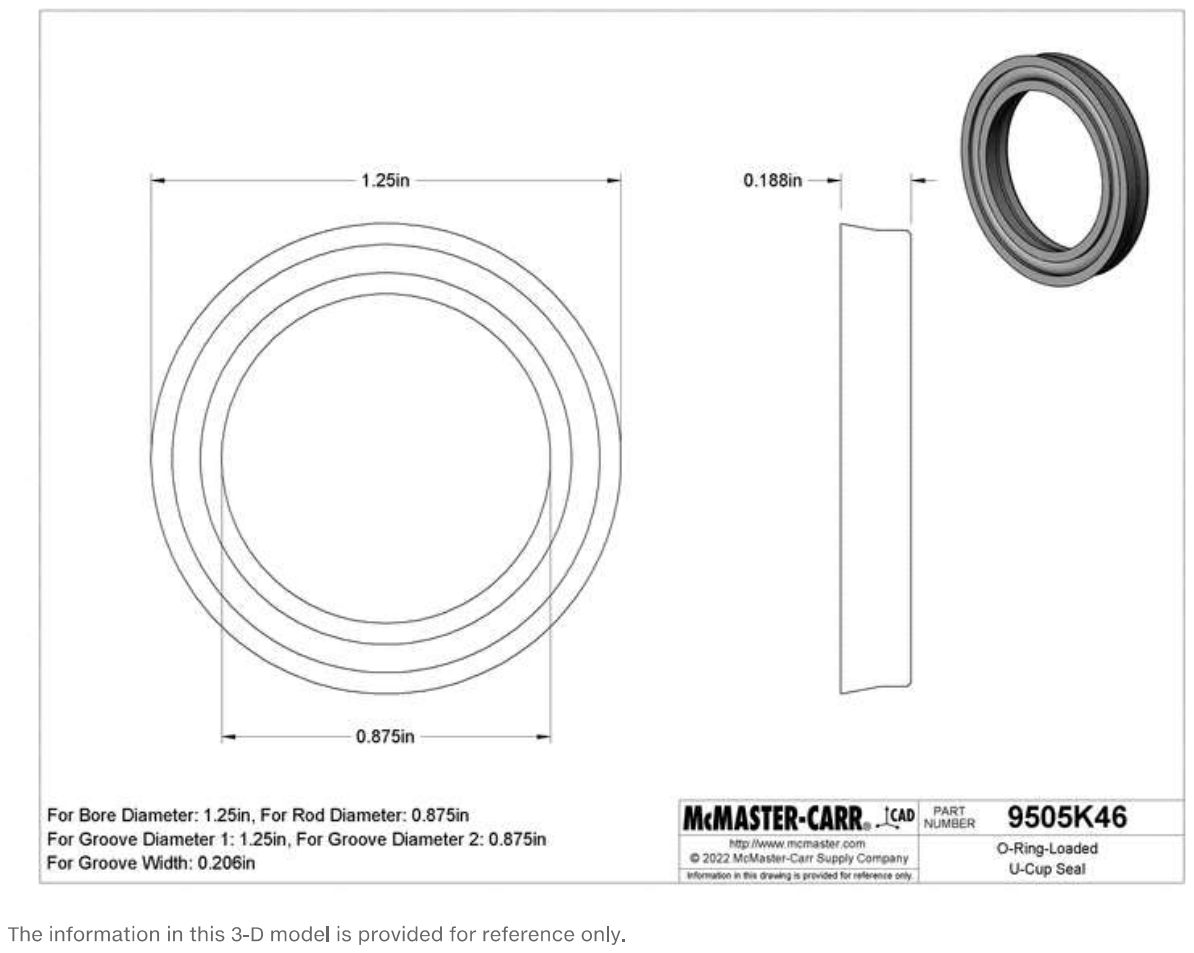
[picture p70: page 3]
