tommyrohmann/Microgravity-Press-Washing-Machine/Sub-System Design and Documentation/3 Wash Chamber Assembly/Oustide Seals.pdf

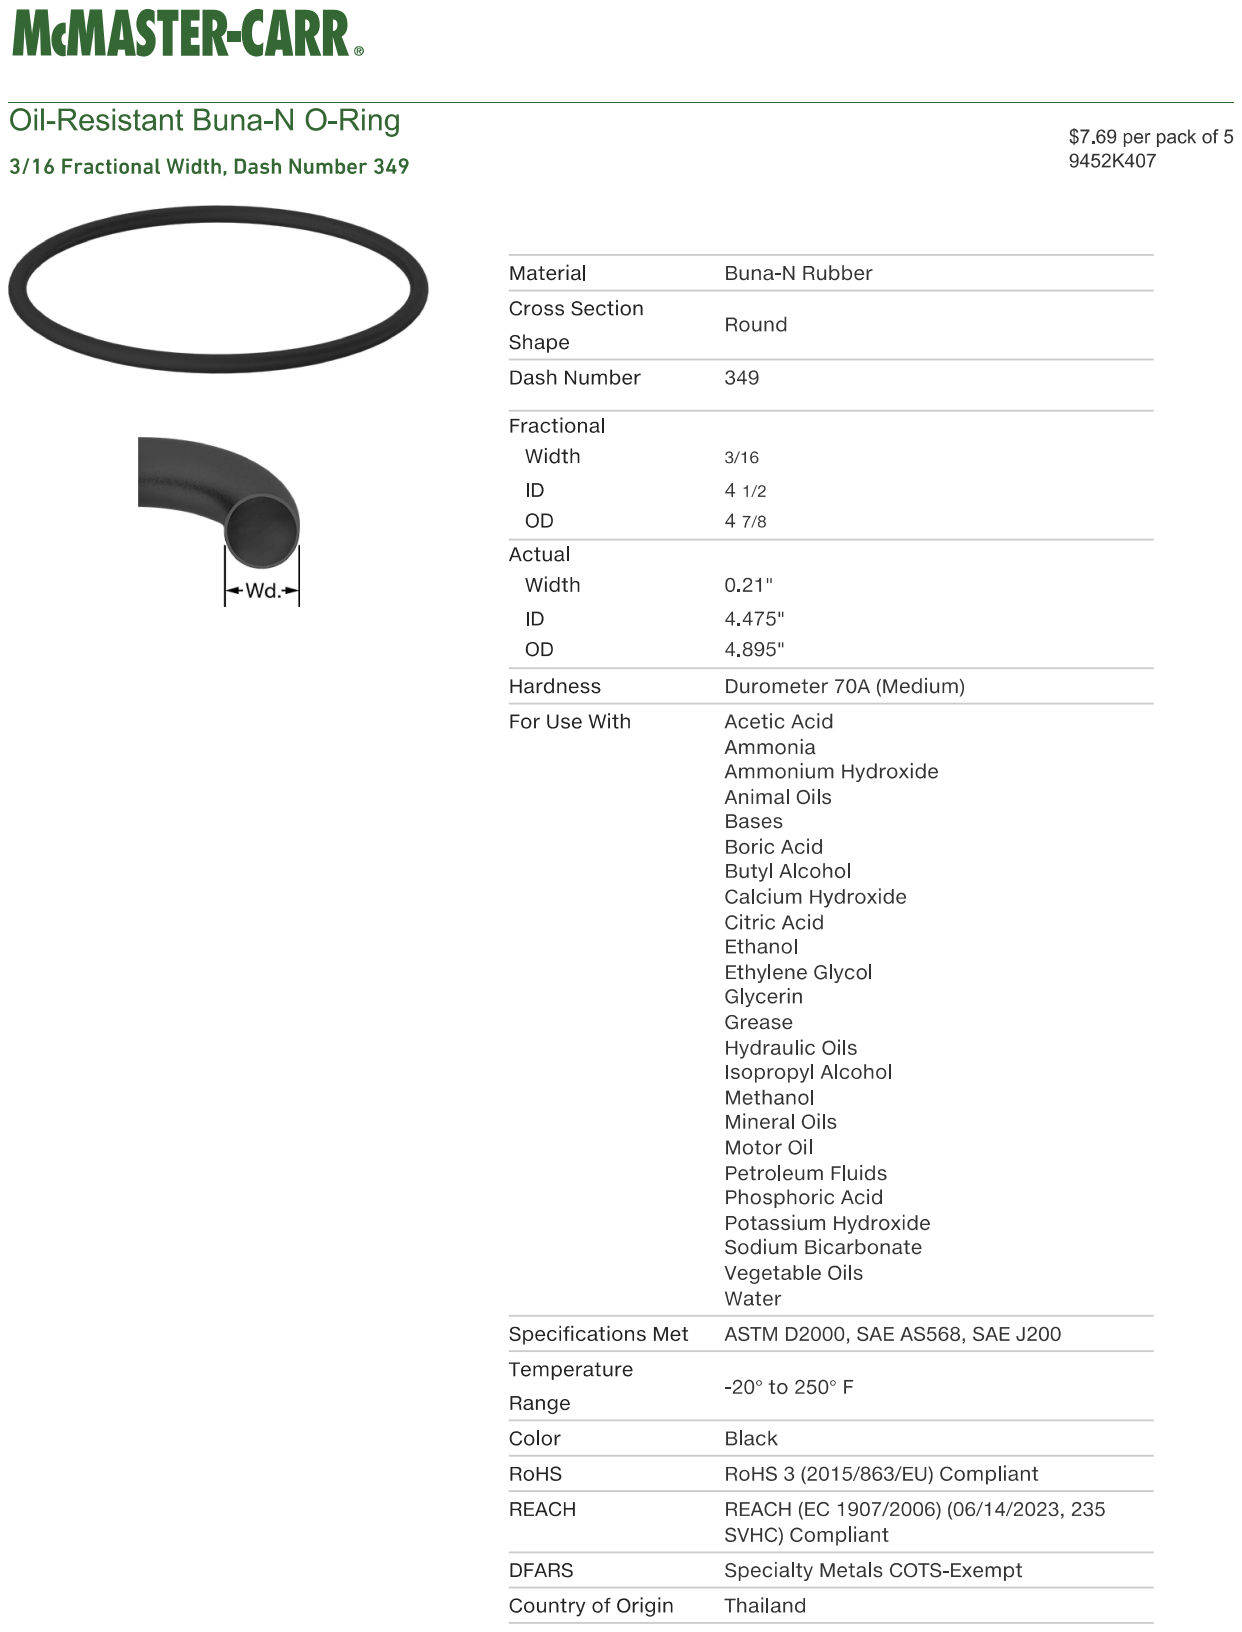
[picture p71: page 1]

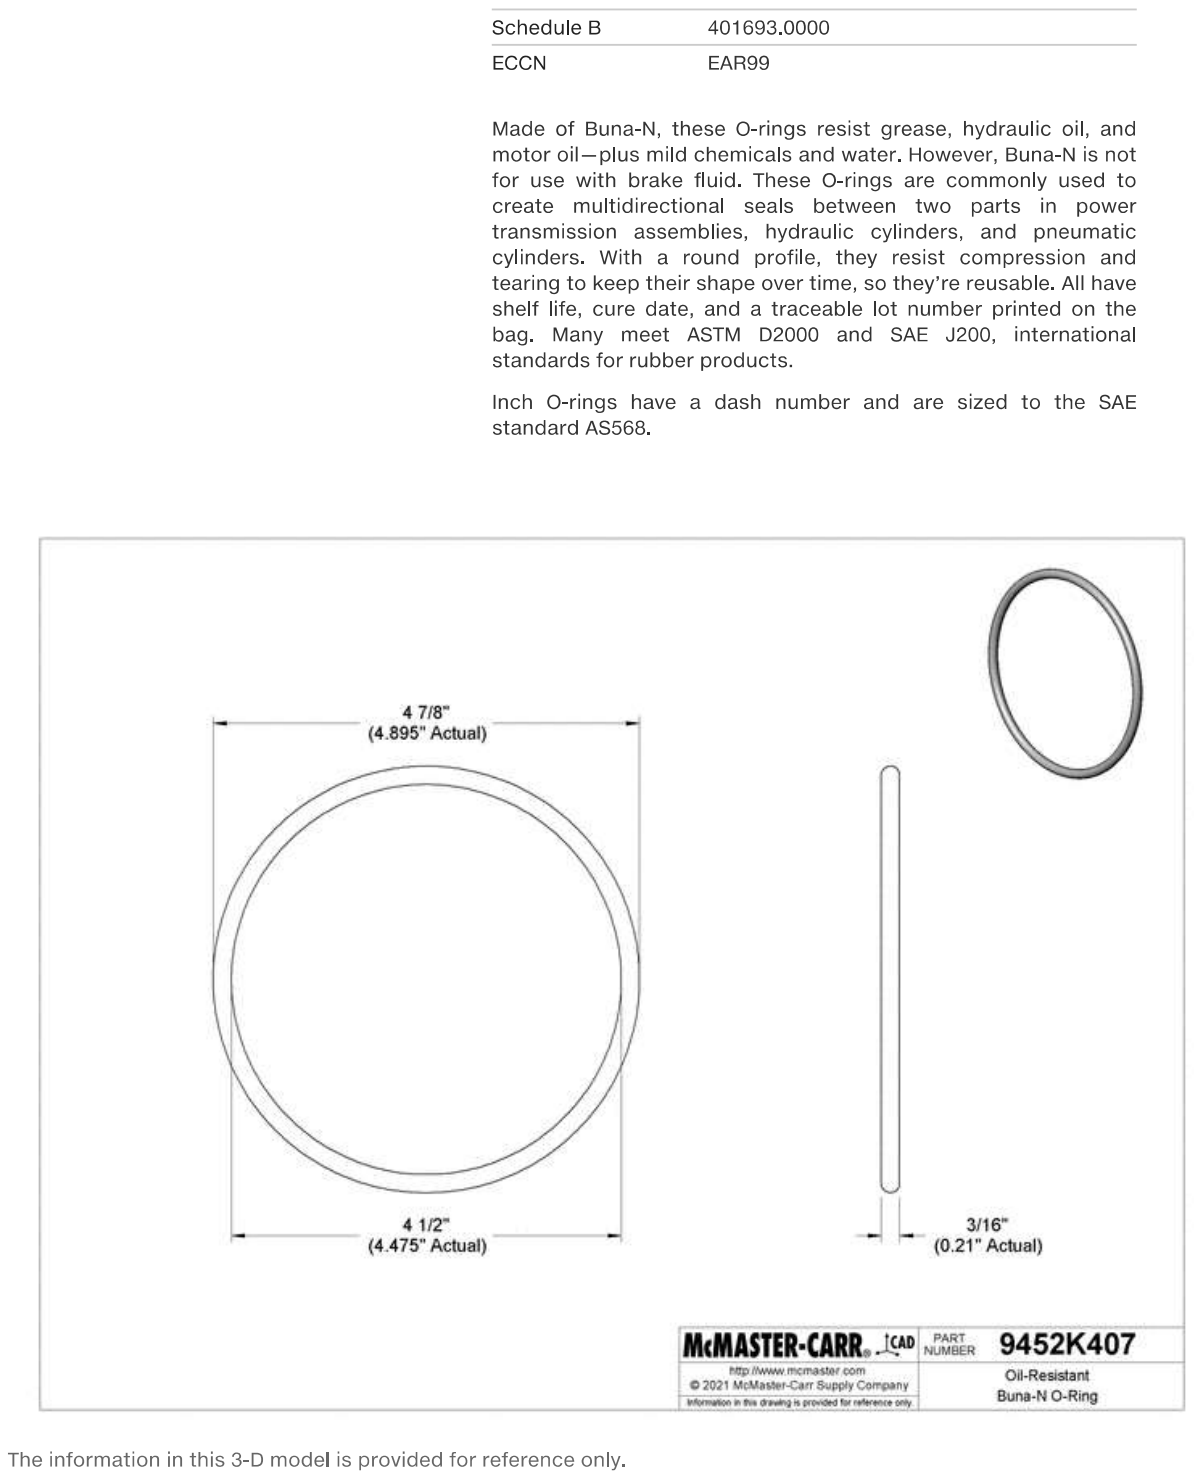
[picture p72: page 2]
