tommyrohmann/Microgravity-Press-Washing-Machine/Code/ESP32 Code Blocks/Serial Communication/RPI_RX/RPI_RX.ino

string incomingData = "";

void setup() {
  // Start the serial communication at 115200 baud rate
  Serial.begin(9600);

  // Wait for the serial port to connect (optional, mostly for boards with native USB like ESP32)
  while (!Serial) {
    delay(10);
  }
  Serial.println("ESP32 Serial Monitor Ready!");
}

void loop() {
  // Check if data is available in the serial buffer
  if (Serial.available()) {
    // Read the incoming data as a string
    incomingData = Serial.readStringUntil('\n'); // Reads until a newline character
  }

  if (Serial.availableForWrite() && ){
    Serial.println("Received: " + incomingData);      // Print the received data
  }
}
