tommyrohmann/Microgravity-Press-Washing-Machine/(commit log)

2023-02-09 Create Servo Actuated Ball Valves.ipt
    [Servo Actuated Ball Valves.ipt]
2023-03-16 Working Ball Valve Actuators
    [Handle Servo Interface.0002.ipt, Handle Servo Interface.0003.ipt, Handle Servo Interface.ipt]
2023-03-17 Update Handle Servo Interface.stl
    [Handle Servo Interface.stl]
2023-03-18 Update to Servo Actuated Ball Valves
    [Ball Valve Mount.0005.ipt, Ball Valve Mount.0007.ipt, Ball Valve Mount.ipt, Ball Valve Mount.stl, Servo Mount.0004.ipt, Servo Mount.0007.ipt, Servo Mount.ipt, Servo Mount.stl]
2023-03-18 Migrated old work for recordkeeping
    [Data Sheet for Preliminary Wash Effectiveness Experimant.xlsx, File Format Test.xlsx, Sample Parts List.xlsx, Total Project Expenses Post EDD.xlsx, Washing Machine Prototype 2 Initial Testing Data.xlsx, Working Prototype Final Parts List.xlsx]
2023-05-14 update 5/14/23
    [File Format Test.xlsx, Parts List and Cost Analysis.xlsx, Wash_Base_Middle.0002.ipt, Wash_Base_Middle.0003.ipt, Wash_Base_Middle.ipt, Washing Machine Mock Up Assembly.0002.iam, Washing Machine Mock Up Assembly.0003.iam, Washing Machine Mock Up Assembly.iam]
2023-05-14 05/14/23 1
    [File Format Test.xlsx, Washing Machine Prototype 2 Initial Testing Data.xlsx, Washing Machine Sizing Calculations.xlsx]
2023-05-20 05/20/23
    Removed old resources from repository to streamline download and upload process/repository sharing.
    [Access Hatch.0002.ipt, Access Hatch.ipt, Acting Piston.0004.ipt, Acting Piston.ipt, Chamber Top.0002.ipt, Chamber Top.ipt, Data Sheet for Preliminary Wash Effectiveness Experimant.xlsx, File Format Test.xlsx]
2023-08-22 Getting back to work on the project
    [Drawing1.dwg, Drawing1_recover.dwg, Parts List and Cost Analysis.xlsx, Washing Machine Sizing Calculations.xlsx]
2023-08-28 Project Updates
    [Drawing1.dwg, Drawing1_recover.dwg, Washing Machine Sizing Calculations.xlsx]
2024-03-01 Organization of Files
    [Drawing1.dwg, KK_Wash Chamber End Bottom Cast Mold.3mf, Parts List and Cost Analysis.xlsx, Washing Machine Base and Lid.ipt]
2024-03-06 File Organization and Log Update
    [Drive Train Calculations.xlsx]
2024-06-12 Update 06-12-24
    [1 Bottom Frame Base 1.ipt, 1 Carbon Steel Acme Lead Screw.0001.ipt, 1 Carbon Steel Acme Lead Screw.ipt, 1 Piston Seal 4 OD O-Ring-Loaded U-Cup Seal.ipt, 1 Wash Chamber Conduit.0001.ipt, 1 Wash Chamber Conduit.0009.ipt, 1 Wash Chamber Conduit.ipt, 2 Bottom Frame Base 2.ipt]
2024-06-12 Sync 6/12/24
    [Parts List and Cost Analysis.xlsx]
2024-10-13 Organization Update
    [1 Bottom Frame Base 1.ipt, 1 Carbon Steel Acme Lead Screw.0001.ipt, 1 Carbon Steel Acme Lead Screw.ipt, 1 Piston Seal 4 OD O-Ring-Loaded U-Cup Seal.ipt, 1 Wash Chamber Conduit.0001.ipt, 1 Wash Chamber Conduit.0009.ipt, 1 Wash Chamber Conduit.0010.ipt, 1 Wash Chamber Conduit.ipt]
2024-10-13 Resolving git issues
    I hope
    [KiCAD Test.kicad_pcb, KiCAD Test.kicad_sch]
2025-10-17 10/16//25
    Moving files around for file path length restrictions and to optimize workflow
    [1 Bottom Frame Base 1.ipt, 1 Carbon Steel Acme Lead Screw.0001.ipt, 1 Carbon Steel Acme Lead Screw.ipt, 1 Piston Seal 4 OD O-Ring-Loaded U-Cup Seal.ipt, 1 Wash Chamber Conduit.0001.ipt, 1 Wash Chamber Conduit.0010.ipt, 1 Wash Chamber Conduit.ipt, 1095K41_Zinc-Plated Steel Grease Fitting.STEP]
2026-01-04 Updating for New Manufacturing Ideas
    [MAIN ASSEMBLY.FCStd, Parts List and Cost Analysis.xlsx, SUB Access Hatch.FCStd, SUBChainTensioner.FCStd, SUBDriveBase.FCStd, SUBDriveNut.FCStd, SUBFrame.FCStd, SUBPowerShaft.FCStd]
2026-01-05 Almost everything blocked in
    [MAIN ASSEMBLY.FCStd, MASTER.FCStd, SUB Access Hatch.FCStd, SUBDriveBase.FCStd, SUBDriveNut.FCStd, SUBFrame.FCStd, SUBPowerShaft.FCStd, SUBReservoirPiston.FCStd]
2026-02-04 Migrating to Laptop post theft
    [FEM Study.FCStd, FEM Wash Arm.step, Load Cell Plate FEA.FCStd, MAIN ASSEMBLY.FCStd, MASTER.FCStd, Parts List and Cost Analysis.xlsx, SUB Access Hatch.FCStd, SUB Top Plate.FCStd]
2026-09-12 Merge V1 and V2 Folder
    I should really learn how to use git/github
    [1 Bottom Frame Base 1.ipt, 1 Carbon Steel Acme Lead Screw.0001.ipt, 1 Carbon Steel Acme Lead Screw.ipt, 1 Piston Seal 4 OD O-Ring-Loaded U-Cup Seal.ipt, 1 Wash Chamber Conduit.0001.ipt, 1 Wash Chamber Conduit.0010.ipt, 1 Wash Chamber Conduit.ipt, 1095K41_Zinc-Plated Steel Grease Fitting.STEP]
